Lileigh/Active-CAD/300 - C Powertrain/350 - Intake/Renders/Intake_assembly_render1.PNG

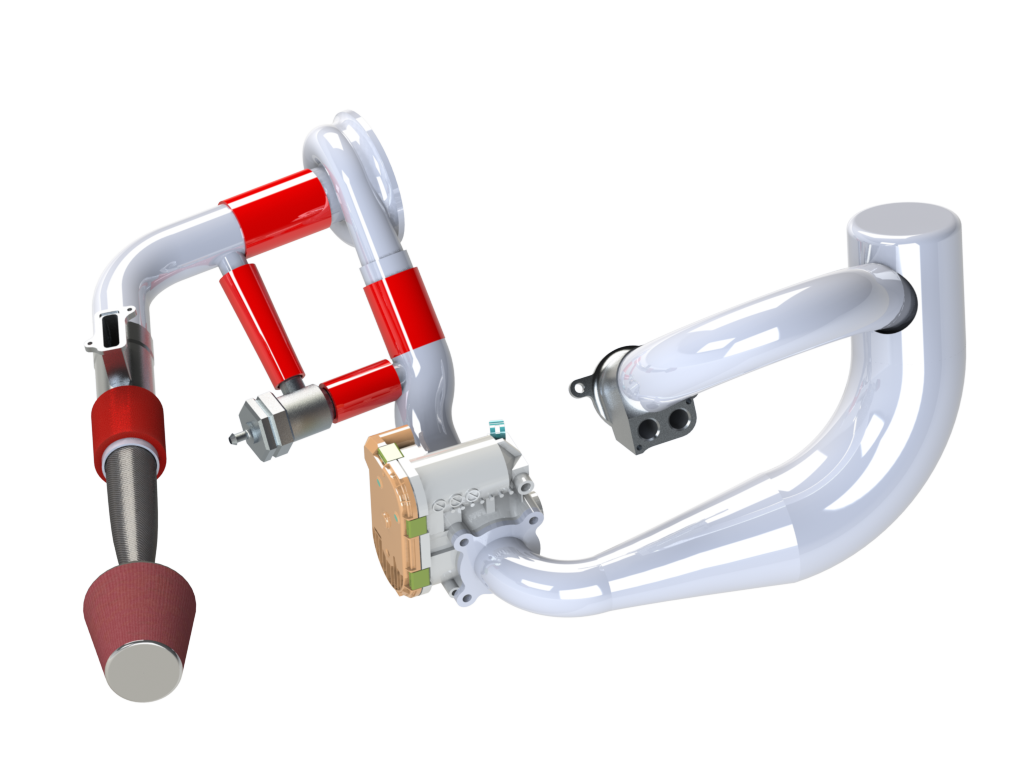
300 - C Powertrain/350 - Intake/Renders/Intake_assembly_render1.PNG
