Lileigh/Active-CAD/300 - C Powertrain/330 - Driveline/SPROCKET DESIGN.pptx

## SPROCKET DESIGN

BY GALEN RILEY

## GOALS

- Create a single piece sprocket
- Maintain critical dimensions so that sprocket fits with the current packaging
- Save weight via design optimization and use of 7075-T6 Aluminum

## GEOMETRY

- The formulas used to calculate the tooth geometry were taken from the American Chain Association Chains for Power Transmission and Material Handling handbook and should be compliant with industry standards…

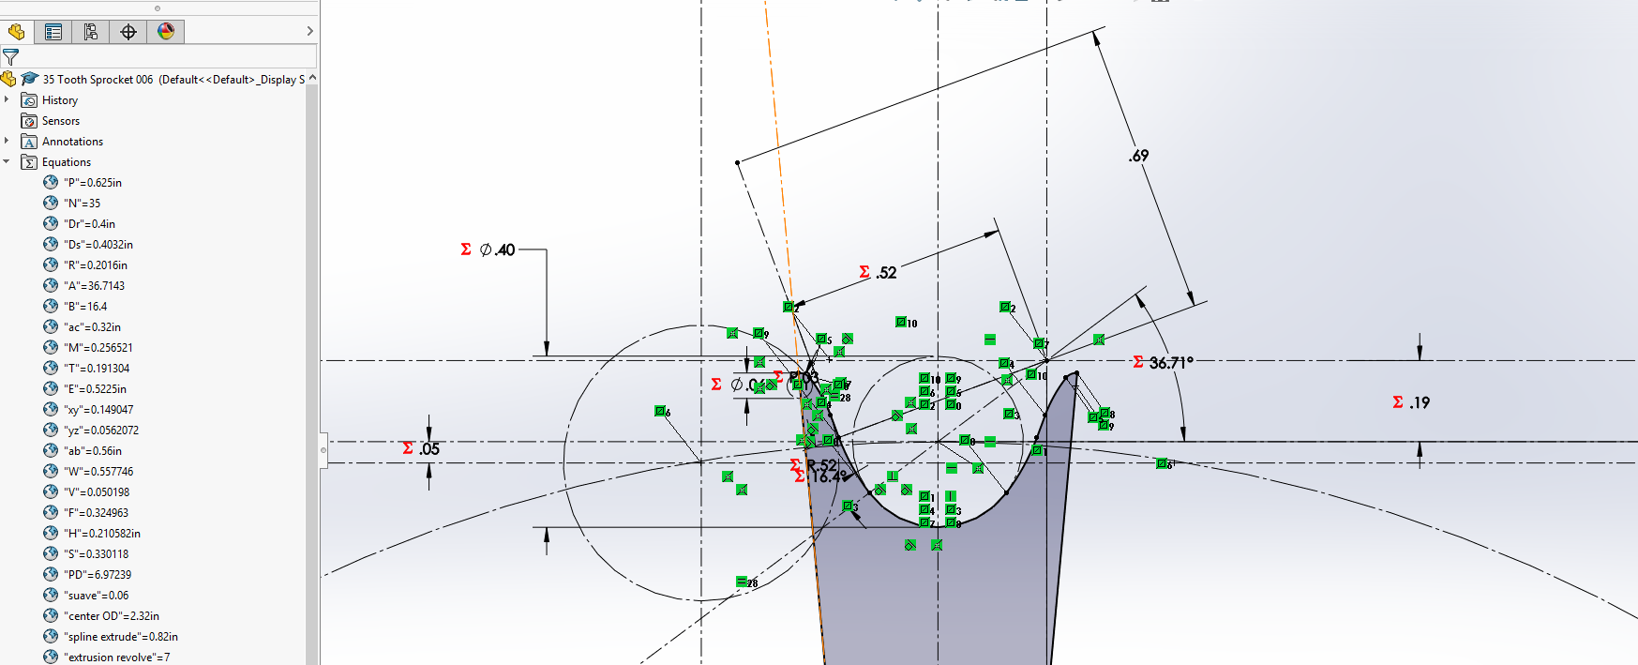
[picture p3: figure]

## SPROCKET LOAD CALCULATIONS

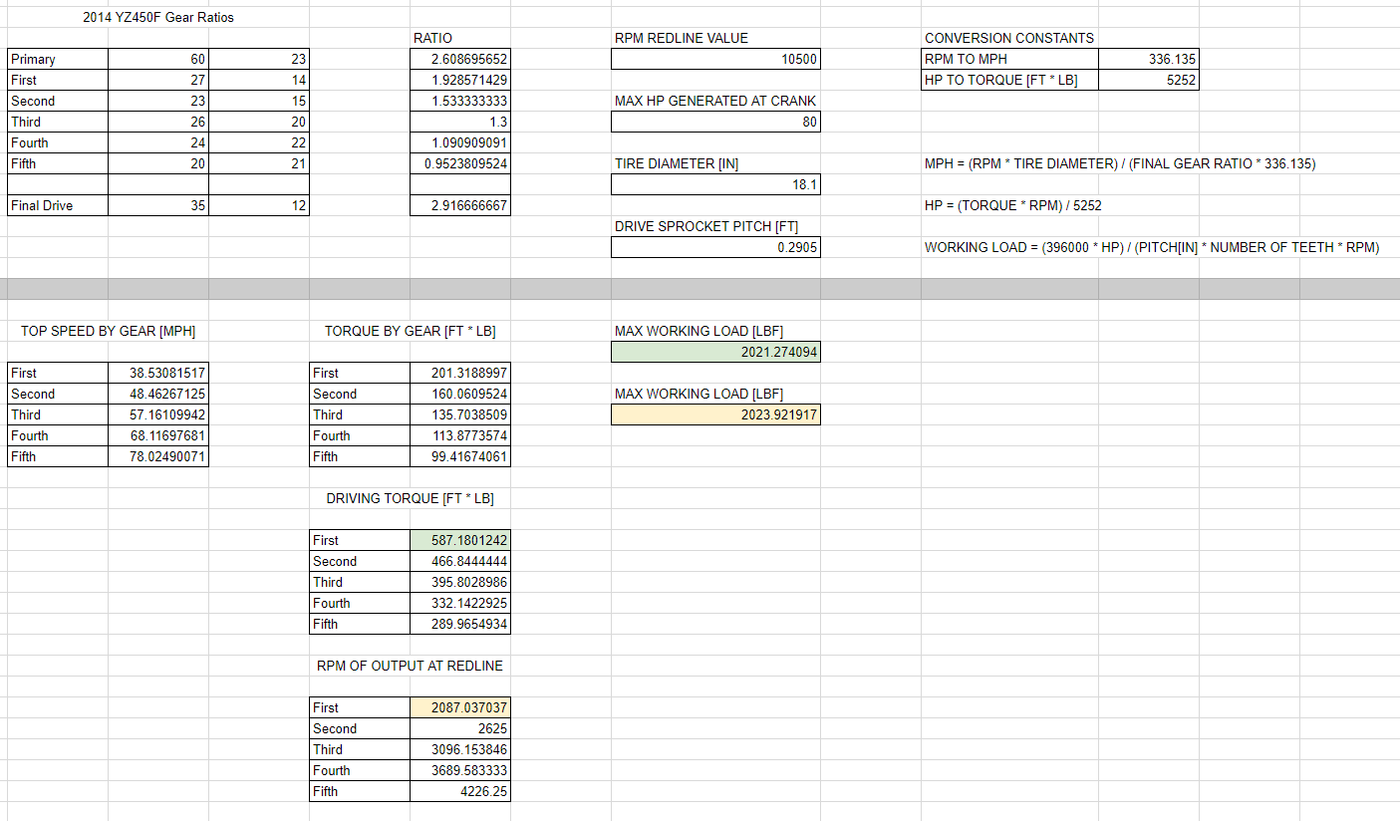
[picture p4: figure]

## LOAD DISTRIBUTION RESEARCH

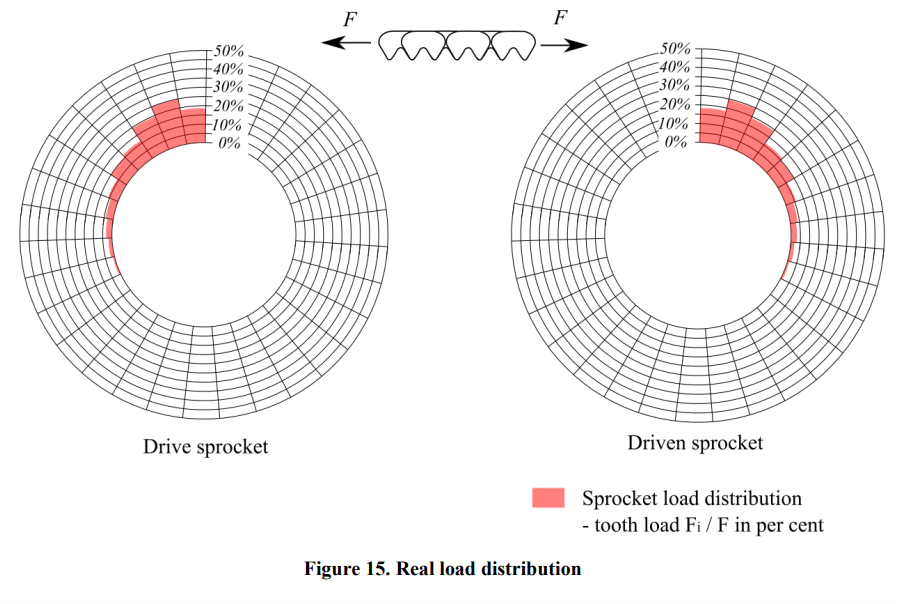
[picture p5: figure]

Research carried out by BorgWarner.

## FEA ANALYSIS IN SOLIDWORKS

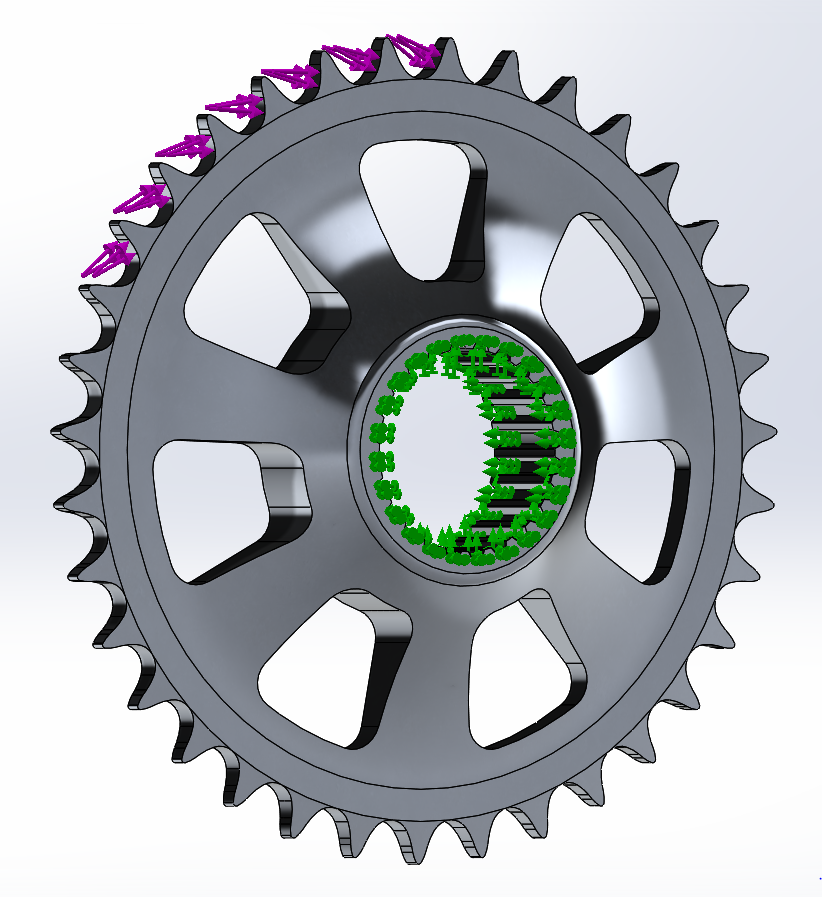
[picture p6: figure]
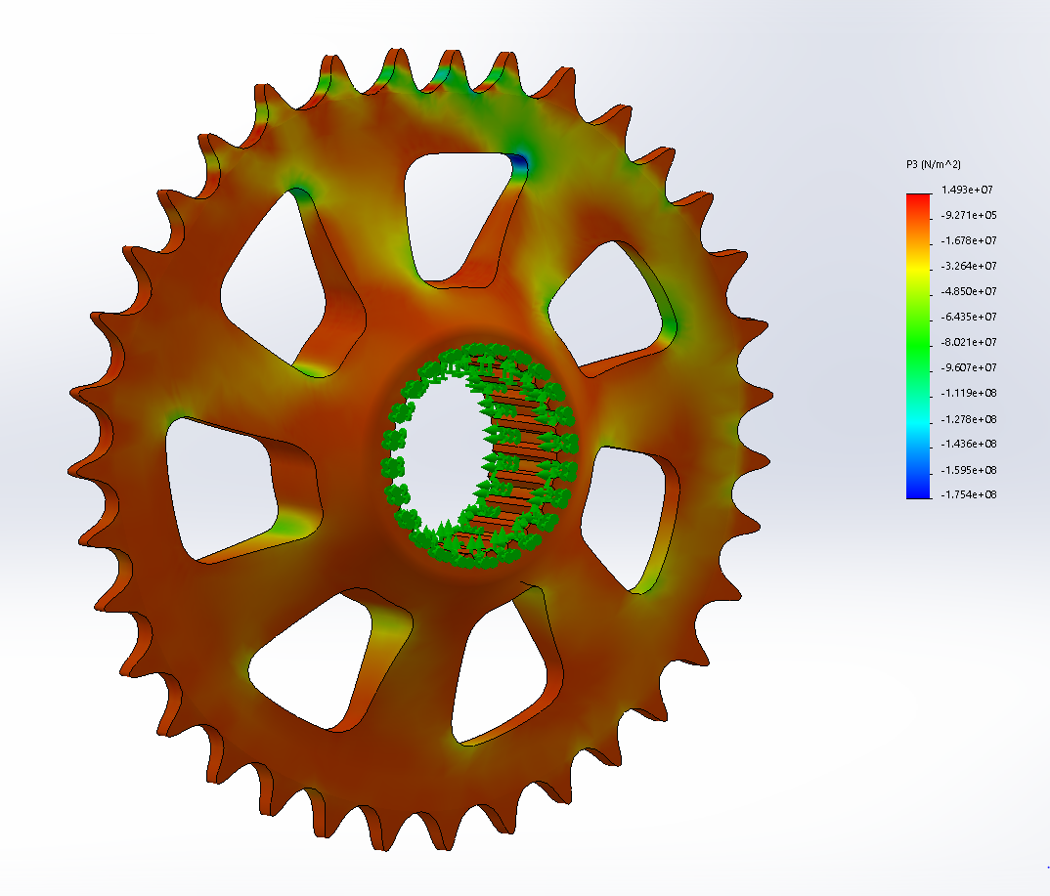
[picture p7: figure]

Force distribution applied
in accordance with
BorgWarner research
Maximum stress values
Observed in Third
Principal Direction
Overall FOS = 2.88

## SOLIDWORKS FATIGUE LIFE SIMULATION

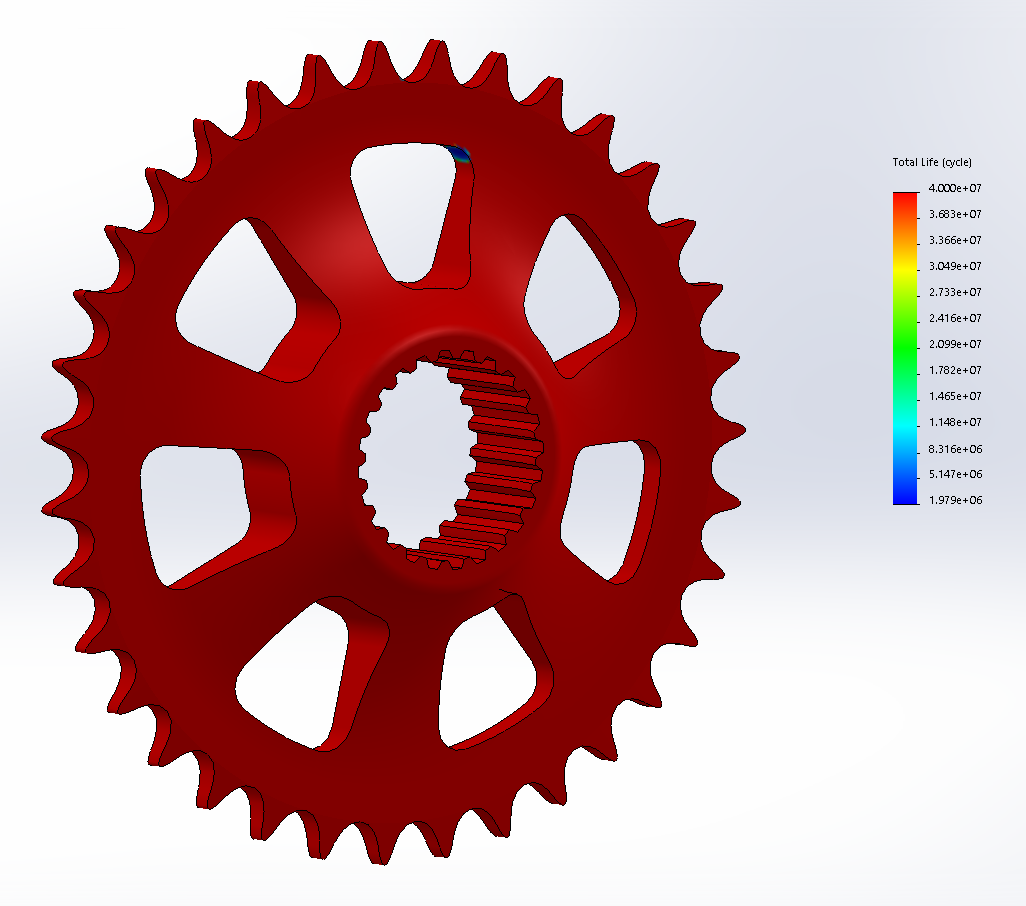
[picture p8: figure]

Revolutions per Endurance Event = 15,600

Solidworks estimated lifespan [cycles] = 1,979,000

Estimated lifespan of sprocket = 127 Endurance Events

Note: Loading events were zero based and scaled by
a factor of two for increased confidence in lifespan

## DYNAMIC LOADING SIMULATIONS

- Simulation of a clutch drop during an average accel. event

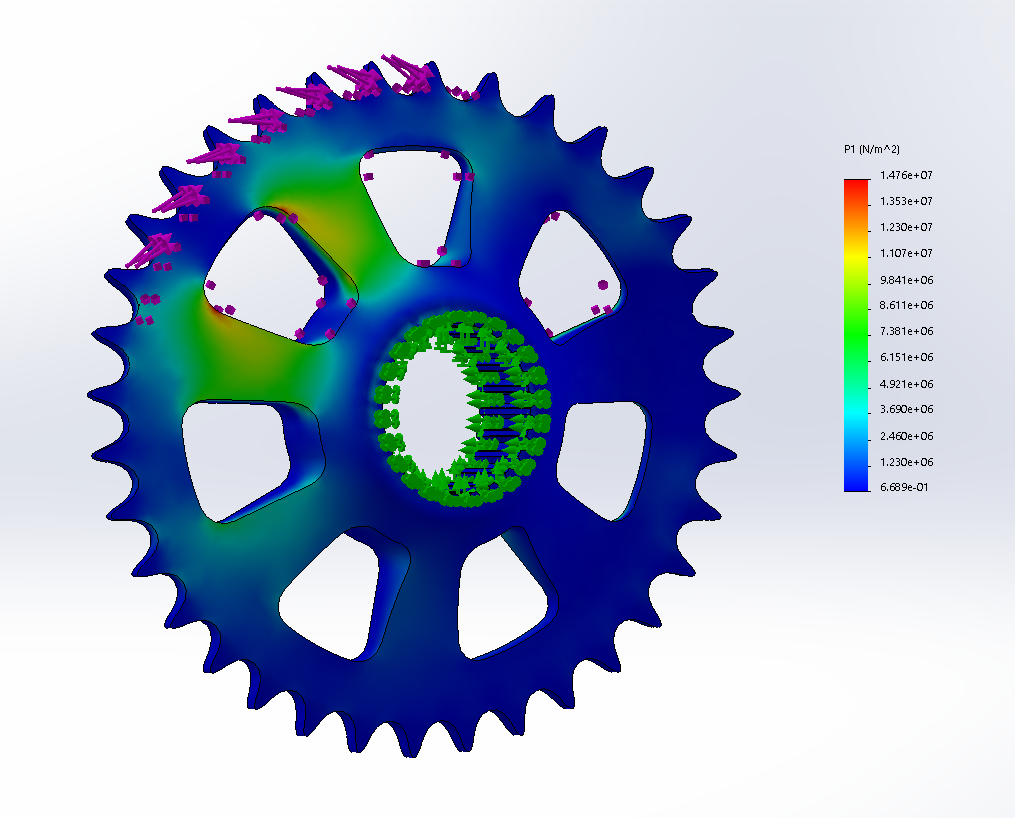
[picture p9: figure]

Maximum first principal stress observed during dynamic loading event

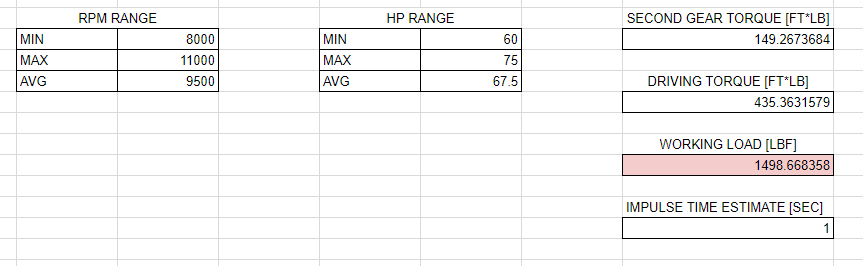
[picture p10: figure]
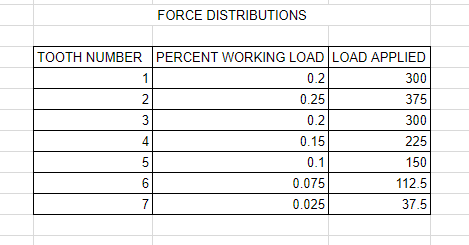
[picture p11: figure]

## LIMITATIONS OF SOLIDWORKS

- Unable to obtain full resolution of dynamic loading scenarios…
- Lacking computing power and disk space to enhance resolution of results

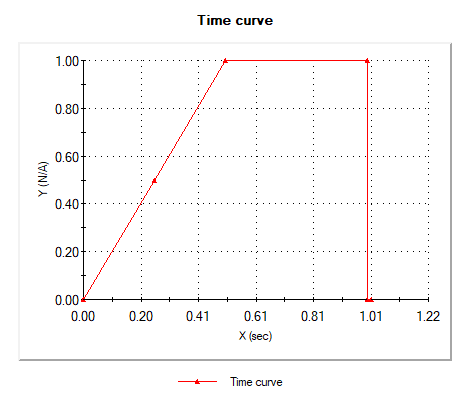
[picture p12: figure]
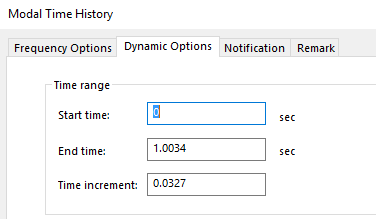
[picture p13: figure]

## CONCLUSION

- Created a single piece sprocket
- Sprocket will fit given packaging constraints
- Estimated sprocket weight = 1.05 lbs
- Two-piece sprocket weight (before hardware) = 1.99 lbs
- Lacking resolutiom in dynamic loading situations
