Lileigh/Active-CAD/300 - C Powertrain/330 - Driveline/SPROCKET FAB/Sprocket Stock.PNG

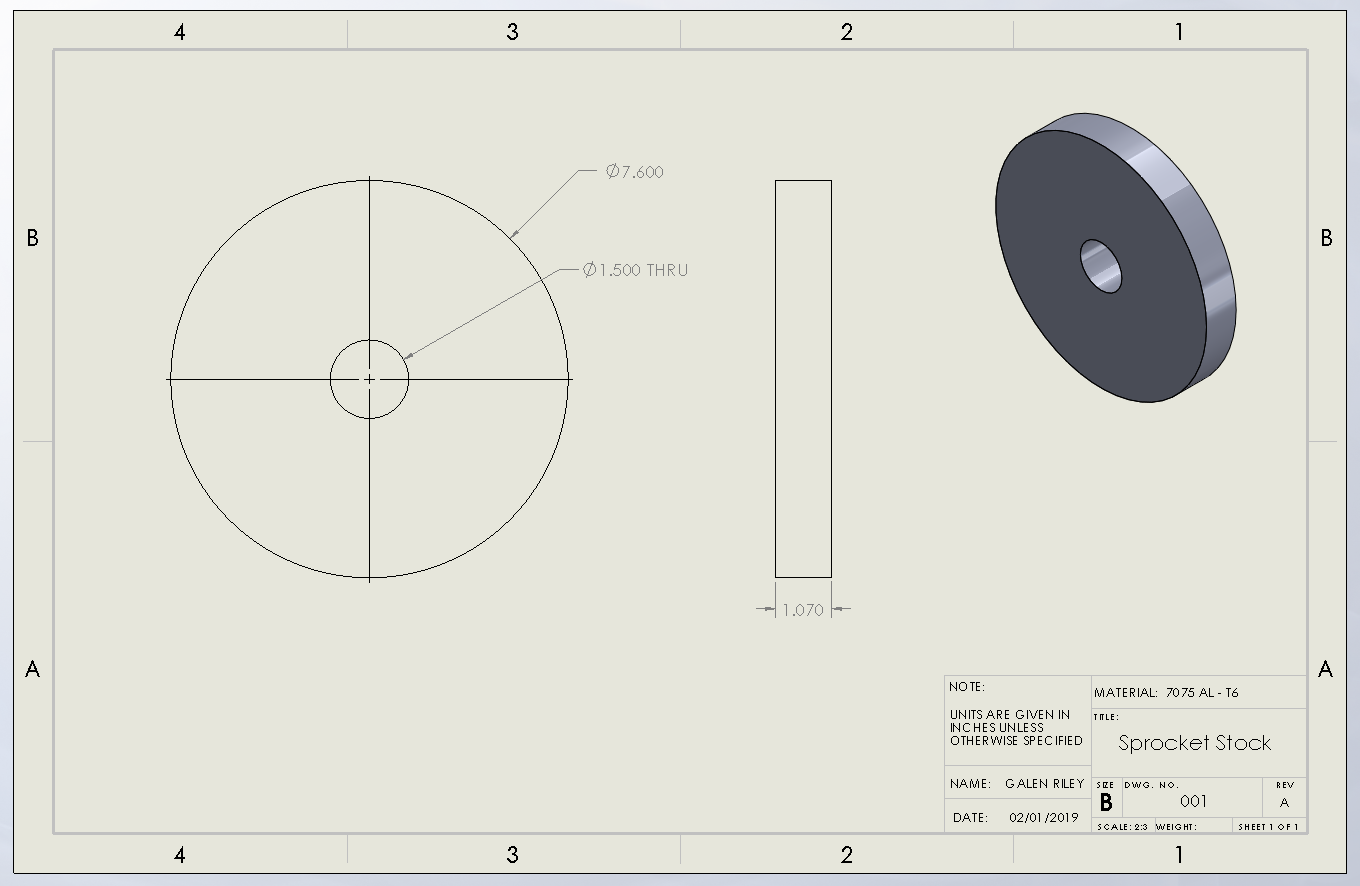
300 - C Powertrain/330 - Driveline/SPROCKET FAB/Sprocket Stock.PNG
