Lileigh/Active-CAD/200 - Chassis/Greenbay Anodizing Order.xlsx

 |  |  |  |  |  | Contact: | Josh Wendt | wendt@go.uwracing.com | (608) 520-7312
Part Number | Part Description | Quantity | Desired Color | Surface Area (in2) | Part Material
240-15-23-A | Wheelnut | 12 | Red |  | 7075 Alu
240-01-17-B | Camber Clevis | 14 | Red |  | 7075 Alu
211-19-23-A | Front Upper Inboard Clevis | 10 | Red |  | 7075 Alu
211-15-23B | Front Lower Inboard Clevis | 10 | Red |  | 7075 Alu
210-03-23B | Rear Inboard Clevis | 14 | Red |  | 7075 Alu
241-15-23-A | Front Toe Clevis | 3 | Red |  | 7075 Alu
242-15-23-A | Rear Toe Clevis | 3 | Red |  | 7075 Alu
 | Modified Rear Inboard | 4 | Red |  | 7075 Alu
 | Front Bellcrank | 8 | Red |  | 6061 Alu
 | Rear Bellcrank | 8 | Red |  | 6061 Alu
 | Front Bellcrank Mounts | 4 | Black |  | 6061 Alu
 | Bellcrank Spacer | 8 | Red |  | 6061 Alu
 | Front Damper Mount | 4 | Black |  | 6061 Alu
