Lileigh/Active-CAD/Manufacturing/Palmer Hamilton/Wisconsin Racing BOM.xlsx

Part Number | Part Name | QTY | Material | Thickness
250-01-11C | Brake Rotor | 5 | Dura-Bar G2 Cast Iron | 0.1 | (Stock provided by Wisconsin Racing as individual rounds)
281-09-22A | MHB Inboard Backing Plate | 2 | Mild steel | 0.1
282-05-22A | AI Backing Plate | 16 | Mild steel | 0.1
261-05-22B | Throttle mount APS | 1 | Mild steel | 0.1
261-07-22B | Throttle mount non-APS | 1 | Mild steel | 0.1
262-03-22A | Brake pedal mount L | 1 | Mild steel | 0.1
262-04-22A | Brake pedal mount R | 1 | Mild steel | 0.1
263-07-22A | Brake OT switch mount | 1 | Mild steel | 0.1
