Lileigh/Active-CAD/Manufacturing/JD Laser Order 222/WR Tube Request 2022.xlsx

Part Number | OD | Thickness | QTY | All 4130 Steel
211-01-22-A | 0.75 | 0.028 | 3
211-03-22-A | 0.75 | 0.028 | 3
211-05-22-A | 0.75 | 0.028 | 3
211-07-22-A | 0.75 | 0.028 | 3
212-01-22-A | 0.75 | 0.028 | 3
212-03-22-A | 0.75 | 0.028 | 3
212-05-22-A | 0.75 | 0.028 | 3
212-07-22-A | 0.75 | 0.028 | 3
223-01-22-A | 0.5625 | 0.035 | 10
223-03-22-A | 0.5625 | 0.035 | 6
223-05-22-A | 0.5625 | 0.035 | 4
223-07-22-A | 0.5625 | 0.035 | 4
280-011-22-A | 1.0000 | 0.095 | 3
280-013-22-A | 1.0000 | 0.065 | 3
280-014-22-A | 1.0000 | 0.065 | 3
280-015-22-A | 1.0000 | 0.065 | 6
BAJA-035 | 1.00 | 0.035 | 1 | 8-foot length of uncut tube if available
BAJA-049 | 1.00 | 0.049 | 1 | 8-foot length of uncut tube if available
