Lileigh/Active-CAD/Manufacturing/Ru-Mar/Request 1/Ru-Mar Wisconsin Racing BOM.xlsx

Part Number | Name | Type | QTY | Material
272-13-22A | Lower Mount Connection | Bent | 1 | 5052 0.125"
272-13-22A | Lower Mount Fork | Flat | 1
381-01-22A | Shift Mount | Bent | 1
381-03-22A | Shift Mount Front Tab | Bent | 2
381-05-22A | Shift Mount Rear Tab | Bent | 2
382-01-22A | Cyl Mount Tab R | Bent | 1
382-02-22A | Cyl Mount Tab L | Bent | 1
Bellcrank Assembly |  | Flat | 1 | 7075 0.625"
Bellcrank & Pedal Rail Assembly |  | Flat | 1
