Lileigh/Active-CAD/200 - Chassis/Drawings/Wisconsin Racing Machining List - Aztalan.xlsx

 |  |  |  |  |  | Contact: | Josh Gottlieb | gottlieb@go.uwracing.com | (414) 807-5917
 |  |  |  |  |  |  | Sam Roslansky | roslansky@go.uwracing.com | (952) 666-9463
 |  |  |  |  |  |  | Joshua Wendt | wendt@go.uwracing.com | (608) 520-7312
Part Number | Part Description | Material | Quantity | Priority | Part Drawing
240-01-17B | Camber Clevis | 7075 Aluminum | 14 | Low
221-01-23A | Front Damper Mount | 7075 Aluminum | 5 | High
390-02-23A | Oil Pan Adaptor | 6061 Aluminum | 2 | High
390-01-23A | Dry Sump Oil Pan | 6061 Aluminum | 2 | High
211-25-23A | Front Lower Inboard Clevis (AN5) | 7075 Aluminum | 5 | High
211-19-23A | Front Upper Inboard Clevis | 7075 Aluminum | 9 | High
