Lileigh/Active-CAD/200 - Chassis/210 - Control Arms/Control Arm Naming Guide.xlsx

Sheet: Parts
21X | -NN | Description | YY | R | 220-21X-XX | QTY | Status
210 - Files that carry over front and rear
 | 01 | Inboard Spherical Plate for PWB-4TG | 17 | B | 210-01B | 16 | Carry Over
 | 03 | Inboard Clevis | 22 | A | 214-01 |  | Done
 | 05 | Inboard Clevis Shim | 22 | A | 214-02 |  | Done | 0.3125 x 4 | 0.125 x 20 | 0.063 x 8 | 0.032 x 8
 | 07 | Inboard Clevis Inner Backing Plate | 22 | A | 280-?? |  | Needs Design
211 - Files specific to front control arms
 | 01 | F Upper Fore Tube | 22 | A | 211-06 | 3 | Done
 | 03 | F Upper Aft Tube | 22 | A | 211-07 | 3 | Done
 | 05 | F Lower Fore Tube | 22 | A | 211-08 | 3 | Done
 | 07 | F Lower Aft Tube | 22 | A | 211-09 | 3 | Done
 | 09 | F Upper OB Spherical Plate for HAB-4TG | 22 | B | 211-02 | 3 | Done | 444 (Tens) Fore, 5 (Tens) Aft |  |  |  | 271 (Tens) Fore, -130 (Comp) Aft | Attach Fore Tube First
 | 11 | F Lower OB Spherical Plate for HAB-4TG | 22 | A | 211-04 | 3 | Done | 1018 (Tens) Aft, -880 (Comp) Fore |  |  |  | 730 (Tens) Aft, -1099 (Comp) Fore | Attach Fore Tube First
 | 13 | F Pushrod Tab | 22 | A | 211-01 | 6 | Done
 | 15 | F Lower Inboard Clevis | 22 | A | 213-07 |  | Needs Design Refresh & FEA Run
 | 17 | F Lower Aft Inboard Clevis Spacer | 22 | A | New Part |  | Needs Design
 | 19 | F Lower Aft Inboard Clevis Backing | 22 | A |  |  | Needs Design
212 - Files specific to rear control arms
 | 01 | R Upper Fore Tube | 22 | A | 212-07 | 3 | Done
 | 03 | R Upper Aft Tube | 22 | A | 212-08 | 3 | Done
 | 05 | R Lower Fore Tube | 22 | A | 212-09 | 3 | Done
 | 07 | R Lower Aft Tube | 22 | A | 212-10 | 3 | Done
 | 09 | R Upper Outboard Spherical Plate | 22 | A | 212-02B | 3 | Done | 626 (Tens) Aft, -495 (Comp) Fore |  |  |  | 524 (Tens) Aft, -569 (Comp) Fore
 | 11 | R Lower Outboard Spherical Plate | 22 | A | 212-04B | 3 | Done | 1388 (Tens) Fore, -936 (Comp) Aft |  |  |  | 1212 (Tens) Fore, -1099 (Comp) Aft
 | 13 | R Pushrod Tab | 22 | A | 212-01 | 6 | Done
 | 15 | R Inner Tierod Mount | 17 | B | 212-06B | 3 | Carry Over

Sheet: Lug Calc Screenshots
210 - Files that carry over front and rear
 | 01 | Inboard Spherical Plate for PWB-4TG
 | 03 | Inboard Clevis
 | 05 | Inboard Clevis Shim
 | 07 | Inboard Clevis Inner Backing Plate
211 - Files specific to front control arms
 | 01 | F Upper Fore Tube
 | 03 | F Upper Aft Tube
 | 05 | F Lower Fore Tube
 | 07 | F Lower Aft Tube
 | 09 | F Upper OB Spherical Plate for HAB-4TG
 | 11 | F Lower OB Spherical Plate for HAB-4TG
 | 13 | F Lower OB Reinforcing Plate
 | 15 | F Pushrod Tab
 | 17 | F Lower Inboard Clevis
 | 19 | F Lower Aft Inboard Clevis Spacer
 | 21 | F Lower Aft Inboard Clevis Backing
212 - Files specific to rear control arms
 | 01 | R Upper Fore Tube
 | 03 | R Upper Aft Tube
 | 05 | R Lower Fore Tube
 | 07 | R Lower Aft Tube
 | 09 | R Upper Outboard Spherical Plate
 | 11 | R Lower Outboard Spherical Plate
 | 13 | R Pushrod Tab
 | 15 | R Inner Tierod Mount
