Lileigh/Active-CAD/Manufacturing/Ru-Mar/Request 2/Wisconsin Racing Revised Ru-Mar Request.xlsx

Part Number | Name | Type | QTY | Material | Thickness
272-13-22A | Lower Mount Connection | Bent | 1 | 5052 | 0.125
272-15-22A | Lower Mount Fork | Flat | 1
381-01-22A | Shift Mount | Bent | 1
381-03-22A | Shift Mount Front Tab | Bent | 2
381-05-22A | Shift Mount Rear Tab | Bent | 2
382-01-22A | Cyl Mount Tab R | Bent | 1
382-02-22A | Cyl Mount Tab L | Bent | 1
210-05-22B | Suspension Shim 0.25 deg | Flat | 8 | 6061 | 0.032
240-03-17B | Camber Shim 0.25 deg | Flat | 6
211-17-22A | Lower Suspension Spacer | Flat | 6
210-05-22B | Suspension Shim 0.5 deg | Flat | 8 | 6061 | 0.063
240-03-17B | Camber Shim 0.5 deg | Flat | 14
250-05-11B | Brake Float Tab | Flat | 30
283-210-03 | Suspension Backing | Flat | 14 | 6061 | 0.08
283-211-15 | Lower F. Susp Backing | Flat | 2
283-273-23 | Lower Steer Backing | Flat | 2
283-272-07 | Upper Steer Backing | Flat | 3
283-221-01 | F Bellcrank Backing | Flat | 5
283-222-01 | R Fore Bellcrank Backing | Flat | 2
283-222-03 | R Aft Bellcrank Backing | Flat | 2
283-335-06 | Diff R Backing | Flat | 1
283-335-05 | Diff L Single Backing | Flat | 3
283-310-15 | Lower Engine Backing | Flat | 2
283-310-03 | Upper Engine R Backing | Flat | 1
283-263-03 | Pedal Brake Side Backing | Flat | 1
283-263-05 | Pedal Single Backing | Flat | 4
210-05-22B | Suspension Shim 1 deg | Flat | 20 | 6061 | 0.125
240-03-17B | Camber Shim 1 deg | Flat | 14
211-17-22A | Lower Suspension Spacer | Flat | 6
240-03-17B | Camber Shim 2 deg | Flat | 6 | 6061 | 0.25
230-13-22-A | Antiroll Mid Plate | Flat | 6
210-05-22B | Suspension Spacer | Flat | 4 | 6061 | 0.3125
