Lileigh/Active-CAD/(list of files, cad)

Other CAD files:
000 - Full Vehicle/1000 - Full Vehicle/1000-5000-23 - Ccar 223.SLDASM
000 - Full Vehicle/1000 - Full Vehicle/1002 - Livery Misc/1000-8000-23 - Assembly for Livery 3-view.SLDASM
000 - Full Vehicle/Three View Drawing/3VD FCA.SLDASM
100 - Aero & Ergo/0 223 Aero Dev Folder/1100 - Aero & Composites/1100-5000-23C - Aero & Composites Assembly CCar.SLDASM
100 - Aero & Ergo/0 223 Aero Dev Folder/1100 - Aero & Composites/1103 - Undertray/1103 - 5000 - 23 - Undertray.SLDASM
100 - Aero & Ergo/0 223 Aero Dev Folder/1100 - Aero & Composites/1104 - Sidepods/1104 - 5000 - 23 - Sidepods.SLDASM
200 - Chassis/200-000-23A.SLDASM
200 - Chassis/2023 Jigs/Front LCA Jig.SLDASM
200 - Chassis/210 - Control Arms/210-00-23-A.SLDASM
200 - Chassis/220 - Actuation/Kaz Ohlins Mk2 Damper/Kaz Ohlins Mk2 Damper Body_Adjustable.SLDASM
200 - Chassis/230 - Antiroll/230-00-22-A.SLDASM
200 - Chassis/230 - Antiroll/Kaz Ohlins Mk2 Damper/Kaz Ohlins Mk2 Damper Body_Adjustable.SLDASM
200 - Chassis/240 - Corners/Ccar/241 - Front Corners/Front/Front Hub Assembly.SLDASM
200 - Chassis/240 - Corners/Ccar/242 - Rear Corners/242-00-23A.SLDASM
200 - Chassis/240 - Corners/Ccar/242 - Rear Corners/Rear/Rear Hub Assembly.SLDASM
200 - Chassis/240 - Corners/Ccar/Cost Report Drawings/Front Upright Assembly.SLDASM
200 - Chassis/240 - Corners/Ecar/240-00-23-Ecar.SLDASM
200 - Chassis/240 - Corners/Ecar/Front Corner/241-00-23-Ecar.SLDASM
200 - Chassis/240 - Corners/Ecar/Rear Corner/242-00-23-Ecar.SLDASM
200 - Chassis/260 - Pedals/260-00-22A.SLDASM
200 - Chassis/270 - Steering/223 Steering/270-00-23-A.SLDASM
200 - Chassis/270 - Steering/223 Steering/273 - Lower Steering/273-00-23A.SLDASM
200 - Chassis/270 - Steering/270-00-22-A.SLDASM
200 - Chassis/270 - Steering/271-New-Steering Wheel/223 SteeringWheel/Electrical Parts/PARTT2M/SOLIDWORKS/T2M_108_01_L_D_RA_WT.sldasm
200 - Chassis/270 - Steering/273 - Lower Steering/273-00-22A.SLDASM
200 - Chassis/280 - Structures/280-00-22-A.SLDASM
200 - Chassis/290 - Data AQ/291 - Tire Temp/291 - Front Left.SLDASM
200 - Chassis/Control Arm/Rear Upper A-Arm.SLDASM
300 - C Powertrain/0 223 Powertrain Dev Folder/1300 - 23 - Powertrain.SLDASM
300 - C Powertrain/301-00-22 B.SLDASM
300 - C Powertrain/330 - Driveline/330-00-23B (Skeleton Assembly).SLDASM
300 - C Powertrain/330 - Driveline/337-Clutch Handle/218-337-00b.SLDASM
300 - C Powertrain/340 - Turbo/340-00-20A.SLDASM
300 - C Powertrain/350 - Intake/351-PreTurbo/Preturbo assembly.SLDASM
300 - C Powertrain/350 - Intake/Misc and Manufacturing/218-352-01 Jig ass.SLDASM
300 - C Powertrain/350 - Intake/Renders/Intake_assembly_render.SLDASM
300 - C Powertrain/360 - Exhaust/360-00-22-A.SLDASM
300 - C Powertrain/360 - Exhaust/362 - Muffler/362-00-20-A.SLDASM
300 - C Powertrain/370 - Cooling/370-00-20A.SLDASM
300 - C Powertrain/370 - Cooling/371 - Radiator/371-00-22A.SLDASM
300 - C Powertrain/370 - Cooling/372 - Hot Bottle/372-00-20A Hot Bottle.SLDASM
300 - C Powertrain/370 - Cooling/373 - Lines/373-00-20A Cooling Lines.SLDASM
300 - C Powertrain/370 - Cooling/376 - Fan/376-00-22A.SLDASM
300 - C Powertrain/380 - Shifting/380-00-22-B.SLDASM
300 - C Powertrain/380 - Shifting/381 - Shift Shaft/381-00-22-B.SLDASM
300 - C Powertrain/380 - Shifting/382 - Cylinder/382-00-22-B.SLDASM
300 - C Powertrain/380 - Shifting/382 - Cylinder/Parker 0.75 x 1/Grainger-49J635.SLDASM
300 - C Powertrain/C Powertrain Dev/1300 - C Powertrain/1300-5000-23 - Powertrain Assembly.SLDASM
400 - E Drivetrain/430 - Cooling/223e-431-000 Cold Plate Connection Assy.SLDASM
400 - E Drivetrain/430 - Cooling/Cold Plate/223e-342-000.SLDASM
400 - E Drivetrain/440 - Dyne/Coupling Assembly/CouplingAssembly.SLDASM
400 - E Drivetrain/450 - Penthouse/Bus Bar Manufacturing/DXFS/0.125 inch Bus Bar Layout.SLDASM
700 - C Electronics/1700 - C Electronics Dev/1703-5000-23 - Accelerometer Assembly.SLDASM
900 - Jigs, Fixtures, Shop Items/Jigs/217-221 cCar Rear Frame/Plates/Engine Case Plates.SLDASM
900 - Jigs, Fixtures, Shop Items/Jigs/219-221 Main Roll Hoop/219-289-00-01.SLDASM
900 - Jigs, Fixtures, Shop Items/Jigs/222 Rotary Bell Crank/Rotary Assemblies/L Fore Rotary Bellcrank.SLDASM
900 - Jigs, Fixtures, Shop Items/Test Fixtures/Anti-Sub Test Fixture/Test Fixture Assembly.SLDASM
Cost Report/Cost-FR-Assem.SLDASM
Manufacturing/Makerspace Waterjetting/5052 0.036 Fueling Parts/Fueling Parts 0.036 5052.SLDASM
Manufacturing/Makerspace Waterjetting/5052 0.063/5052 0.063 Batch 1.SLDASM
Manufacturing/Makerspace Waterjetting/5052 0.1/5052 0.1 Full Batch.SLDASM
Manufacturing/Makerspace Waterjetting/7075 0.5 Rear Bellcrank Mount Spacers/Rear Bellcrank Mount Spacer - 7075 0.5.SLDASM
Manufacturing/Makerspace Waterjetting/7075 0.625/Bellcrank Waterjet Assembly Block B.SLDASM
Manufacturing/Makerspace Waterjetting/Mild 0.1/Mild 0.1 Run 2.SLDASM
Manufacturing/QC Batch 1 222/4130 0.25.SLDASM
Manufacturing/Ru-Mar/Request 1/5052 0.125.SLDASM
Manufacturing/Ru-Mar/Request 1/Parts to Compress/Bellcrank Assembly Single Part.SLDPRT
Manufacturing/Teamlab Waterjetting/222/7075 0.625/Pedal Rail and Bellcrank WJ Assy Redone.SLDASM
Manufacturing/Teamlab Waterjetting/223/Spherical B2.SLDASM
000 - Full Vehicle/1000 - Full Vehicle/1002 - Livery Misc/1001-8001-Chassis scrap assembly for simple 3-view.SLDASM
100 - Aero & Ergo/0 223 Aero Dev Folder/1100 - Aero & Composites/1101 - Front Wing/1101-5007-23 - Goosneck Assembly (right).SLDASM
100 - Aero & Ergo/0 223 Aero Dev Folder/1100 - Aero & Composites/1102 - Nosecone & Aeroshield/1102 - 5000 - 23 - Nosecone & Aeroshield.SLDASM
100 - Aero & Ergo/0 223 Aero Dev Folder/1100 - Aero & Composites/1106 - Headrest Cowling/1106 - 5000 - 23 - Headrest Cowling.SLDASM
100 - Aero & Ergo/0 223 Aero Dev Folder/1100 - Aero & Composites/1107 - Rear Wing/1107 - 5000 - 23 - Rear Wing.SLDASM
200 - Chassis/1200 - Chassis Dev/1220-5000-23 - Actuation Assembly.SLDASM
200 - Chassis/2023 Jigs/Rear UCA Jig.SLDASM
200 - Chassis/220 - Actuation/223 - Adjustment Rods/Pushrods/Front Pushrod.SLDASM
200 - Chassis/230 - Antiroll/Kaz Ohlins Mk2 Damper/Kaz Ohlins Mk2 Damper.SLDASM
200 - Chassis/240 - Corners/Ccar/241 - Front Corners/241-00-23-A.SLDASM
200 - Chassis/240 - Corners/Ccar/Cost Report Drawings/Rear Upright Assembly.SLDASM
200 - Chassis/250 - Brakes/251-00-17B.SLDASM
200 - Chassis/260 - Pedals/261 - Throttle/261-00-22A.SLDASM
200 - Chassis/260 - Pedals/263 - Pedal Rails/263-00-22-A.SLDASM
200 - Chassis/270 - Steering/271 - Steering Wheel/147 - Steering Wheel/220-147-01.SLDASM
200 - Chassis/270 - Steering/271-New-Steering Wheel/223 SteeringWheel/Electrical Parts/PARTserver/PARTserver/SOLIDWORKS/LS2_115_01_F_D.sldasm
200 - Chassis/280 - Structures/282 - Front Structures/282-00-22-A.SLDASM
200 - Chassis/280 - Structures/284 - Aeroshield Mounts/aeroshield assembly.SLDASM
200 - Chassis/Dev Assembly/Dev Assembly.SLDASM
300 - C Powertrain/300-000-22A.SLDASM
300 - C Powertrain/320 - Fueling/321-Tank/321-00-23A.SLDASM
300 - C Powertrain/320 - Fueling/323-Filter/323-00-23-A.SLDASM
300 - C Powertrain/320 - Fueling/Misc and Machining/Oring groove and jig ass.SLDASM
300 - C Powertrain/330 - Driveline/330-00-22A.sldasm
300 - C Powertrain/330 - Driveline/333-CV Joints/D4672-TA.SLDASM
300 - C Powertrain/330 - Driveline/334-Stub Shafts and Half Shafts/219/LHS HALFSHAFT ASSY.SLDASM
300 - C Powertrain/330 - Driveline/335-Mounting/4EXP075/4exp075.SLDASM
300 - C Powertrain/340 - Turbo/340-01-20A Dyno.SLDASM
300 - C Powertrain/350 - Intake/350-00-20A.SLDASM
300 - C Powertrain/350 - Intake/352-PostTurbo/352-00-20A Post Throttle Intake.sldasm
300 - C Powertrain/350 - Intake/358-Air Filter/Rain Shroud/3D Print/Filter_Shroud_print.SLDASM
300 - C Powertrain/370 - Cooling/371 - Radiator/Modine Radiator.SLDASM
300 - C Powertrain/390 - Oiling/391-00-18A Oil Temp_Pressure Block.SLDASM
400 - E Drivetrain/430 - Cooling/Cold Plate/Standoff Hole Mounting Location Assy.SLDASM
400 - E Drivetrain/450 - Penthouse/Bus Bar Manufacturing/DXFS/0.05 inch Upper DC Bus Bar Layout.SLDASM
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
