Lileigh/Active-CAD/300 - C Powertrain/330 - Driveline/SPROCKET FAB/SPROCKET FABRICATION.docx

WISCONSIN RACING FORMULA SAE – SPROCKET FABRICATION PROCESS

UNIVERSITY OF WISCONSIN – MADISON, SPRING 2019

GALEN RILEY

JANUARY 23RD, 2019

1. START WITH STOCK MATERIAL – 8’’ DIA X 3.0’’ ROUND STOCK (7075 – T6 ALUMINUM).
2. SQUARE STOCK USING A LATHE AND TURN DOWN TO 7.6’’ DIAMETER.

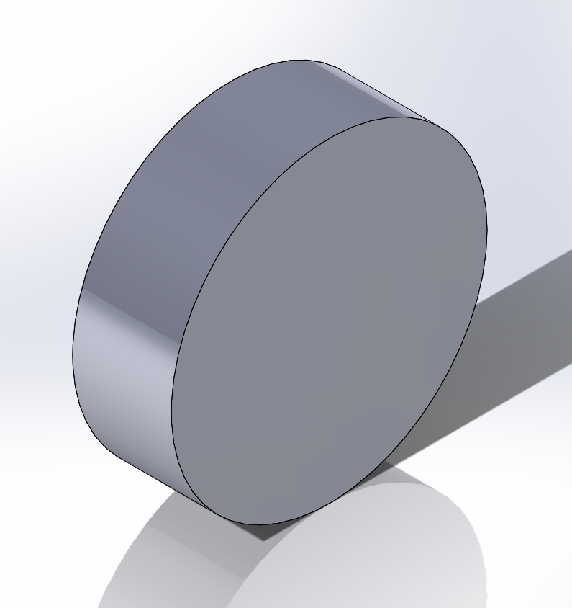
[picture p17: figure]

3. PROCEED TO BORE A HOLE WITH A 1.5’’ DIAMETER.

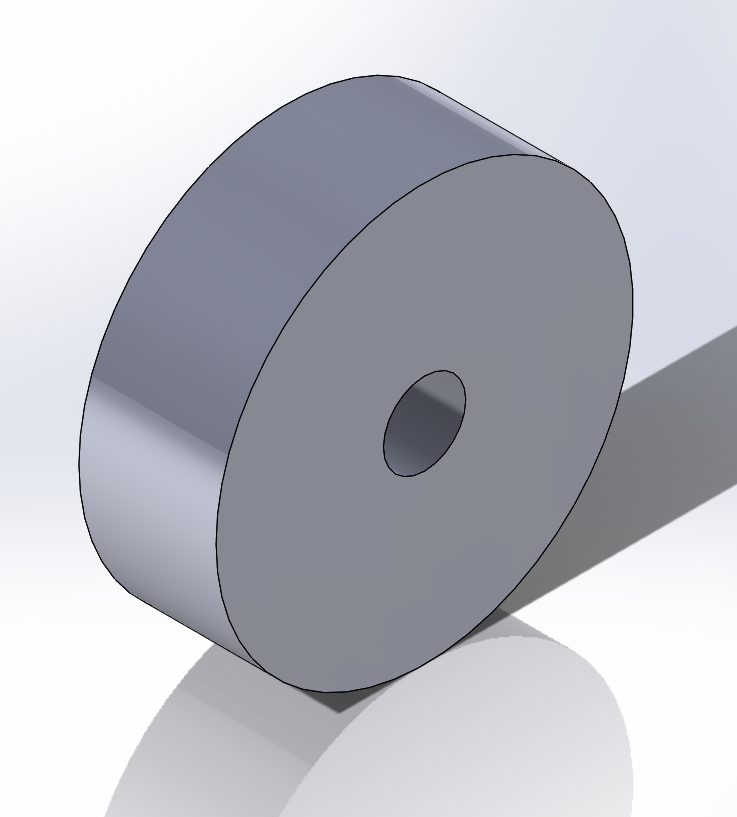
[picture p18: figure]

4. USING THE “T-REX” BAND SAW IN THE STUDENT SHOP, PART THE STOCK EXACTLY IN HALF. YOU SHOULD NOW HAVE TWO PIECE OF STOCK WITH A THICKNESS OF ROUGHLY 1.50’’
5. RETURN TO THE LATHE AND CUT EACH OF THE TWO PIECES DOWN TO THEIR FINAL THICKNESS OF 1.07’’ ENSURING THAT BOTH FACES ON EACH PIECE OF STOCK IS SQUARE.

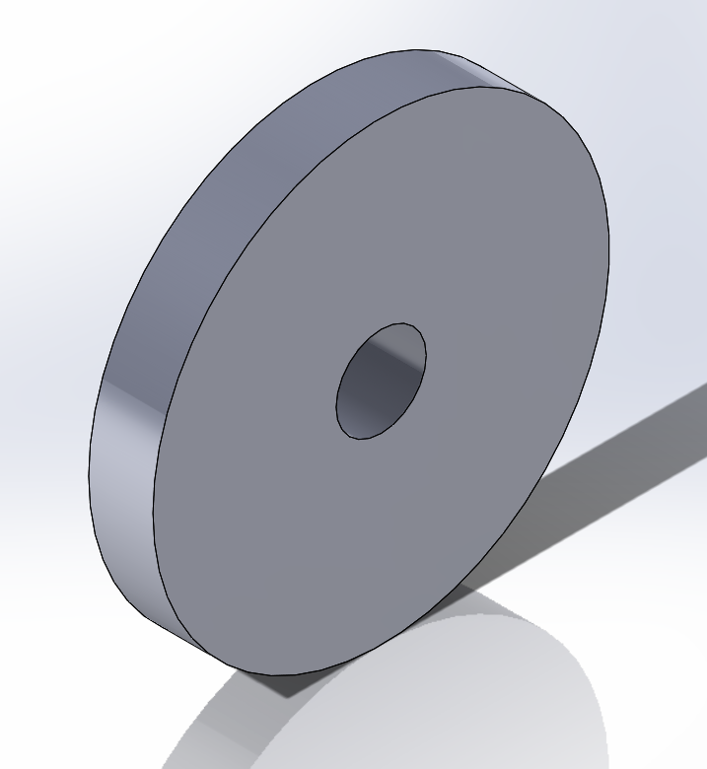
[picture p19: figure]

6. USING THE HAAS (OR A CNC LATHE), CAREFULLY FIXTURE THE PART UTILIZING THE BORED OUT FEATURE AND CUT THE SPROCKET PROFILE GEOMETRY INTO THE STOCK. (SANDING MAY BE REQUIRED).

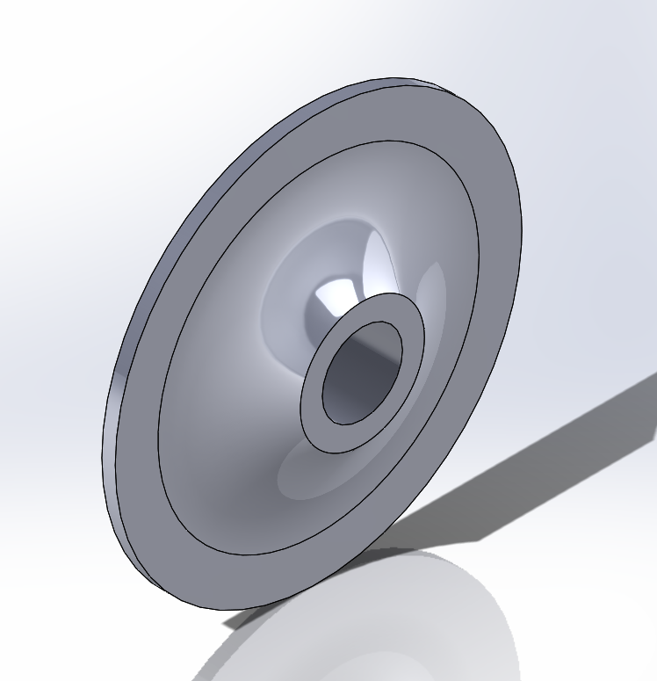
[picture p20: figure]

7. USING THE HAAS (OR A CNC LATHE), USE SIMILAR FIXTURING TECHNIQUES FROM STEP 6 TO CUT THE SPROCKET TOOTH TAPER INTO BOTH SIDES OF THE STOCK. (SANDING MAY BE REQUIRED).

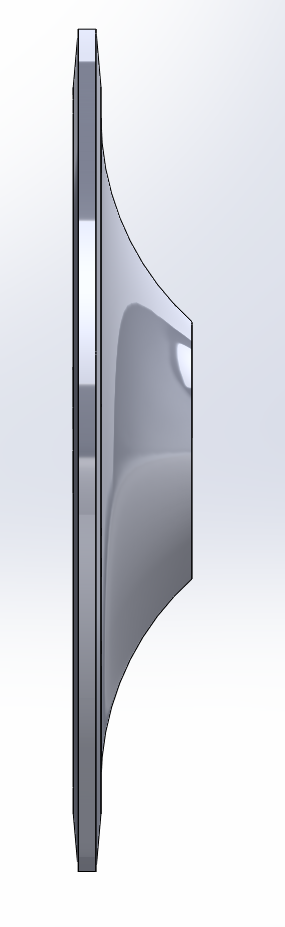
[picture p21: figure]
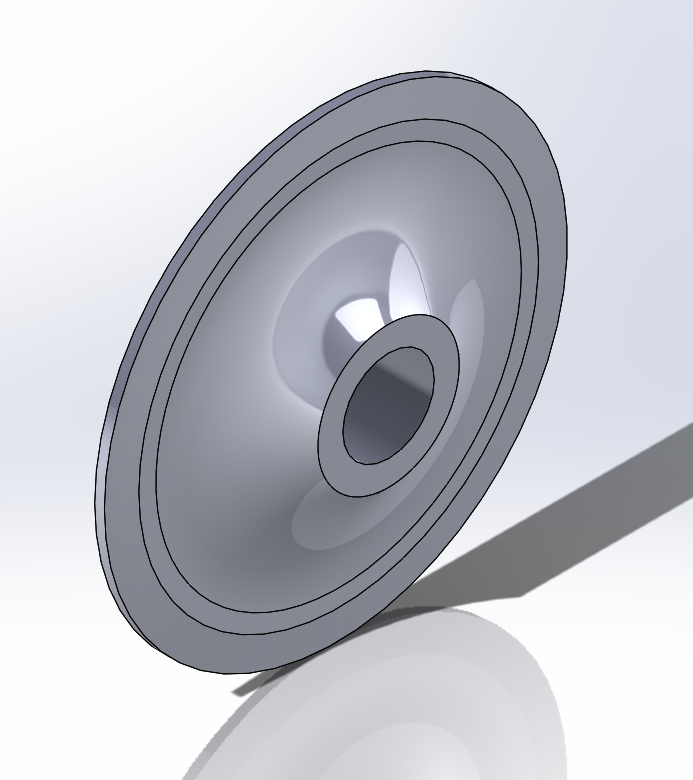
[picture p22: figure]

8. SEND STOCK TO WEASLER TO HAVE THEM WIRE EDM THE DIFFERENTIAL SPLINE GEOMETRY AND THE SPROCKET TOOTH GEOMETRY.
9. USING THE HAAS, CUT THE SPOKE GEOMETRY INTO THE SPROCKET.

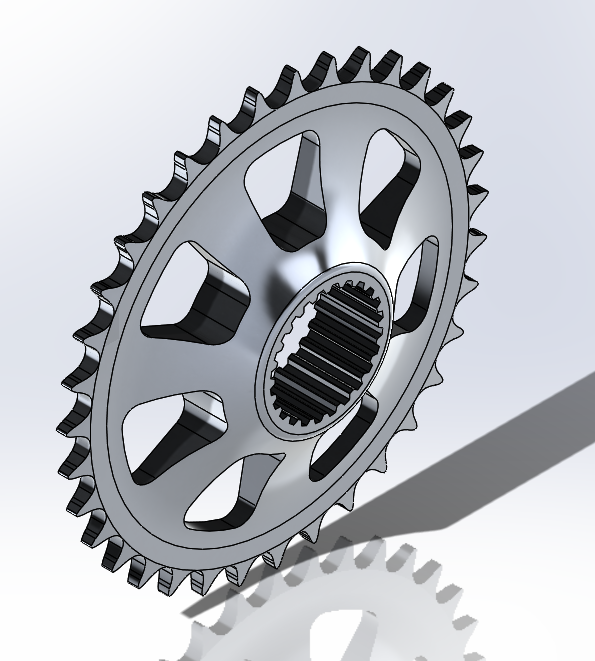
[picture p23: figure]

NOTE: CONSIDER REVERSING STEP 8 AND STEP 9 BASED OFF OF HOW EASY IT IS TO FIXTURE THE PART.
