Lileigh/Active-CAD/300 - C Powertrain/350 - Intake/Renders/Intake_assembly_render.JPG

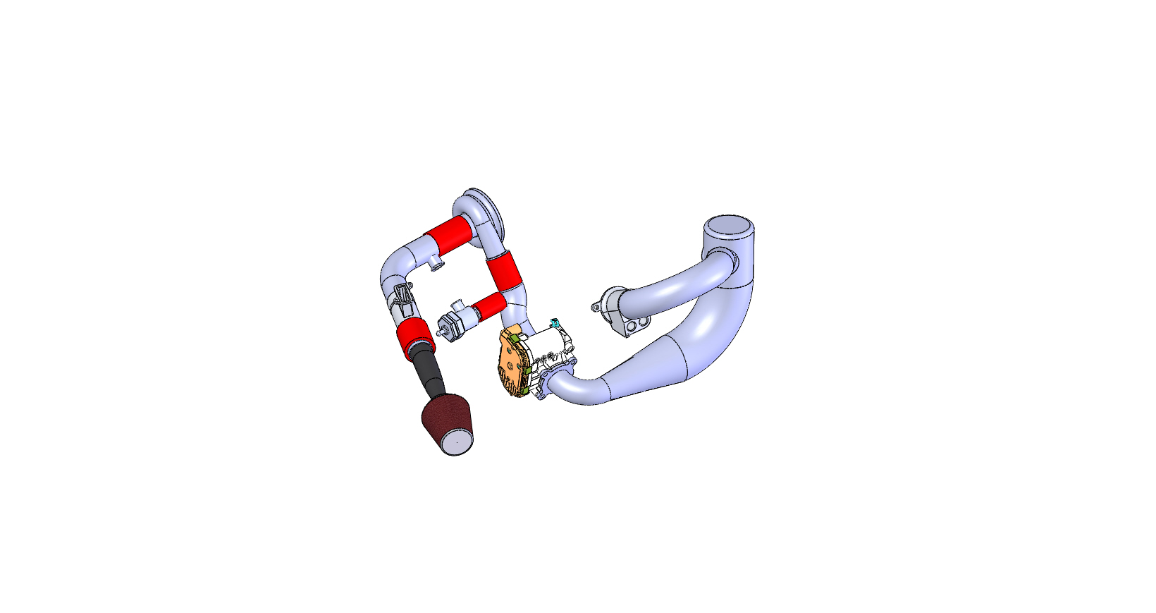
300 - C Powertrain/350 - Intake/Renders/Intake_assembly_render.JPG
