Lileigh/Active-CAD/900 - Jigs, Fixtures, Shop Items/Test Fixtures/Ride Steer Test Fixture/FIX-201-01-22-A rev02.PDF

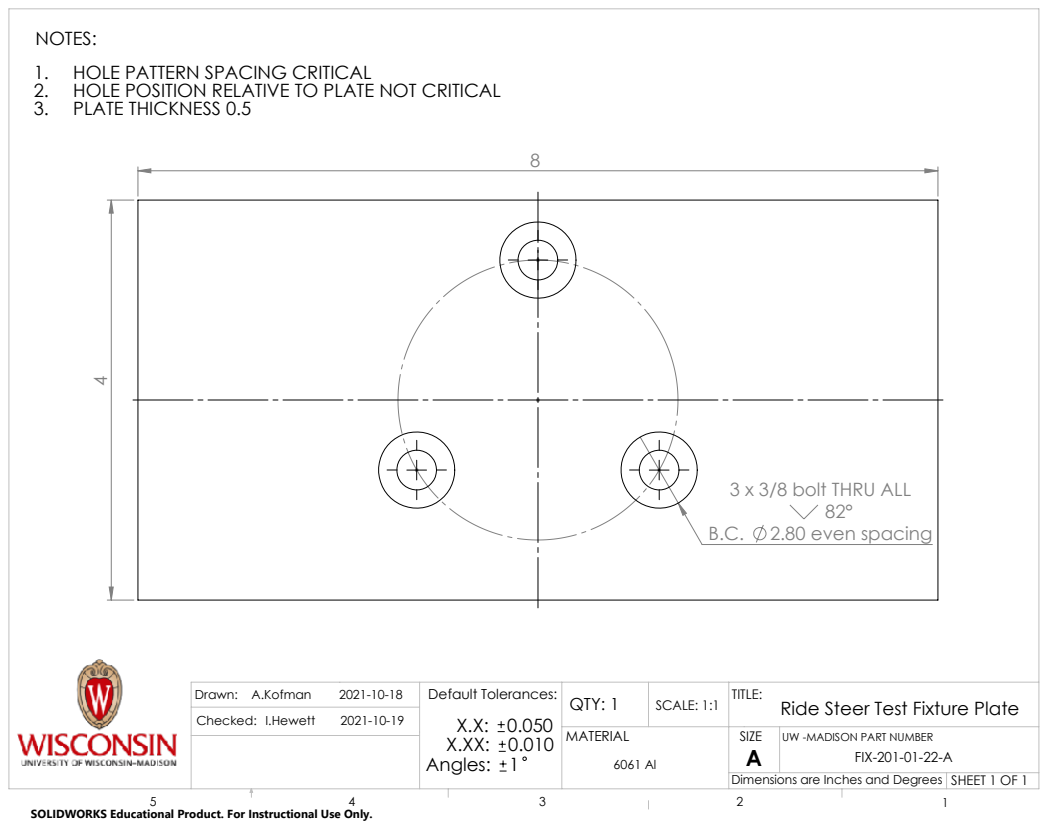
[picture p32: page 1]
SHEET 1 OF 1; SCALE: 1:1; FIX-201-01-22-A 6061 Al; QTY: 1 A.Kofman; Default Tolerances:; Checked: I.Hewett

NOTES:
1. HOLE PATTERN SPACING CRITICAL
2. HOLE POSITION RELATIVE TO PLATE NOT CRITICAL
3. PLATE THICKNESS 0.5

3 x 3/8 bolt THRU ALL
B.C. 2.80 even spacing

TITLE:
Ride Steer Test Fixture Plate
SIZE
UW -MADISON PART NUMBER
Dimensions are Inches and Degrees

SOLIDWORKS Educational Product. For Instructional Use Only.
