Lileigh/Active-CAD/900 - Jigs, Fixtures, Shop Items/Test Fixtures/Ride Steer Test Fixture/FIX-201-01-22-A.pdf

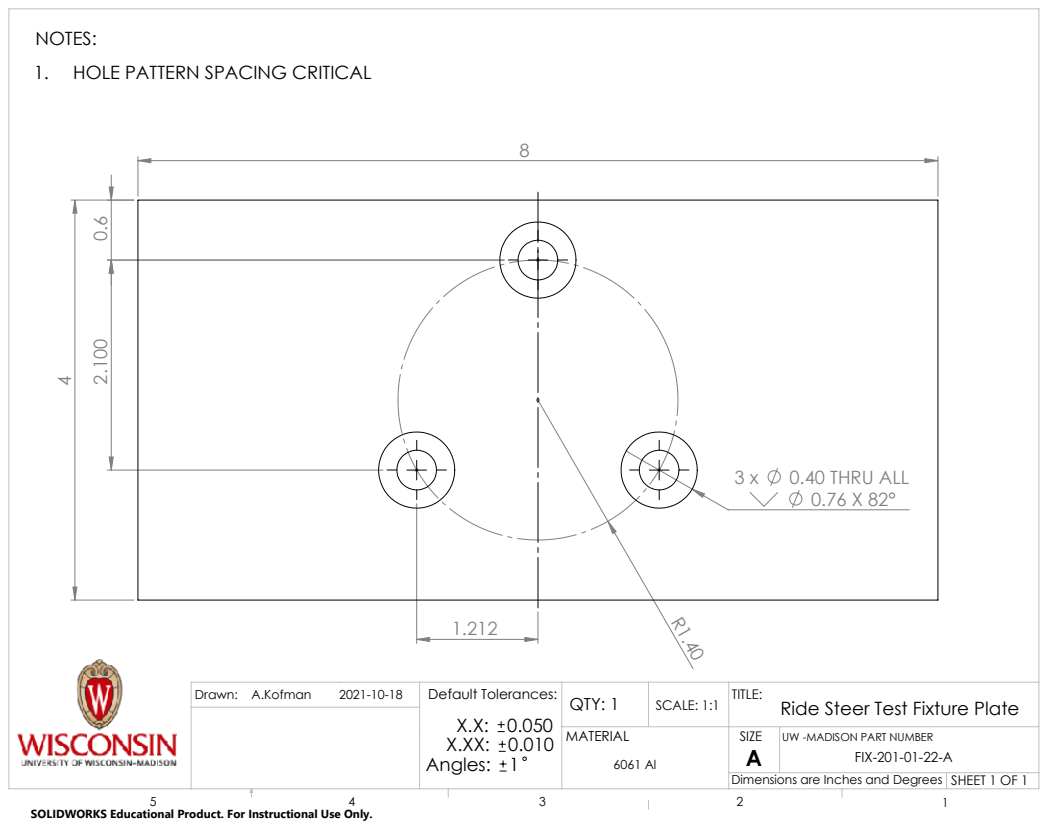
[picture p33: page 1]
0.40 THRU ALL; SHEET 1 OF 1; SCALE: 1:1; FIX-201-01-22-A 6061 Al; QTY: 1 A.Kofman; Default Tolerances:

NOTES:
1. HOLE PATTERN SPACING CRITICAL

TITLE:
Ride Steer Test Fixture Plate
SIZE
UW -MADISON PART NUMBER
Dimensions are Inches and Degrees

SOLIDWORKS Educational Product. For Instructional Use Only.
