Lileigh/Active-CAD/Cost Report/Cost-FR-Assem.pdf

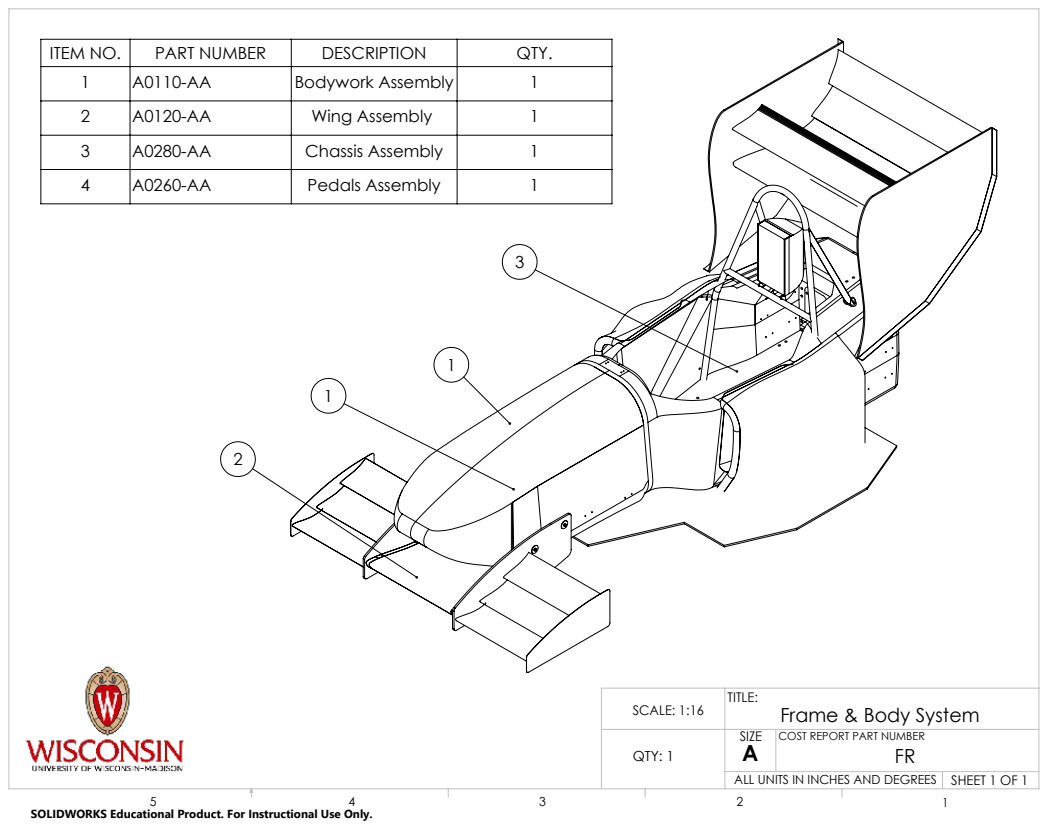
[picture p34: page 1]
SHEET 1 OF 1; SCALE: 1:16; QTY: 1

ITEM NO. | PART NUMBER | DESCRIPTION | QTY.
1 | A0110-AA | Bodywork Assembly | 1
2 | A0120-AA | Wing Assembly | 1
3 | A0280-AA | Chassis Assembly | 1
4 | A0260-AA | Pedals Assembly | 1

TITLE:
Frame & Body System
SIZE
COST REPORT PART NUMBER

ALL UNITS IN INCHES AND DEGREES

SOLIDWORKS Educational Product. For Instructional Use Only.
