Lileigh/Active-CAD/200 - Chassis/Drawings/217-246-01 Tierod Tube Insert.pdf

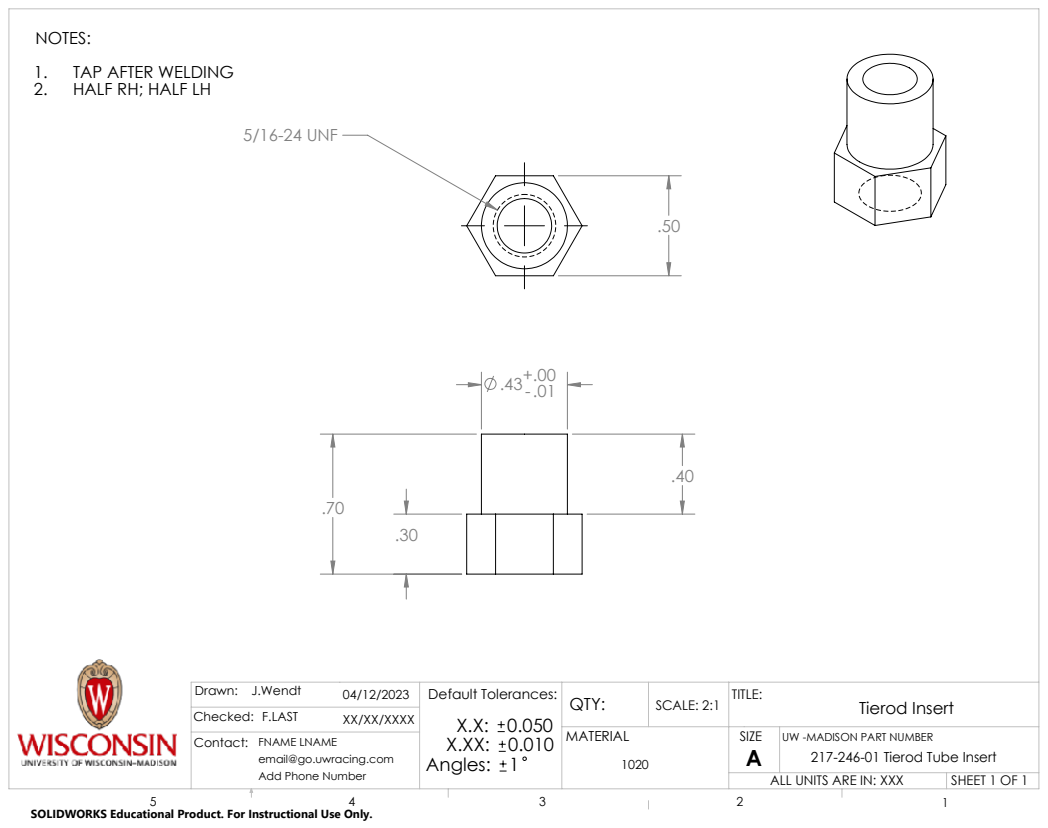
[picture p35: page 1]
5/16-24 UNF; SHEET 1 OF 1; SCALE: 2:1; Tierod Insert; Checked: F.LAST; XX/XX/XXXX; 04/12/2023 Default Tolerances:; Angles:; 1 email@go.uwracing.com

NOTES:
1. TAP AFTER WELDING
2. HALF RH; HALF LH

Drawn:
Contact: FNAME LNAME

TITLE:
ALL UNITS ARE IN: XXX

SIZE
UW -MADISON PART NUMBER
217-246-01 Tierod Tube Insert

Add Phone Number

SOLIDWORKS Educational Product. For Instructional Use Only.
