Lileigh/Active-CAD/200 - Chassis/Drawings/217-246-06 Front Tierod Adjustment Bolt.pdf

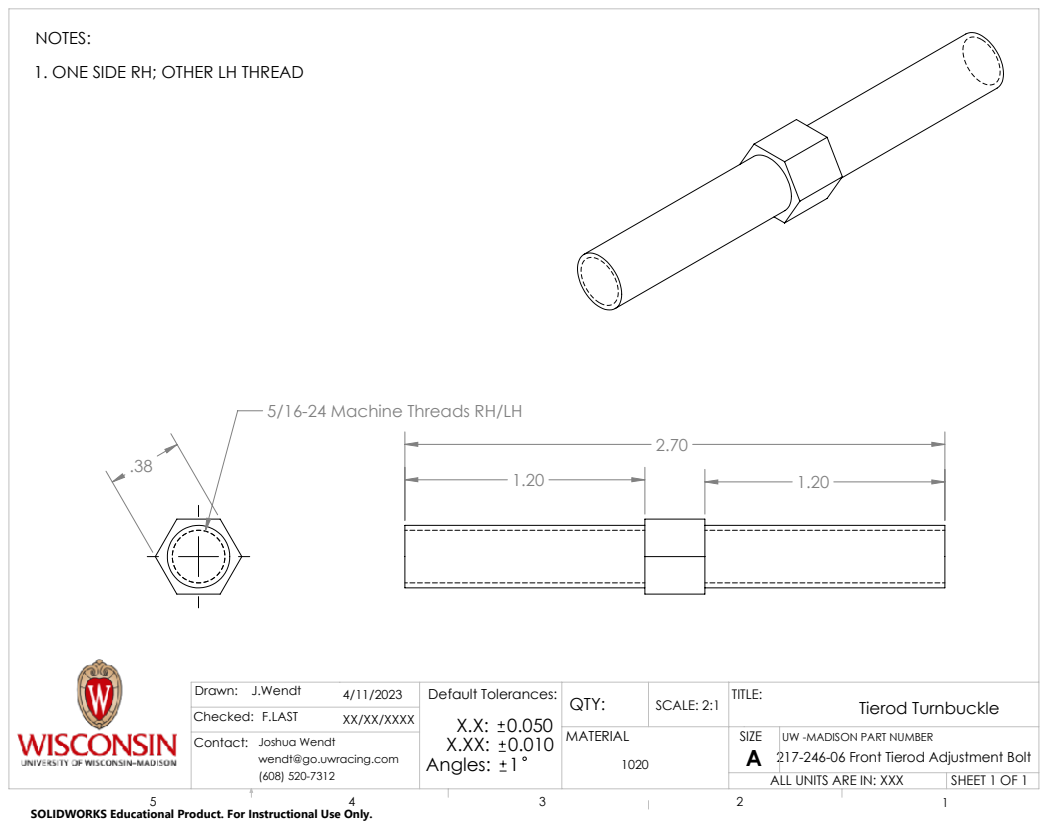
[picture p36: page 1]
SHEET 1 OF 1; SCALE: 2:1; Tierod Turnbuckle; Checked: F.LAST; XX/XX/XXXX; Default Tolerances:; Angles:; 1 wendt@go.uwracing.com

NOTES:
1. ONE SIDE RH; OTHER LH THREAD

5/16-24 Machine Threads RH/LH

Drawn:
Contact: Joshua Wendt

TITLE:
217-246-06 Front Tierod Adjustment Bolt
ALL UNITS ARE IN: XXX

SIZE
UW -MADISON PART NUMBER

SOLIDWORKS Educational Product. For Instructional Use Only.
