Lileigh/Active-CAD/200 - Chassis/Drawings/217-250-08 Tube Insert.pdf

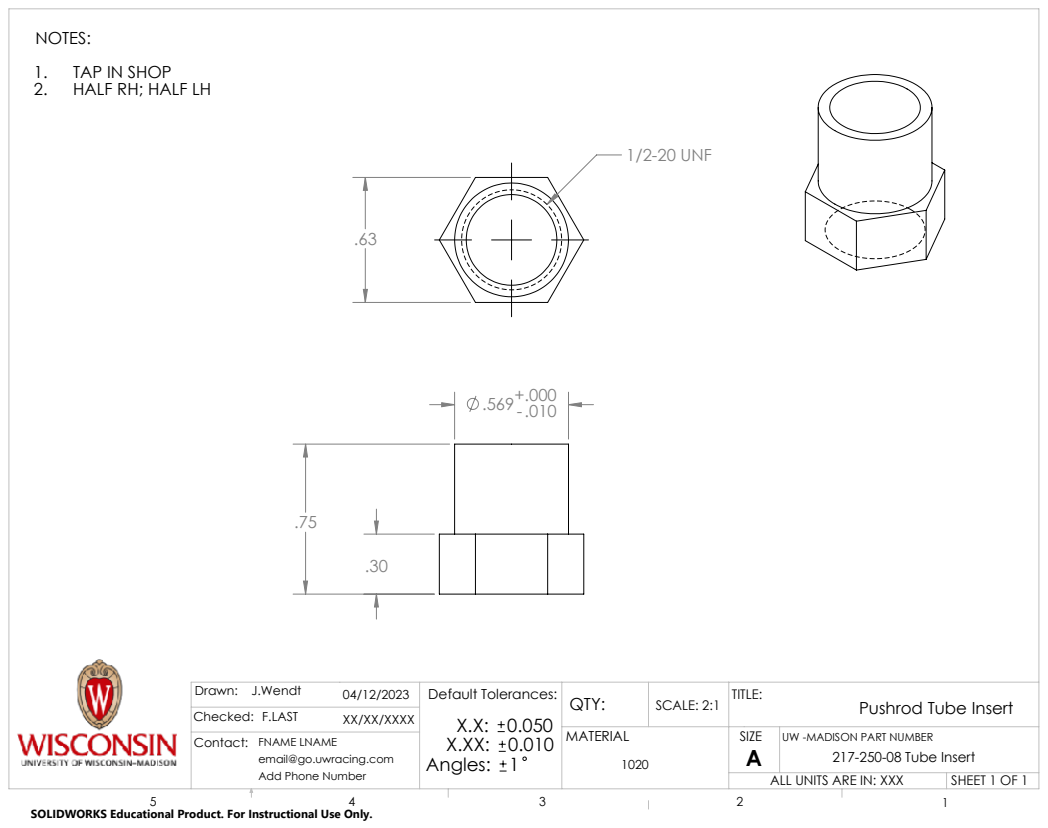
[picture p37: page 1]
1/2-20 UNF; SHEET 1 OF 1; SCALE: 2:1; Checked: F.LAST; XX/XX/XXXX; 04/12/2023 Default Tolerances:; Angles:; 1 email@go.uwracing.com

NOTES:
1. TAP IN SHOP
2. HALF RH; HALF LH

Drawn:
Contact: FNAME LNAME

TITLE:
ALL UNITS ARE IN: XXX

Pushrod Tube Insert

SIZE
UW -MADISON PART NUMBER
217-250-08 Tube Insert

Add Phone Number

SOLIDWORKS Educational Product. For Instructional Use Only.
