Lileigh/Active-CAD/200 - Chassis/Drawings/217-250-10 Adjustment Bolt.pdf

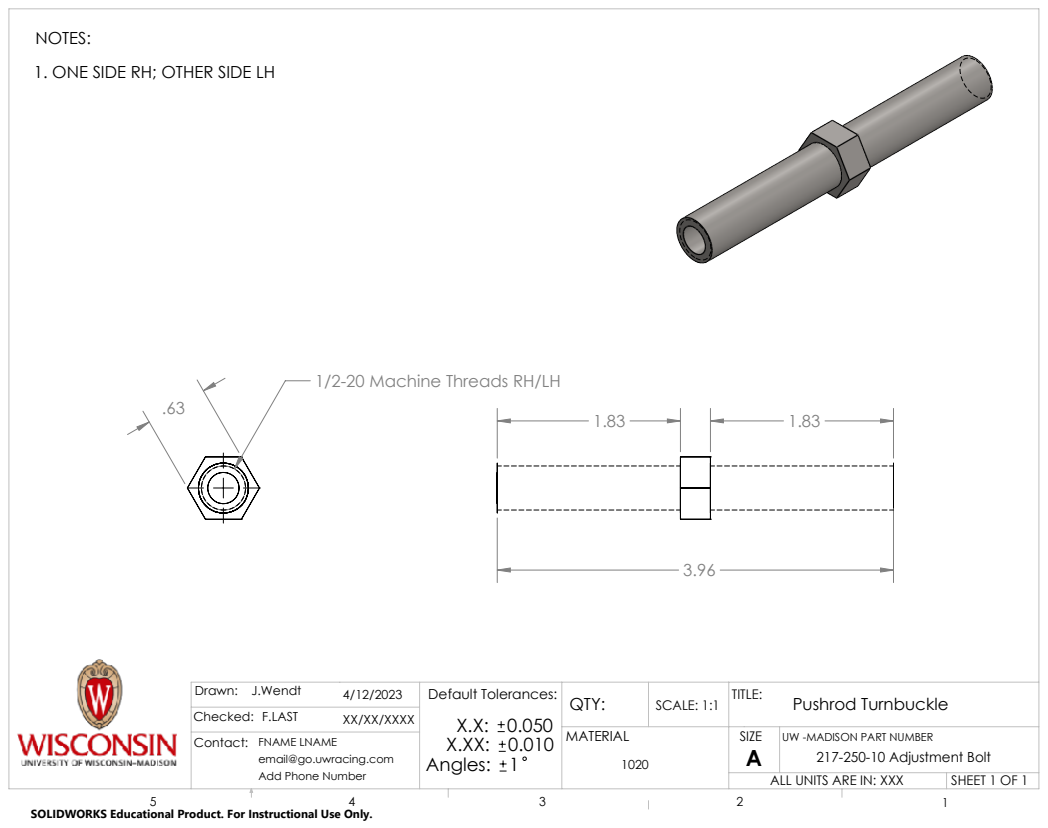
[picture p38: page 1]
SHEET 1 OF 1; SCALE: 1:1; Checked: F.LAST; XX/XX/XXXX; Default Tolerances:; Angles:; 1 email@go.uwracing.com

NOTES:
1. ONE SIDE RH; OTHER SIDE LH

1/2-20 Machine Threads RH/LH

Drawn:
Contact: FNAME LNAME

TITLE:
Pushrod Turnbuckle
ALL UNITS ARE IN: XXX

SIZE
UW -MADISON PART NUMBER
217-250-10 Adjustment Bolt

Add Phone Number

SOLIDWORKS Educational Product. For Instructional Use Only.
