Lileigh/Active-CAD/200 - Chassis/Drawings/Pushrod Slot.pdf

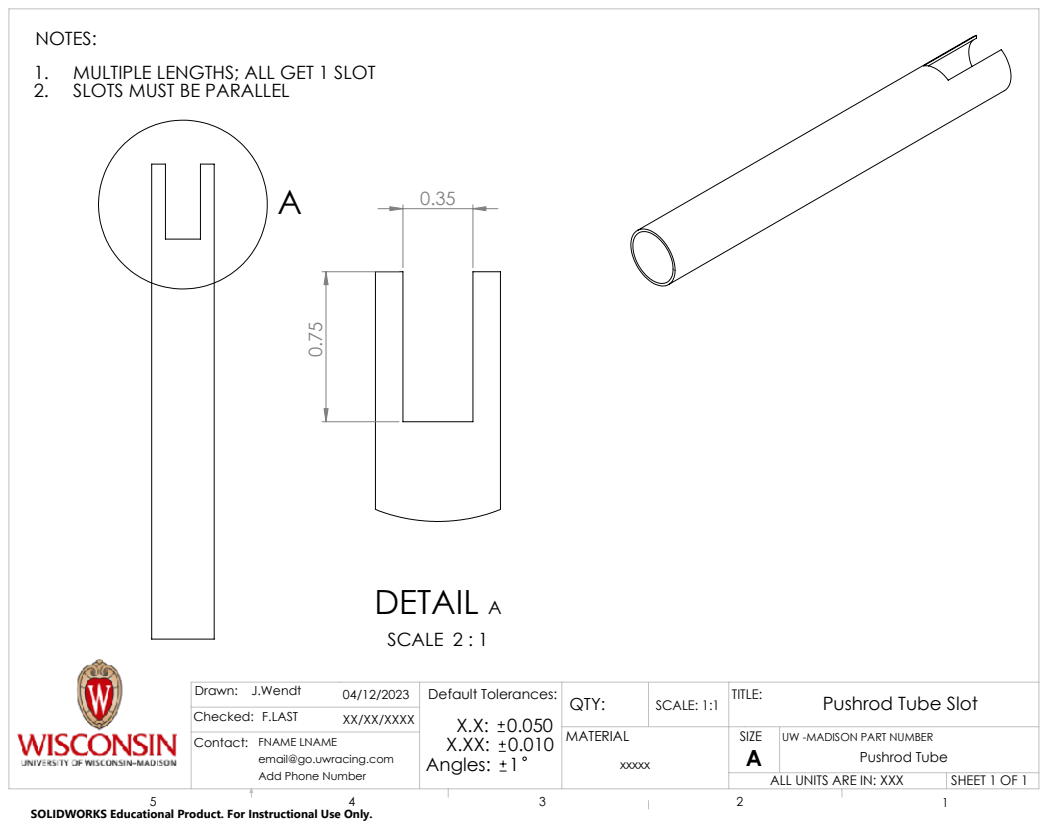
[picture p39: page 1]
DETAIL A; SCALE 2 : 1; SHEET 1 OF 1; SCALE: 1:1; Pushrod Tube; Checked: F.LAST; XX/XX/XXXX; 04/12/2023 Default Tolerances:; Angles:; 1 email@go.uwracing.com

NOTES:
1. MULTIPLE LENGTHS; ALL GET 1 SLOT
2. SLOTS MUST BE PARALLEL

Drawn:
Contact: FNAME LNAME

TITLE:
ALL UNITS ARE IN: XXX

Pushrod Tube Slot

SIZE
UW -MADISON PART NUMBER

Add Phone Number

SOLIDWORKS Educational Product. For Instructional Use Only.
