Lileigh/Active-CAD/200 - Chassis/Drawings/Spacer.pdf

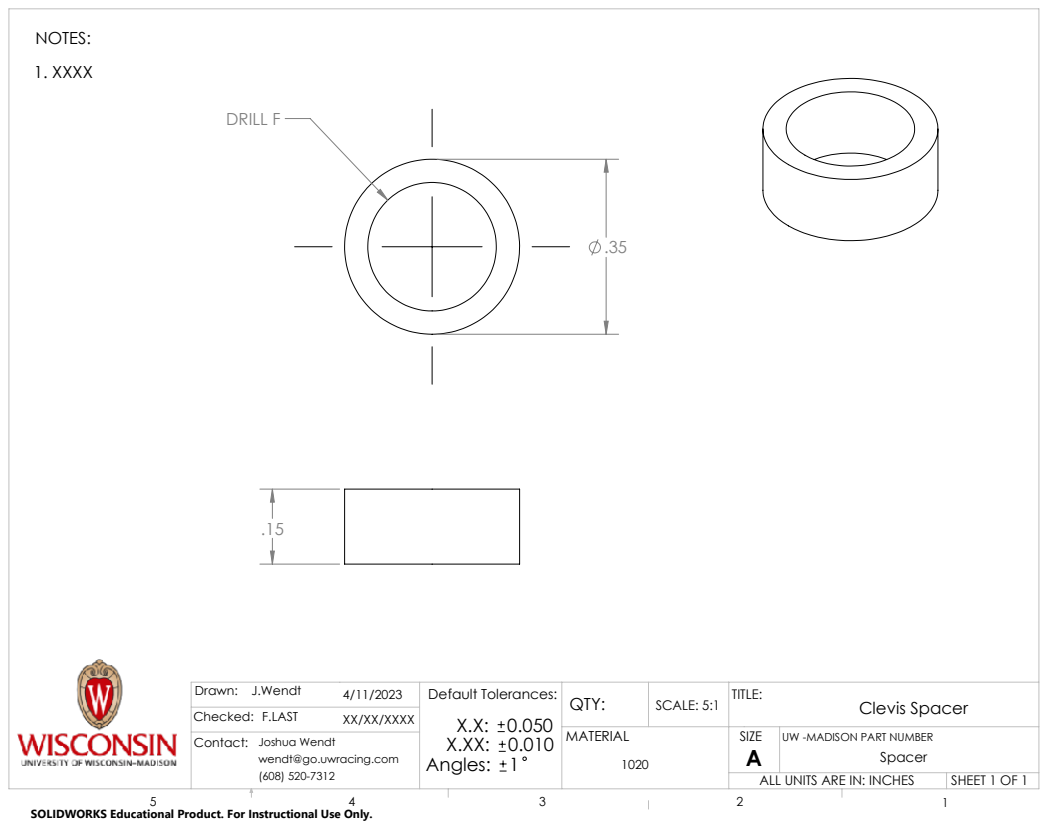
[picture p40: page 1]
DRILL F; SHEET 1 OF 1; SCALE: 5:1; Clevis Spacer; Checked: F.LAST; XX/XX/XXXX; 1. XXXX; Default Tolerances:; Angles:; 1 wendt@go.uwracing.com

Drawn:
Contact: Joshua Wendt

TITLE:
ALL UNITS ARE IN: INCHES

SIZE
UW -MADISON PART NUMBER

SOLIDWORKS Educational Product. For Instructional Use Only.
