Lileigh/Active-CAD/200 - Chassis/Drawings/Tierod Slot.pdf

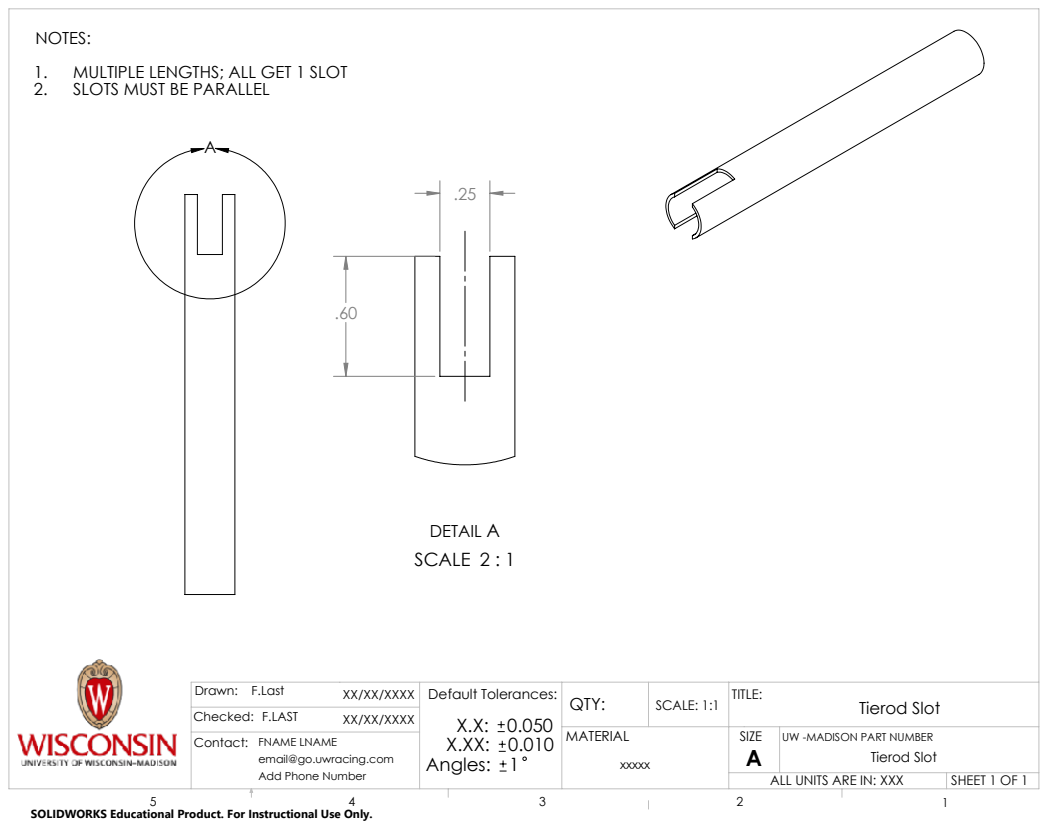
[picture p41: page 1]
DETAIL A SCALE 2 : 1; SHEET 1 OF 1; SCALE: 1:1; Tierod Slot; Checked: F.LAST; XX/XX/XXXX; Angles:; 1 email@go.uwracing.com

NOTES:
1. MULTIPLE LENGTHS; ALL GET 1 SLOT
2. SLOTS MUST BE PARALLEL

Drawn:
Contact: FNAME LNAME

XX/XX/XXXX Default Tolerances:

TITLE:
ALL UNITS ARE IN: XXX

SIZE
UW -MADISON PART NUMBER

Add Phone Number

SOLIDWORKS Educational Product. For Instructional Use Only.
