Lileigh/Active-CAD/200 - Chassis/Drawings/212-23-23A AN4 Inboard.pdf

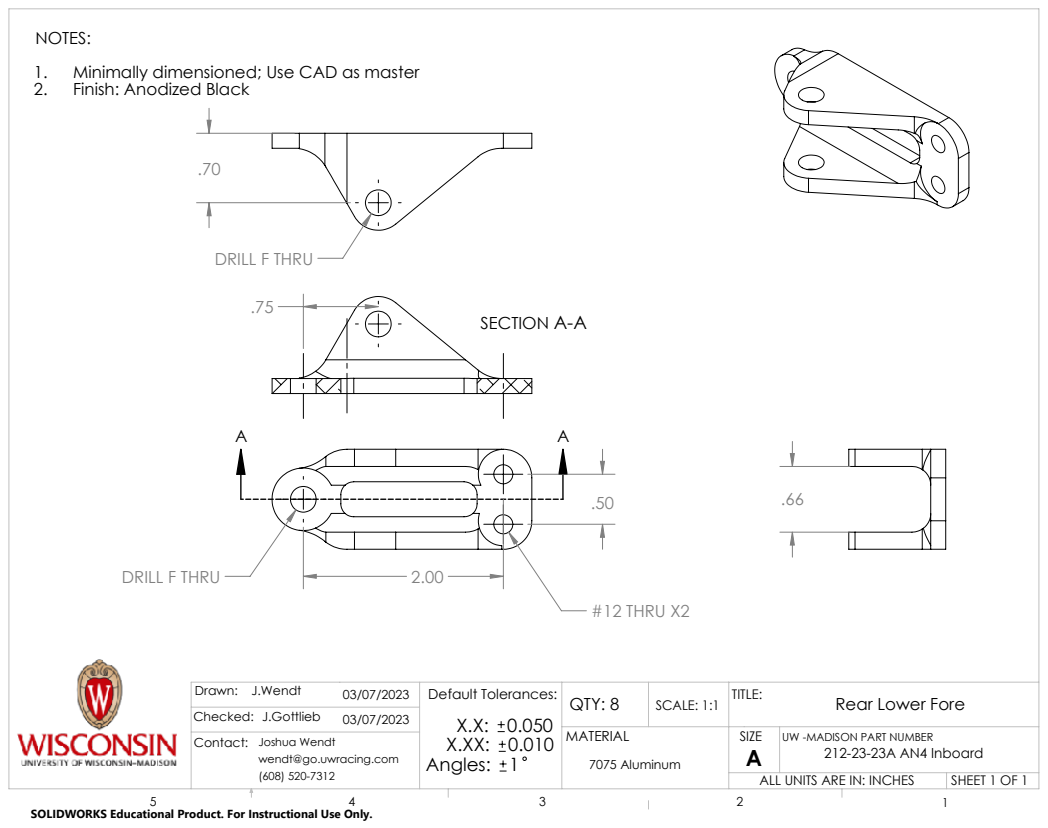
[picture p42: page 1]
DRILL F THRU; #12 THRU X2; SECTION A-A; SHEET 1 OF 1; SCALE: 1:1; 7075 Aluminum; QTY: 8; Checked: J.Gottlieb; 03/07/2023 Default Tolerances:; Angles:; 1 wendt@go.uwracing.com

NOTES:
1. Minimally dimensioned; Use CAD as master
2. Finish: Anodized Black

Drawn:
Contact: Joshua Wendt

TITLE:
ALL UNITS ARE IN: INCHES

Rear Lower Fore

SIZE
UW -MADISON PART NUMBER
212-23-23A AN4 Inboard

SOLIDWORKS Educational Product. For Instructional Use Only.
