Lileigh/Active-CAD/200 - Chassis/Drawings/220-01-23 Bearing Insert.pdf

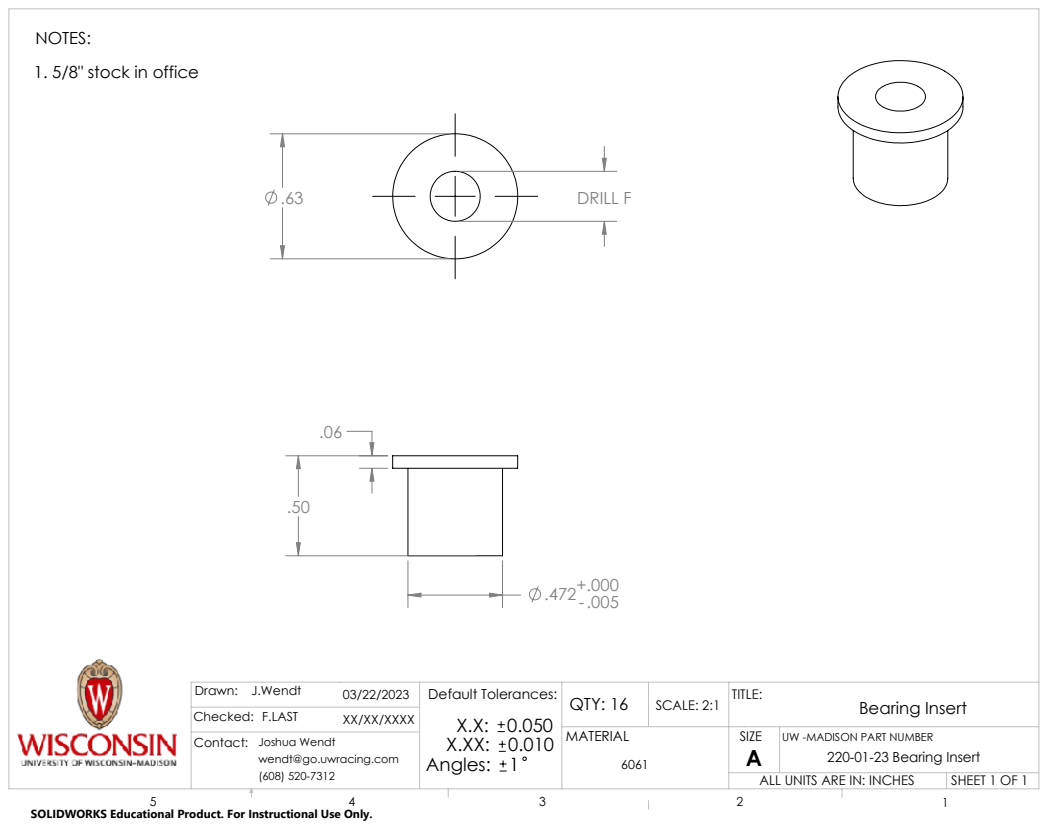
[picture p43: page 1]
DRILL F; SHEET 1 OF 1; SCALE: 2:1; QTY: 16; Bearing Insert; Checked: F.LAST; XX/XX/XXXX; 03/22/2023 Default Tolerances:; Angles:; 1 wendt@go.uwracing.com

NOTES:
1. 5/8" stock in office

Drawn:
Contact: Joshua Wendt

TITLE:
ALL UNITS ARE IN: INCHES

SIZE
UW -MADISON PART NUMBER
220-01-23 Bearing Insert

SOLIDWORKS Educational Product. For Instructional Use Only.
