Lileigh/Active-CAD/200 - Chassis/Drawings/221-01-23 Damper Mount.pdf

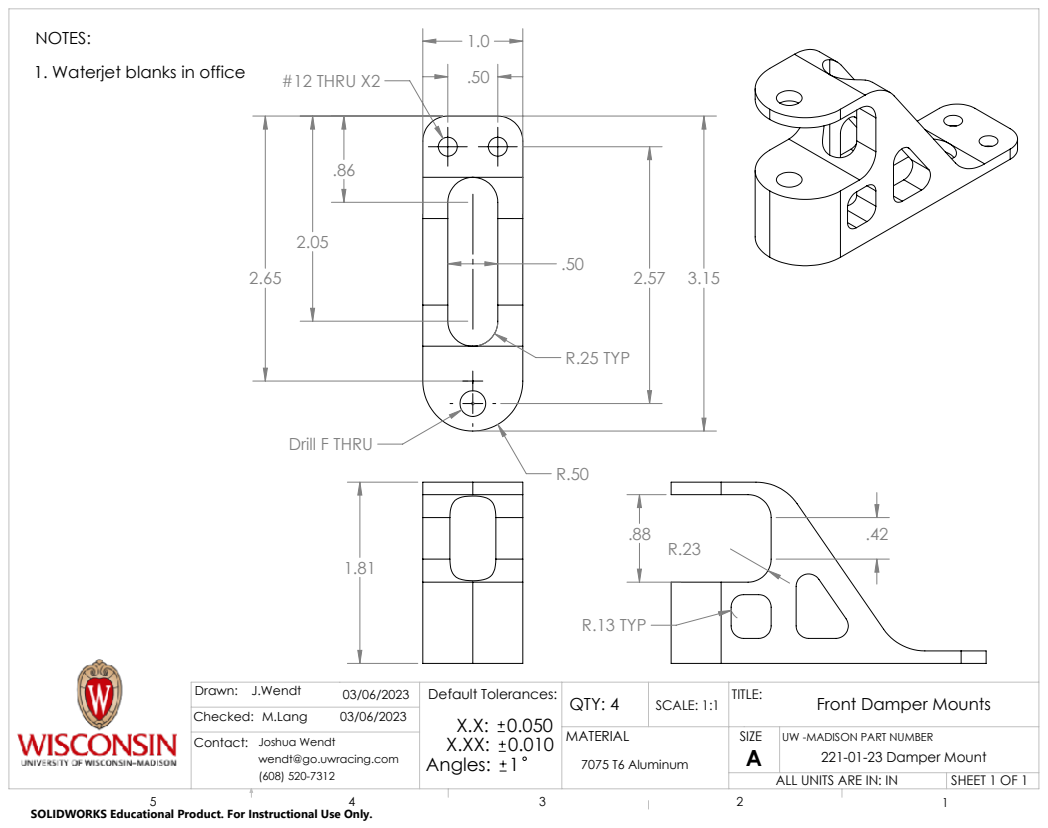
[picture p44: page 1]
Drill F THRU; #12 THRU X2; R.25 TYP; R.13 TYP; SHEET 1 OF 1; SCALE: 1:1; 7075 T6 Aluminum; QTY: 4; Checked: M.Lang; 03/06/2023 Default Tolerances:; Angles:; 1 wendt@go.uwracing.com

NOTES:
1. Waterjet blanks in office

Drawn:
Contact: Joshua Wendt

TITLE:
ALL UNITS ARE IN: IN

Front Damper Mounts

SIZE
UW -MADISON PART NUMBER
221-01-23 Damper Mount

SOLIDWORKS Educational Product. For Instructional Use Only.
