Lileigh/Active-CAD/200 - Chassis/Drawings/221-03-23 Bearing Spacer.pdf

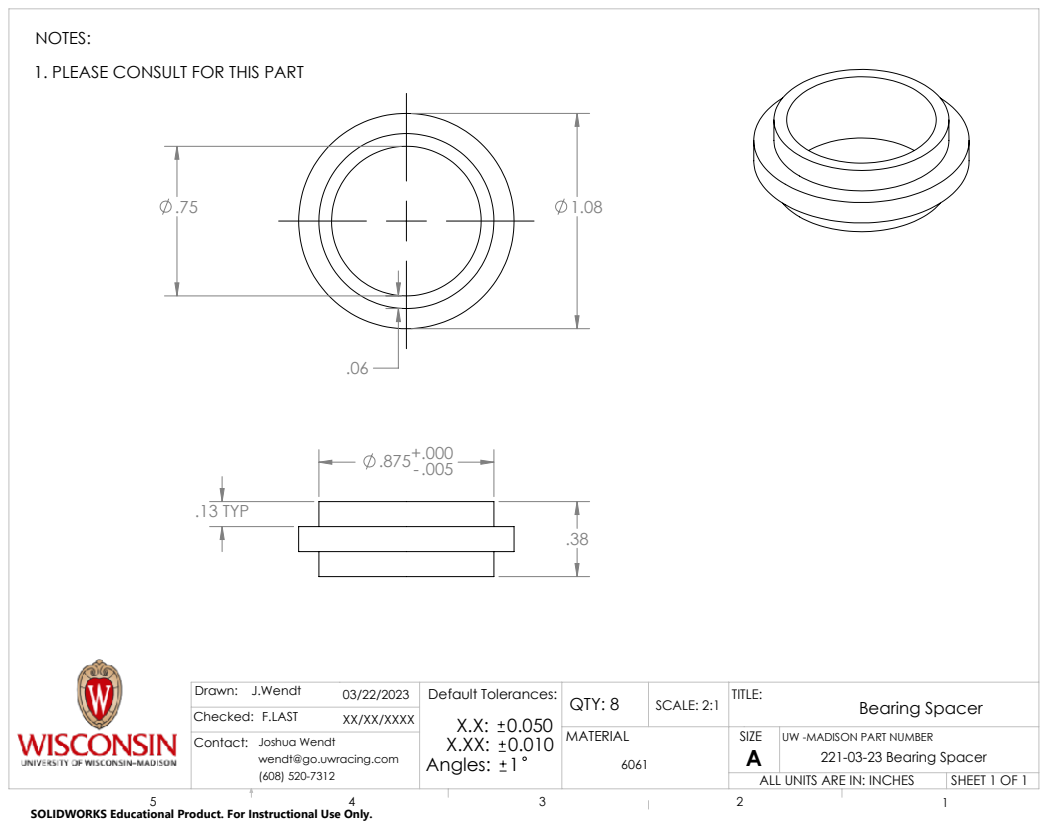
[picture p45: page 1]
.13 TYP; SHEET 1 OF 1; SCALE: 2:1; QTY: 8; Bearing Spacer; Checked: F.LAST; XX/XX/XXXX; 03/22/2023 Default Tolerances:; Angles:; 1 wendt@go.uwracing.com

NOTES:
1. PLEASE CONSULT FOR THIS PART

Drawn:
Contact: Joshua Wendt

TITLE:
ALL UNITS ARE IN: INCHES

SIZE
UW -MADISON PART NUMBER
221-03-23 Bearing Spacer

SOLIDWORKS Educational Product. For Instructional Use Only.
