Lileigh/Active-CAD/200 - Chassis/Drawings/221-03-23 LH Bellcrank Mount.pdf

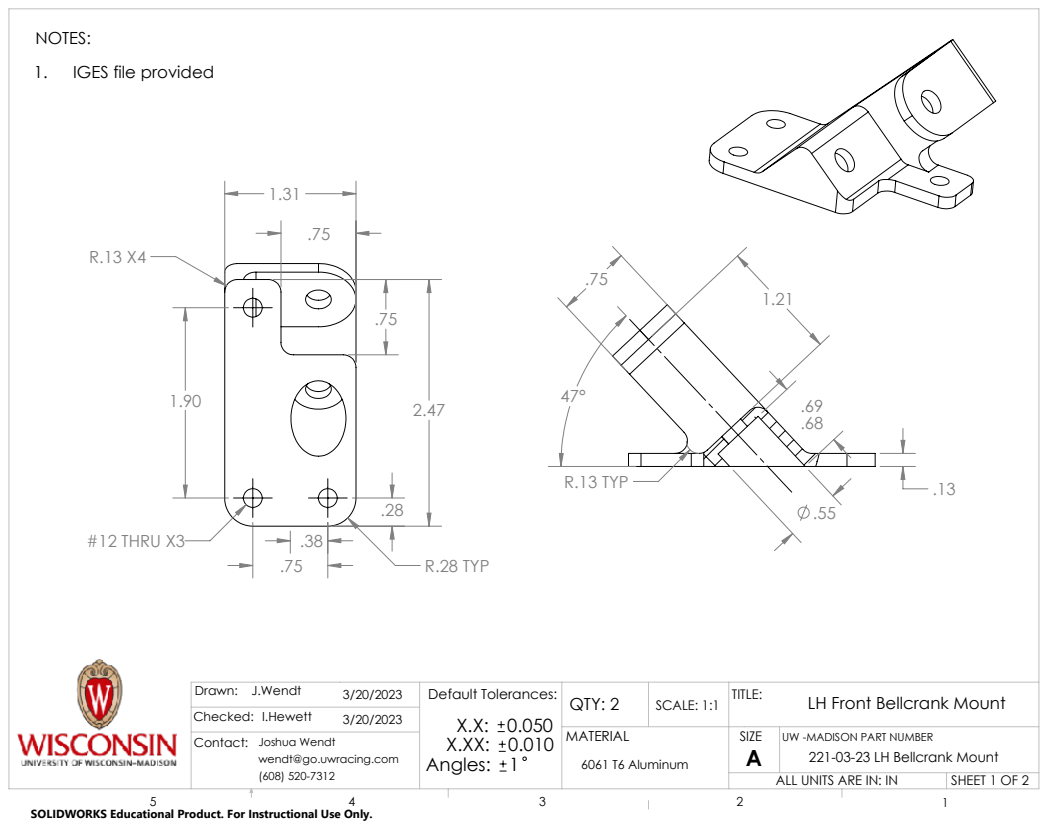
[picture p46: page 1]
#12 THRU X3; R.28 TYP; R.13 TYP; SHEET 1 OF 2; SCALE: 1:1; 6061 T6 Aluminum; QTY: 2; Checked: I.Hewett; Default Tolerances:; Angles:; 1 wendt@go.uwracing.com

NOTES:
1. IGES file provided

Drawn:
Contact: Joshua Wendt

TITLE:
ALL UNITS ARE IN: IN

LH Front Bellcrank Mount

SIZE
UW -MADISON PART NUMBER
221-03-23 LH Bellcrank Mount

SOLIDWORKS Educational Product. For Instructional Use Only.

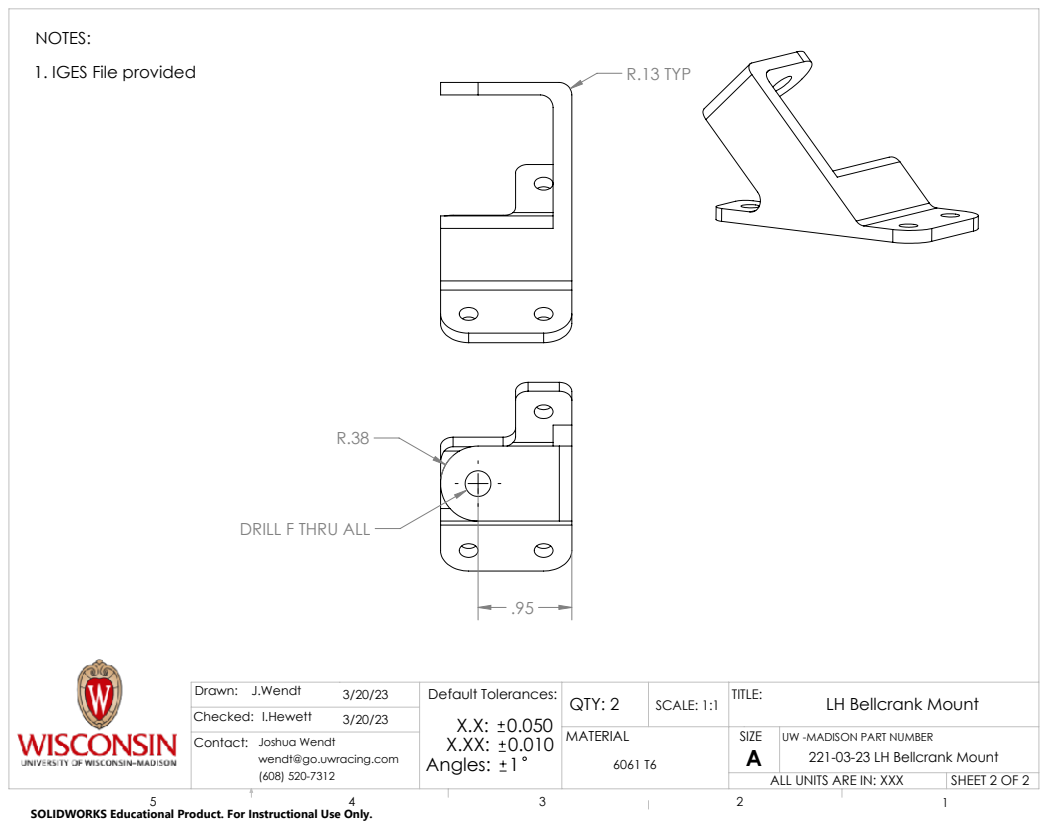
[picture p47: page 2]
R.13 TYP; SHEET 2 OF 2; SCALE: 1:1; QTY: 2; Checked: I.Hewett; Default Tolerances:; Angles:; 1 wendt@go.uwracing.com

NOTES:
1. IGES File provided

DRILL F THRU ALL

Drawn:
Contact: Joshua Wendt

TITLE:
ALL UNITS ARE IN: XXX

LH Bellcrank Mount

SIZE
UW -MADISON PART NUMBER
221-03-23 LH Bellcrank Mount

SOLIDWORKS Educational Product. For Instructional Use Only.
