Lileigh/Active-CAD/200 - Chassis/Drawings/221-03-23 RH Bellcrank Mount.pdf

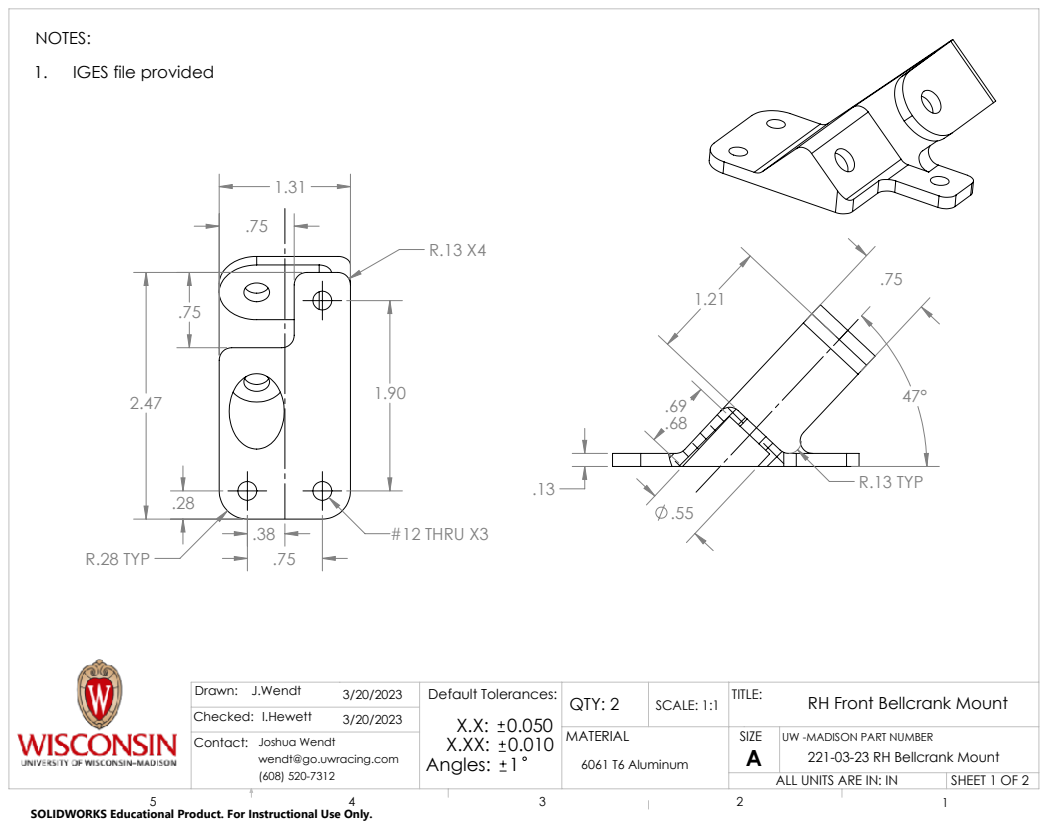
[picture p48: page 1]
#12 THRU X3; R.28 TYP; R.13 TYP; SHEET 1 OF 2; SCALE: 1:1; 6061 T6 Aluminum; QTY: 2; Checked: I.Hewett; Default Tolerances:; Angles:; 1 wendt@go.uwracing.com

NOTES:
1. IGES file provided

Drawn:
Contact: Joshua Wendt

TITLE:
ALL UNITS ARE IN: IN

RH Front Bellcrank Mount

SIZE
UW -MADISON PART NUMBER
221-03-23 RH Bellcrank Mount

SOLIDWORKS Educational Product. For Instructional Use Only.

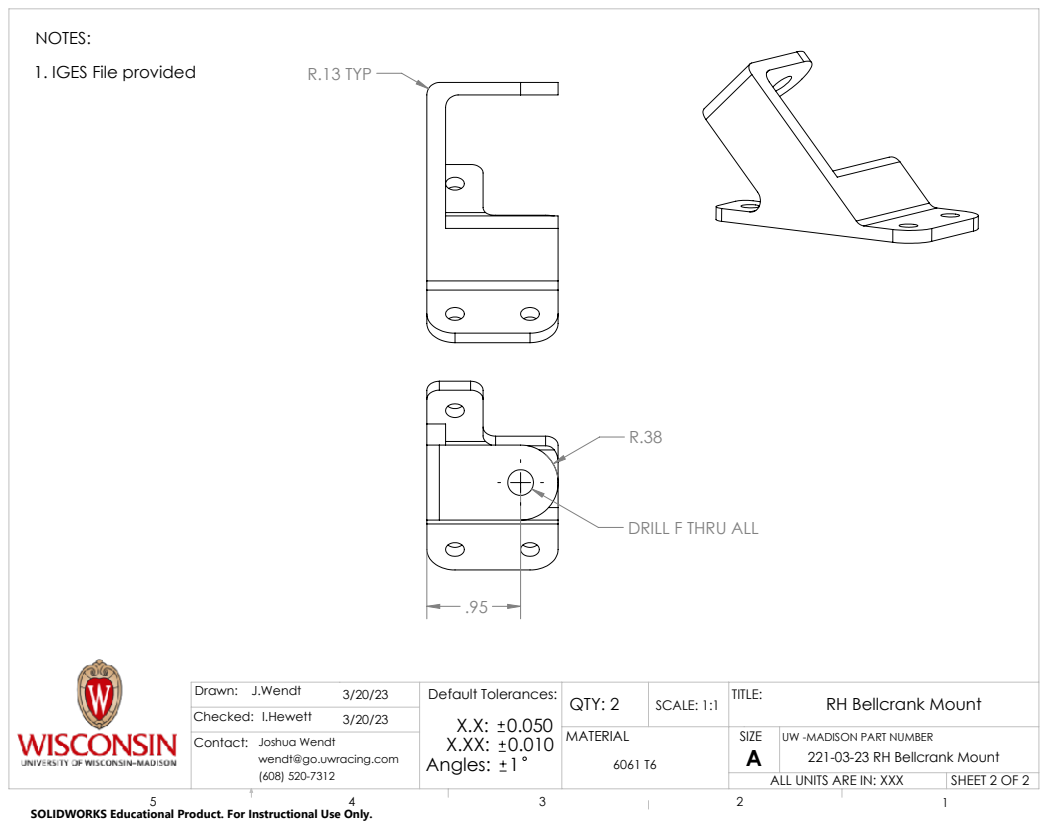
[picture p49: page 2]
R.13 TYP; SHEET 2 OF 2; SCALE: 1:1; QTY: 2; Checked: I.Hewett; Default Tolerances:; Angles:; 1 wendt@go.uwracing.com

NOTES:
1. IGES File provided

DRILL F THRU ALL

Drawn:
Contact: Joshua Wendt

TITLE:
ALL UNITS ARE IN: XXX

RH Bellcrank Mount

SIZE
UW -MADISON PART NUMBER
221-03-23 RH Bellcrank Mount

SOLIDWORKS Educational Product. For Instructional Use Only.
