Lileigh/Active-CAD/Manufacturing/United Tool/221-05-23 Bellcrank Half Mirror.pdf

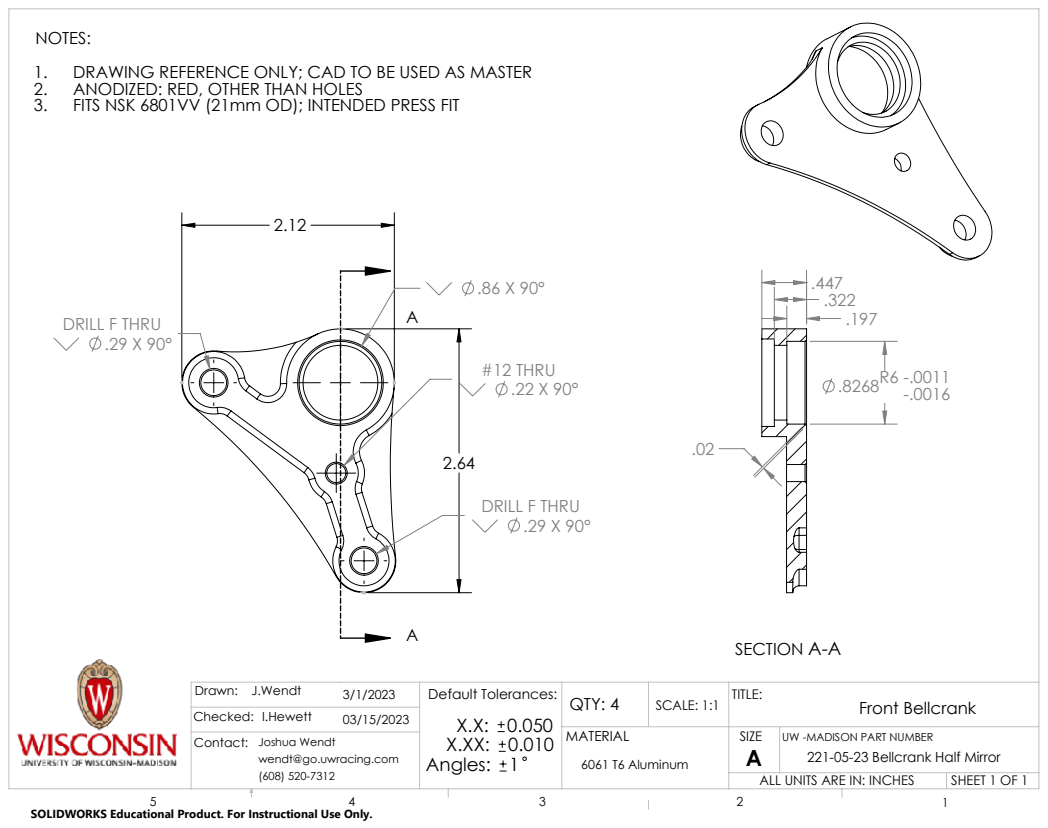
[picture p50: page 1]
DRILL F THRU .29 X 90°; #12 THRU .22 X 90°; SECTION A-A; SHEET 1 OF 1; SCALE: 1:1; 6061 T6 Aluminum; QTY: 4; Front Bellcrank; Checked: I.Hewett; Default Tolerances:; Angles:; 1 wendt@go.uwracing.com

NOTES:
1. DRAWING REFERENCE ONLY; CAD TO BE USED AS MASTER
2. ANODIZED: RED, OTHER THAN HOLES
3. FITS NSK 6801VV (21mm OD); INTENDED PRESS FIT

Drawn:
Contact: Joshua Wendt

TITLE:
ALL UNITS ARE IN: INCHES

SIZE
UW -MADISON PART NUMBER
221-05-23 Bellcrank Half Mirror

SOLIDWORKS Educational Product. For Instructional Use Only.
