Lileigh/Active-CAD/200 - Chassis/Drawings/211-25-23A AN5 Lower Inboard (Full Dim).pdf

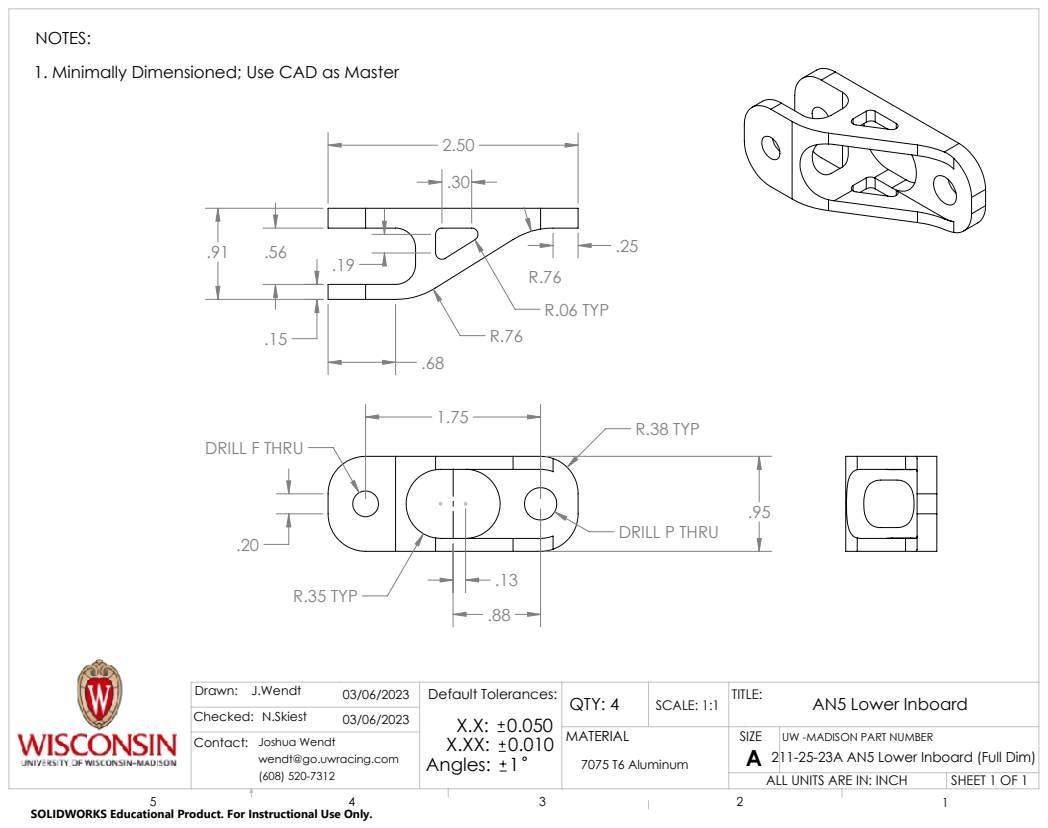
[picture p51: page 1]
DRILL P THRU; R.38 TYP; DRILL F THRU; R.35 TYP; R.06 TYP; SHEET 1 OF 1; SCALE: 1:1; 7075 T6 Aluminum; QTY: 4; AN5 Lower Inboard; Checked: N.Skiest; 03/06/2023 Default Tolerances:; Angles:; 1 wendt@go.uwracing.com

NOTES:
1. Minimally Dimensioned; Use CAD as Master

Drawn:
Contact: Joshua Wendt

TITLE:
211-25-23A AN5 Lower Inboard (Full Dim)
ALL UNITS ARE IN: INCH

SIZE
UW -MADISON PART NUMBER

SOLIDWORKS Educational Product. For Instructional Use Only.
