Lileigh/Active-CAD/200 - Chassis/Drawings/210-03-23B.pdf

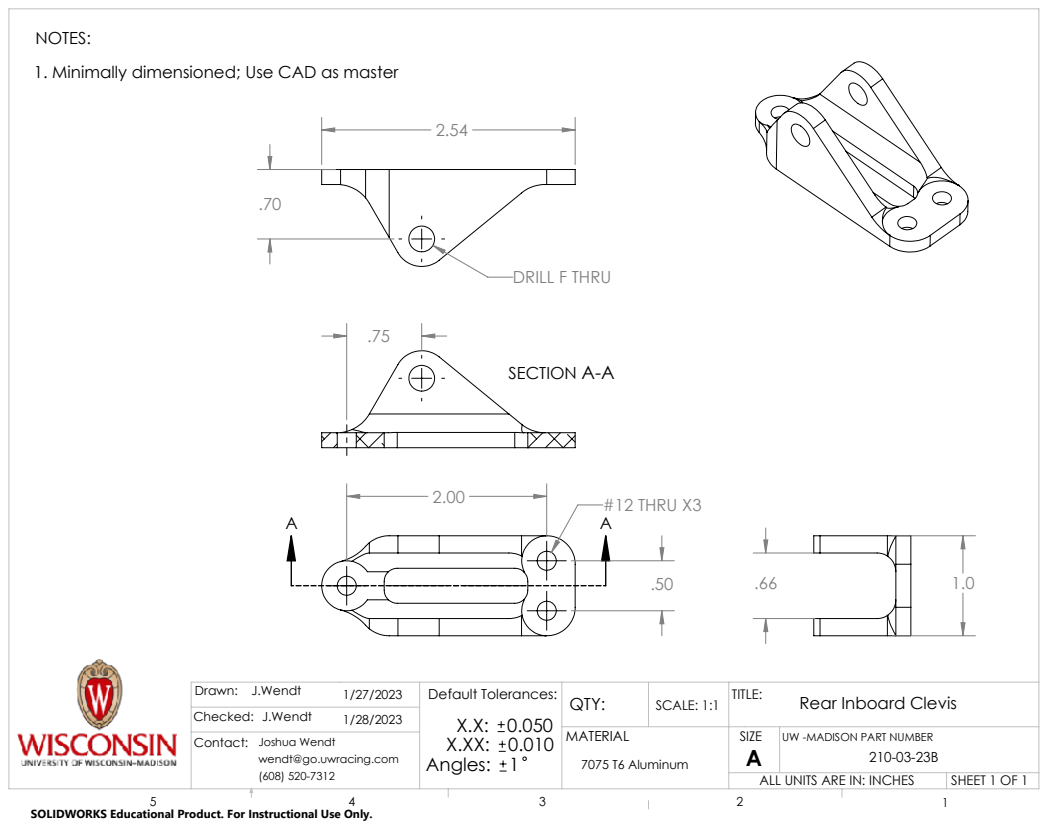
[picture p52: page 1]
#12 THRU X3; DRILL F THRU; SECTION A-A; SHEET 1 OF 1; SCALE: 1:1; 7075 T6 Aluminum; Checked: J.Wendt; Default Tolerances:; Angles:; 1 wendt@go.uwracing.com

NOTES:
1. Minimally dimensioned; Use CAD as master

Drawn:
Contact: Joshua Wendt

TITLE:
Rear Inboard Clevis
ALL UNITS ARE IN: INCHES

SIZE
UW -MADISON PART NUMBER

SOLIDWORKS Educational Product. For Instructional Use Only.
