Lileigh/Active-CAD/200 - Chassis/Drawings/211-19-23-A.pdf

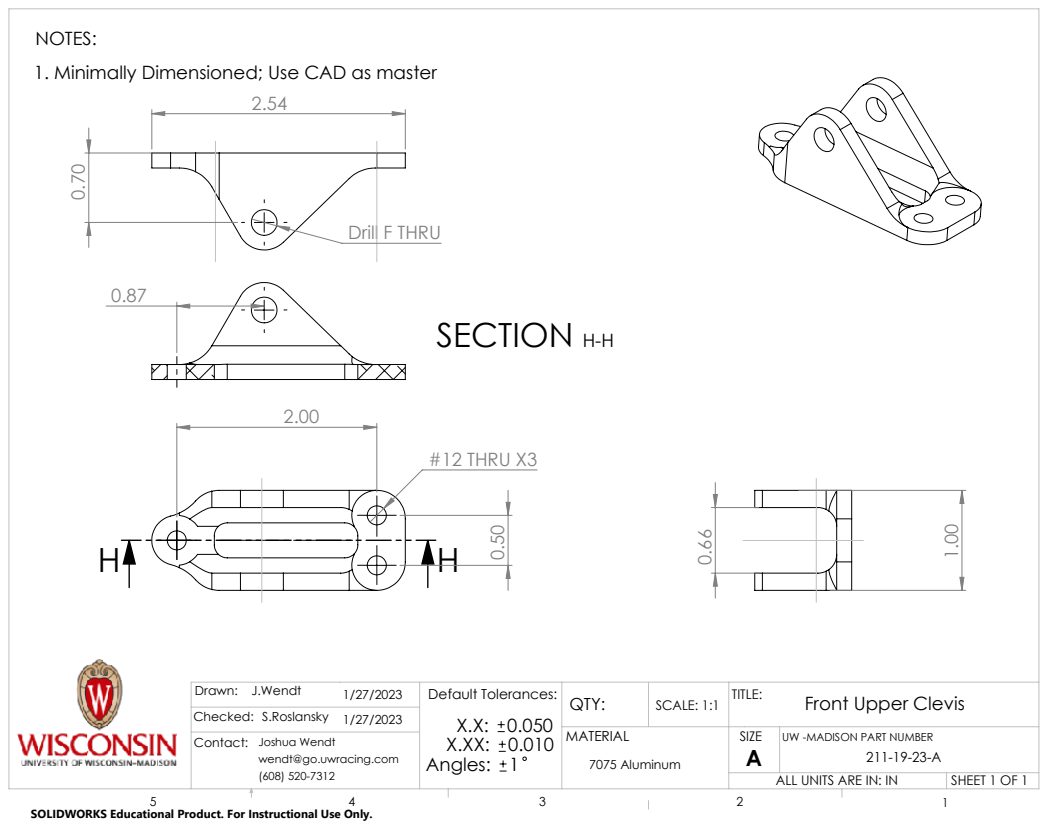
[picture p53: page 1]
#12 THRU X3; Drill F THRU; SECTION H-H; SHEET 1 OF 1; SCALE: 1:1; 7075 Aluminum; Default Tolerances:; Angles:; 1 wendt@go.uwracing.com

NOTES:
1. Minimally Dimensioned; Use CAD as master

Drawn:
Checked: S.Roslansky 1/27/2023
Contact: Joshua Wendt

TITLE:
Front Upper Clevis
ALL UNITS ARE IN: IN

SIZE
UW -MADISON PART NUMBER

SOLIDWORKS Educational Product. For Instructional Use Only.
