Lileigh/Active-CAD/200 - Chassis/Drawings/211-25-23A AN5 Lower Inboard.pdf

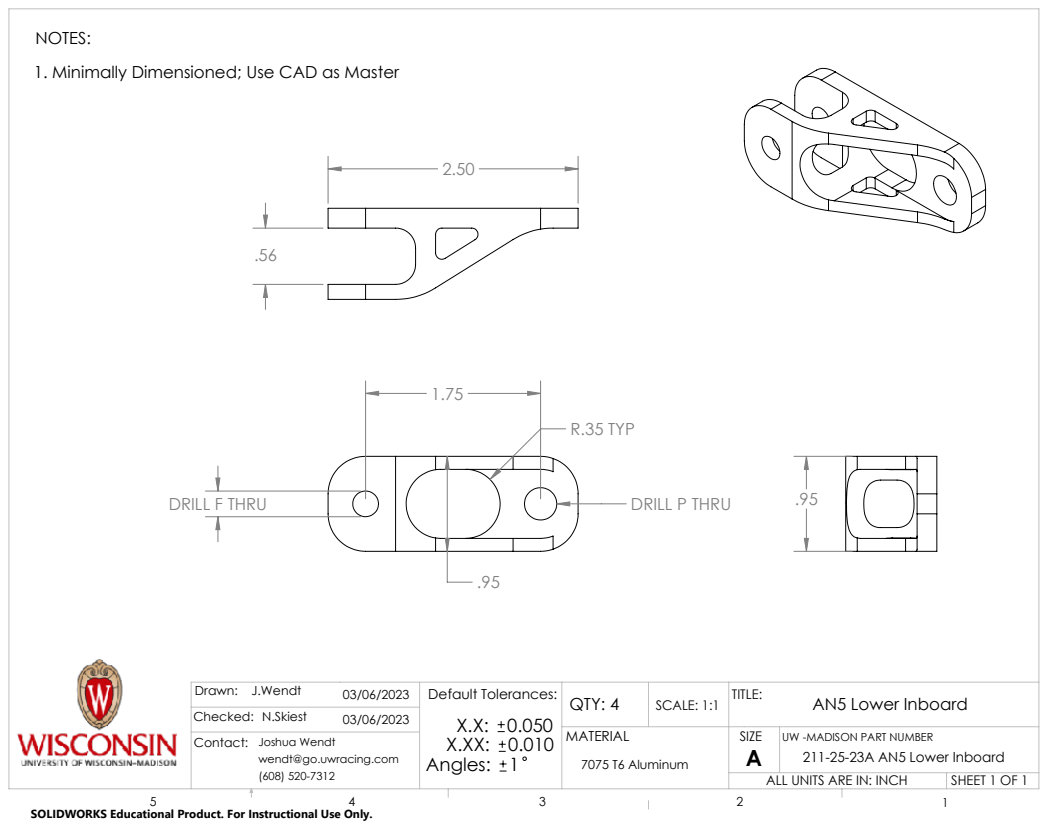
[picture p54: page 1]
DRILL F THRU; DRILL P THRU; R.35 TYP; SHEET 1 OF 1; SCALE: 1:1; 7075 T6 Aluminum; QTY: 4; AN5 Lower Inboard; Checked: N.Skiest; 03/06/2023 Default Tolerances:; Angles:; 1 wendt@go.uwracing.com

NOTES:
1. Minimally Dimensioned; Use CAD as Master

Drawn:
Contact: Joshua Wendt

TITLE:
ALL UNITS ARE IN: INCH

SIZE
UW -MADISON PART NUMBER
211-25-23A AN5 Lower Inboard

SOLIDWORKS Educational Product. For Instructional Use Only.
