Lileigh/Active-CAD/200 - Chassis/Drawings/240-01-17B.pdf

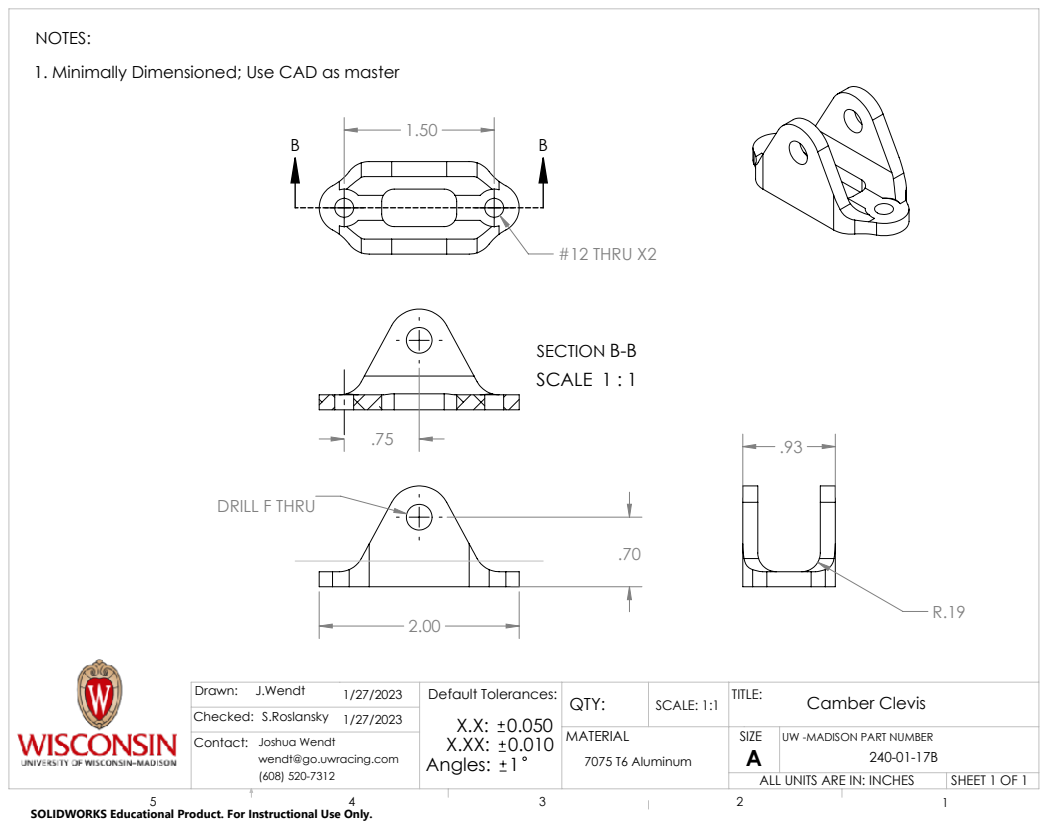
[picture p55: page 1]
DRILL F THRU; #12 THRU X2; SECTION B-B SCALE 1 : 1; SHEET 1 OF 1; SCALE: 1:1; 7075 T6 Aluminum; Camber Clevis; Default Tolerances:; Angles:; 1 wendt@go.uwracing.com

NOTES:
1. Minimally Dimensioned; Use CAD as master

Drawn:
Checked: S.Roslansky 1/27/2023
Contact: Joshua Wendt

TITLE:
ALL UNITS ARE IN: INCHES

SIZE
UW -MADISON PART NUMBER

SOLIDWORKS Educational Product. For Instructional Use Only.
