Lileigh/Active-CAD/400 - E Drivetrain/440 - Dyne/218e-241-08 Motor Adapter Plate.PDF

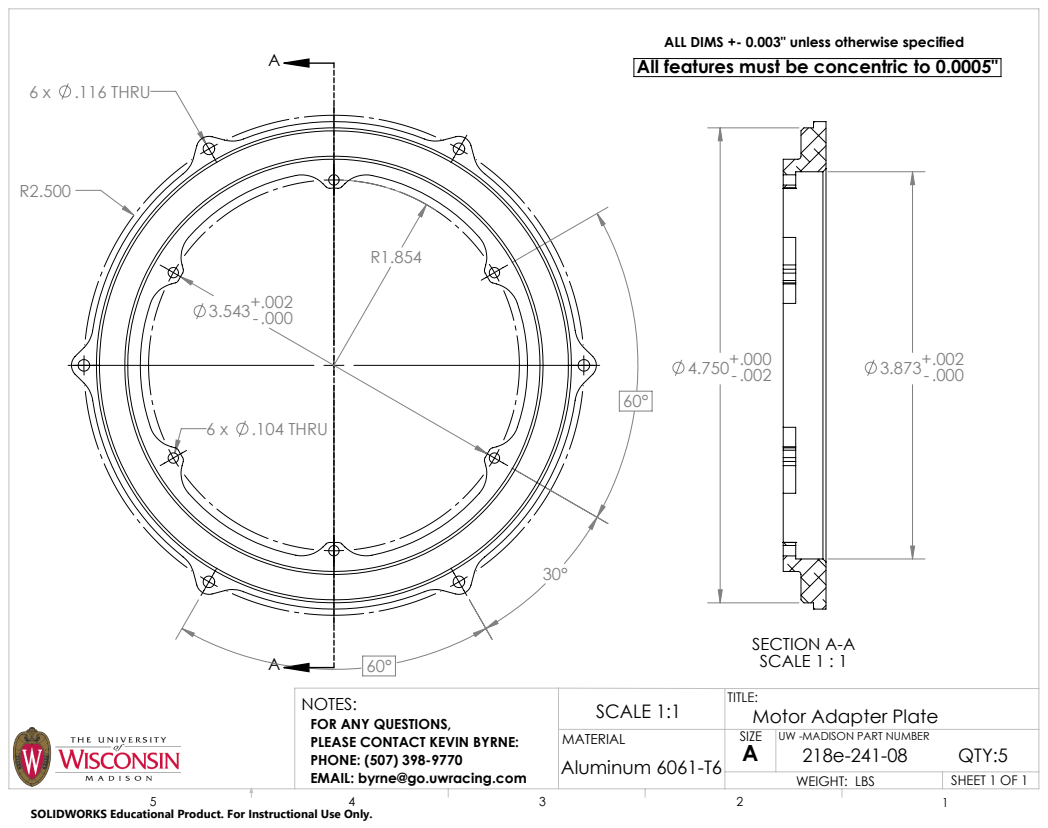
[picture p56: page 1]
6 x .116 THRU; 6 x .104 THRU; SECTION A-A SCALE 1 : 1; SHEET 1 OF 1; SCALE 1:1; WEIGHT: LBS; FOR ANY QUESTIONS,; Motor Adapter Plate; EMAIL: byrne@go.uwracing.com; Aluminum 6061-T6

ALL DIMS +- 0.003" unless otherwise specified
All features must be concentric to 0.0005"

NOTES:
PLEASE CONTACT KEVIN BYRNE:
PHONE: (507) 398-9770

SIZE
UW -MADISON PART NUMBER

SOLIDWORKS Educational Product. For Instructional Use Only.
