Lileigh/Active-CAD/400 - E Drivetrain/440 - Dyne/223e-440-001 Dyne Coupler Plate.pdf

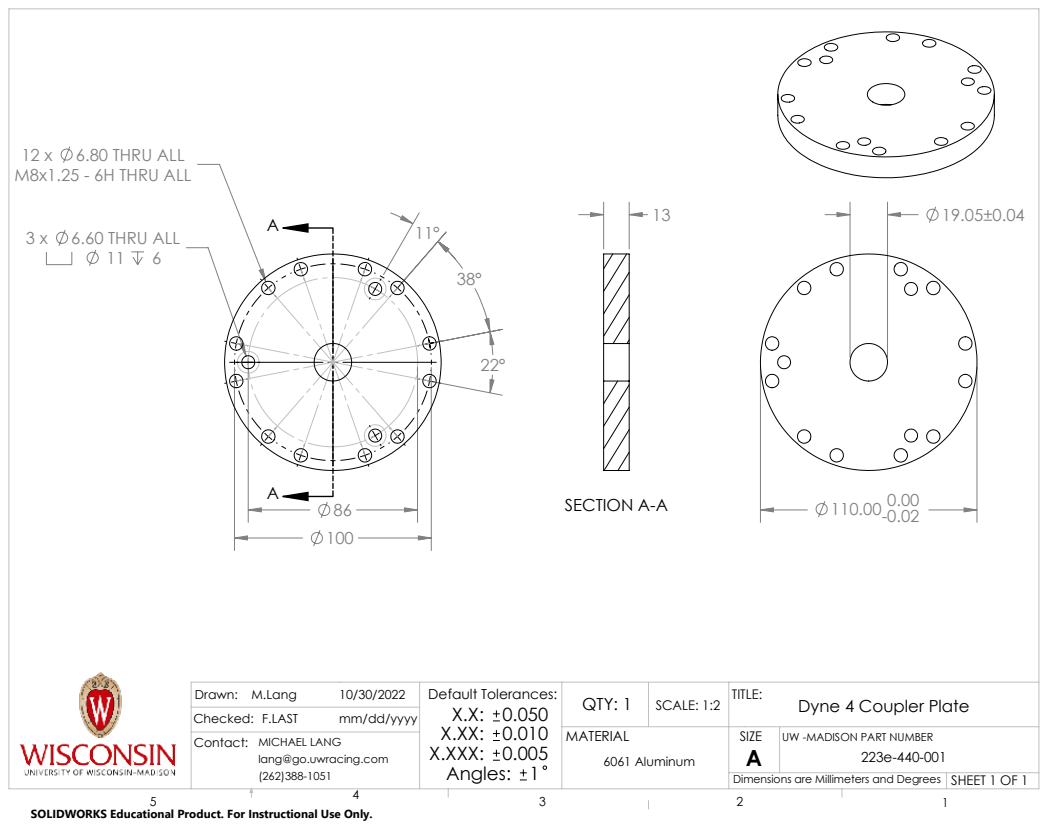
[picture p57: page 1]
3 x 6.60 THRU ALL 11 6; 12 x 6.80 THRU ALL M8x1.25 - 6H THRU ALL; SECTION A-A; SHEET 1 OF 1; SCALE: 1:2; 6061 Aluminum; QTY: 1 M.Lang; Dyne 4 Coupler Plate; Checked: F.LAST; mm/dd/yyyy; Default Tolerances:

Drawn:
Contact: MICHAEL LANG

SIZE
UW -MADISON PART NUMBER

lang@go.uwracing.com

Dimensions are Millimeters and Degrees

SOLIDWORKS Educational Product. For Instructional Use Only.
