Lileigh/Active-CAD/400 - E Drivetrain/440 - Dyne/223e-440-003 Motor Mounting Plate.pdf

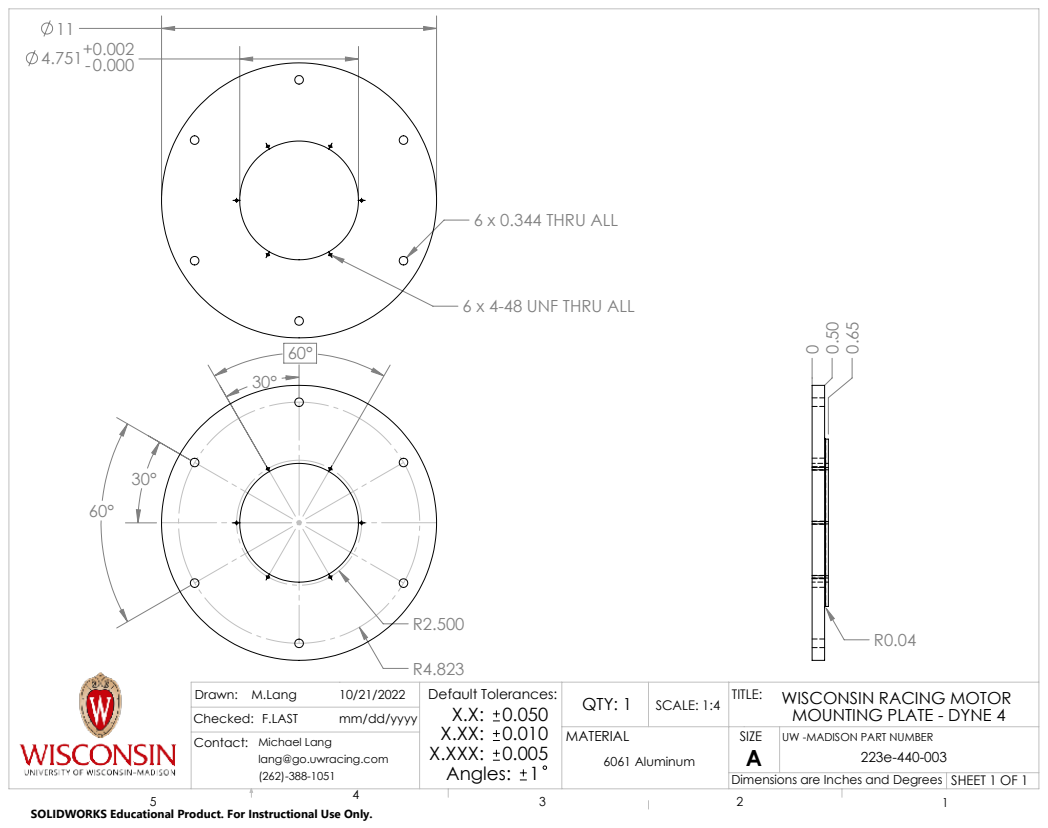
[picture p58: page 1]
6 x 0.344 THRU ALL; SHEET 1 OF 1; SCALE: 1:4; 6061 Aluminum; QTY: 1 M.Lang; WISCONSIN RACING MOTOR; Checked: F.LAST; mm/dd/yyyy; Default Tolerances:

6 x 4-48 UNF THRU ALL

Drawn:
Contact: Michael Lang

TITLE:
MOUNTING PLATE - DYNE 4
SIZE
UW -MADISON PART NUMBER
Dimensions are Inches and Degrees

lang@go.uwracing.com

SOLIDWORKS Educational Product. For Instructional Use Only.
