Lileigh/Active-CAD/000 - Full Vehicle/Three View Drawing/3vd quality test.PDF

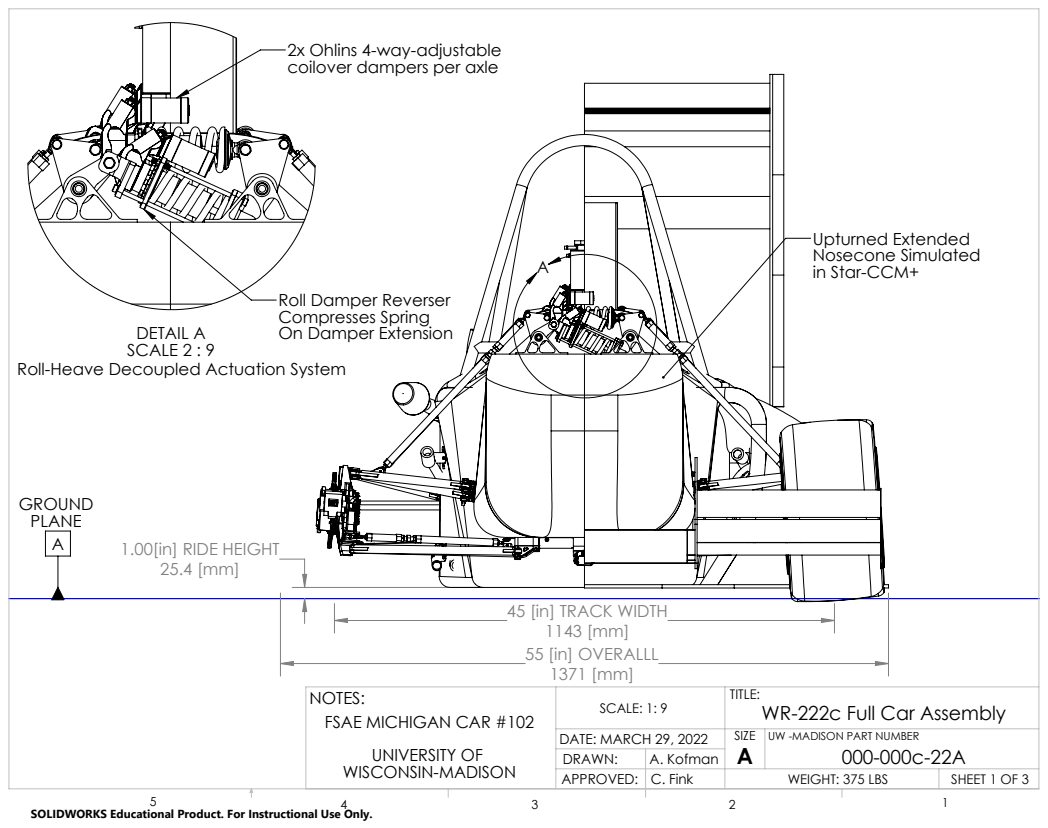
[picture p59: page 1]
1.00[in] RIDE HEIGHT 25.4 [mm]; DETAIL A SCALE 2 : 9; SHEET 1 OF 3; SCALE: 1: 9; DATE: MARCH 29, 2022 A. Kofman C. Fink

2x Ohlins 4-way-adjustable
coilover dampers per axle

Upturned Extended
Nosecone Simulated
in Star-CCM+

Roll Damper Reverser
Compresses Spring
On Damper Extension

Roll-Heave Decoupled Actuation System

45 [in] TRACK WIDTH
55 [in] OVERALLL

NOTES:
FSAE MICHIGAN CAR #102
UNIVERSITY OF
WISCONSIN-MADISON

TITLE:
WR-222c Full Car Assembly
SIZE
UW -MADISON PART NUMBER
WEIGHT: 375 LBS

SOLIDWORKS Educational Product. For Instructional Use Only.

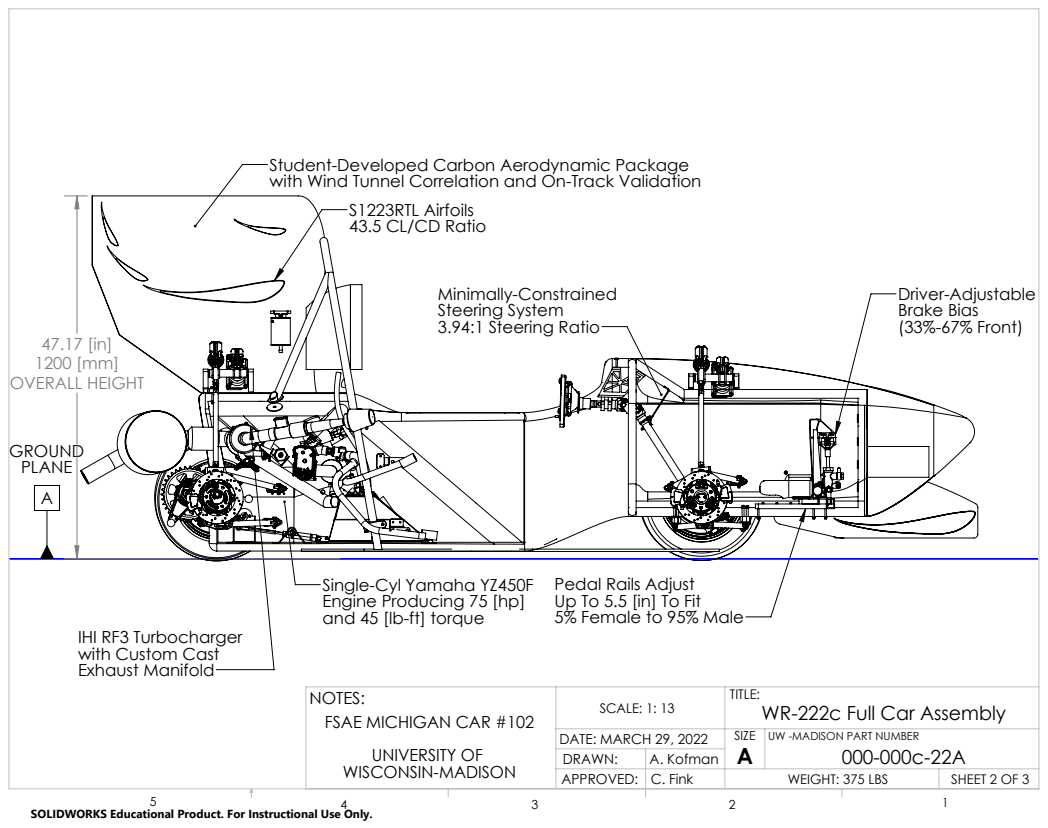
[picture p60: page 2]
47.17 [in] 1200 [mm] OVERALL HEIGHT; Steering System 3.94:1 Steering Ratio; Brake Bias (33%-67% Front); SCALE: 1: 13; DATE: MARCH 29, 2022 A. Kofman

Student-Developed Carbon Aerodynamic Package
with Wind Tunnel Correlation and On-Track Validation

S1223RTL Airfoils
43.5 CL/CD Ratio

Single-Cyl Yamaha YZ450F
Engine Producing 75 [hp]
and 45 [lb-ft] torque

Pedal Rails Adjust
Up To 5.5 [in] To Fit
5% Female to 95% Male

IHI RF3 Turbocharger
with Custom Cast
Exhaust Manifold

NOTES:
FSAE MICHIGAN CAR #102
UNIVERSITY OF

TITLE:
WR-222c Full Car Assembly
SIZE
UW -MADISON PART NUMBER

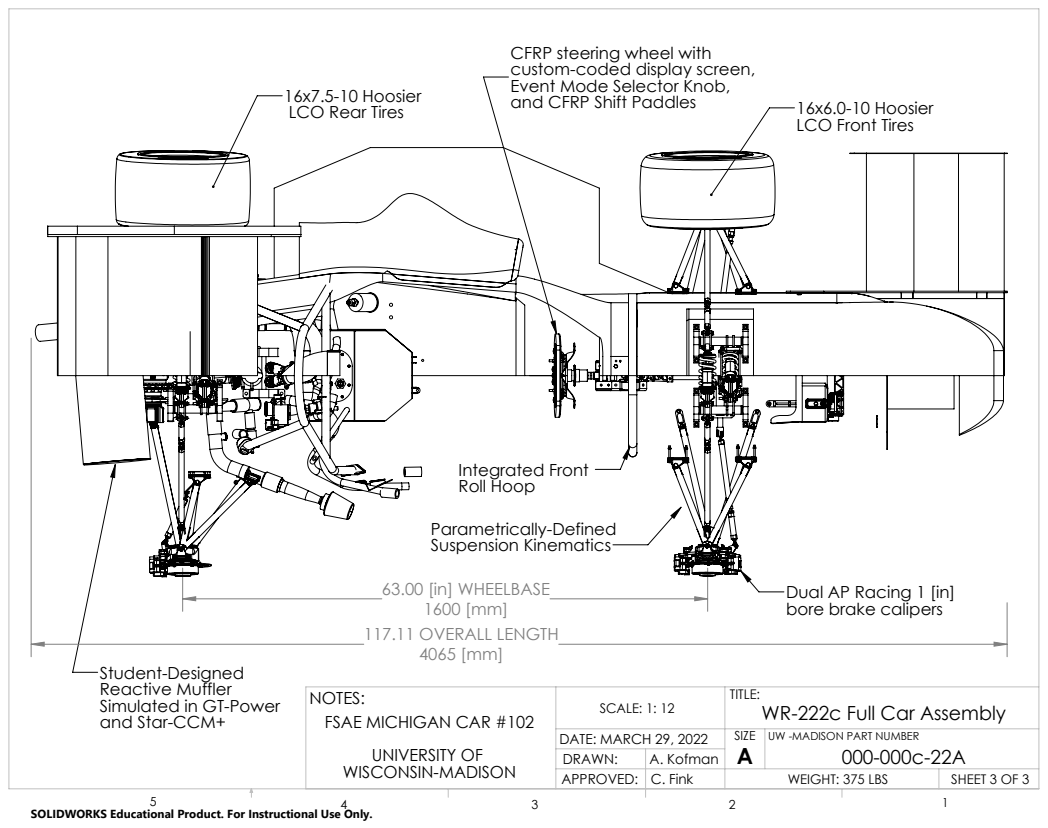
[picture p61: page 3]
63.00 [in] WHEELBASE 1600 [mm] 117.11 OVERALL LENGTH 4065 [mm]; 16x7.5-10 Hoosier; LCO Rear Tires; 16x6.0-10 Hoosier; Suspension Kinematics; Integrated Front Roll Hoop; and Star-CCM+; WR-222c Full Car Assembly; SCALE: 1: 12; DATE: MARCH 29, 2022 A. Kofman

CFRP steering wheel with
custom-coded display screen,
Event Mode Selector Knob,
and CFRP Shift Paddles

LCO Front Tires

Dual AP Racing 1 [in]
bore brake calipers

Student-Designed
Reactive Muffler
Simulated in GT-Power

NOTES:
FSAE MICHIGAN CAR #102
UNIVERSITY OF

SIZE
UW -MADISON PART NUMBER
