Lileigh/Active-CAD/Manufacturing/Ayers Tech/5052 0.063 Waterjet Assembly v2.PDF

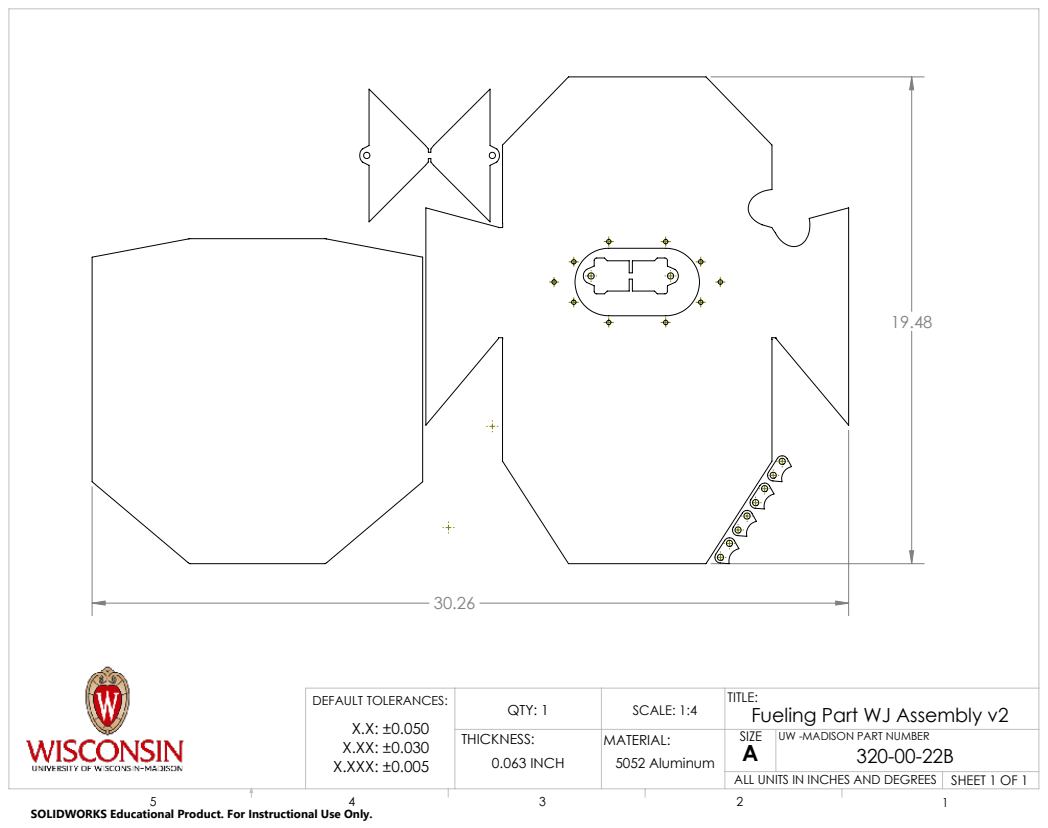
[picture p62: page 1]
SHEET 1 OF 1; SCALE: 1:4; 5052 Aluminum; QTY: 1; 0.063 INCH; DEFAULT TOLERANCES: X.X: ±0.050 X.XX: ±0.030 X.XXX: ±0.005

TITLE:
Fueling Part WJ Assembly v2
SIZE
UW -MADISON PART NUMBER

ALL UNITS IN INCHES AND DEGREES

SOLIDWORKS Educational Product. For Instructional Use Only.
