Lileigh/Active-CAD/Manufacturing/Sheet Metal Bending/220e-450-009 - busbar 1 V2 - Sh.pdf

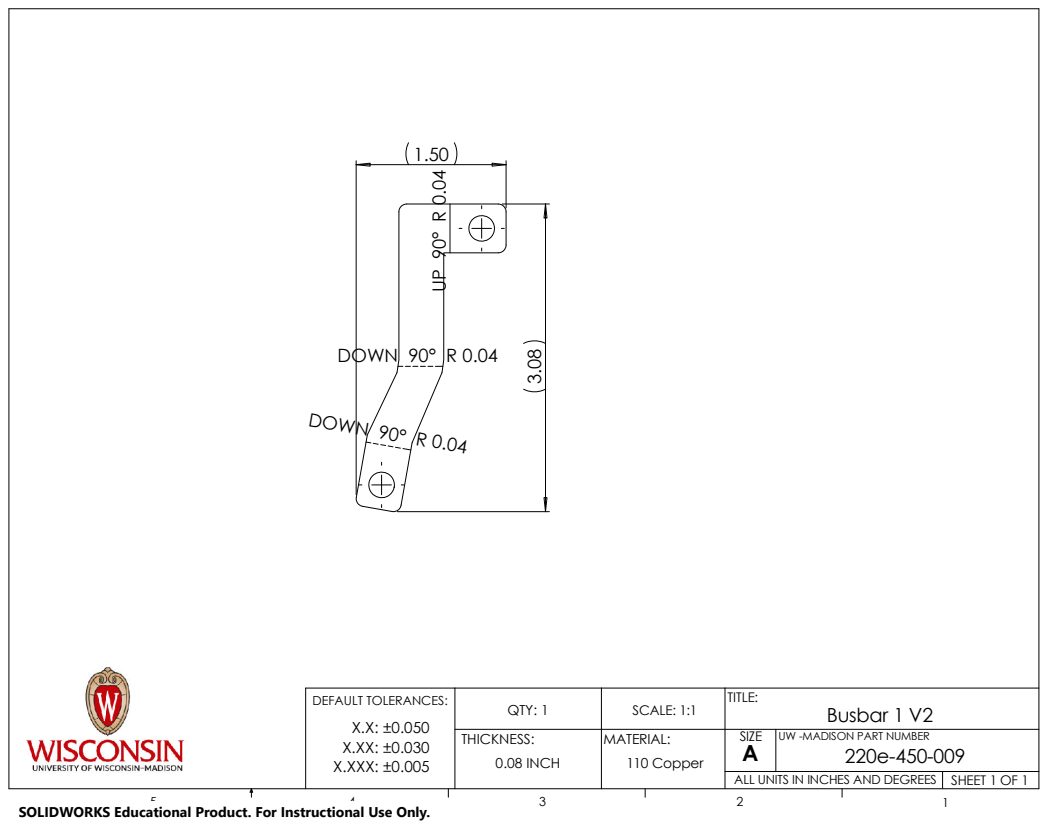
[picture p63: page 1]
DOWN 90° R 0.04

DEFAULT TOLERANCES: X.X: ±0.050 X.XX: ±0.030 X.XXX: ±0.005 | QTY: 1 | SCALE: 1:1 | TITLE: Busbar 1 V2

THICKNESS: 0.08 INCH | MATERIAL: 110 Copper | SIZE A | UW -MADISON PART NUMBER 220e-450-009

ALL UNITS IN INCHES AND DEGREES | SHEET 1 OF 1

SOLIDWORKS Educational Product. For Instructional Use Only.
