Lileigh/Active-CAD/Manufacturing/Sheet Metal Bending/220e-450-013 - busbar 3 V2 - Sh.pdf

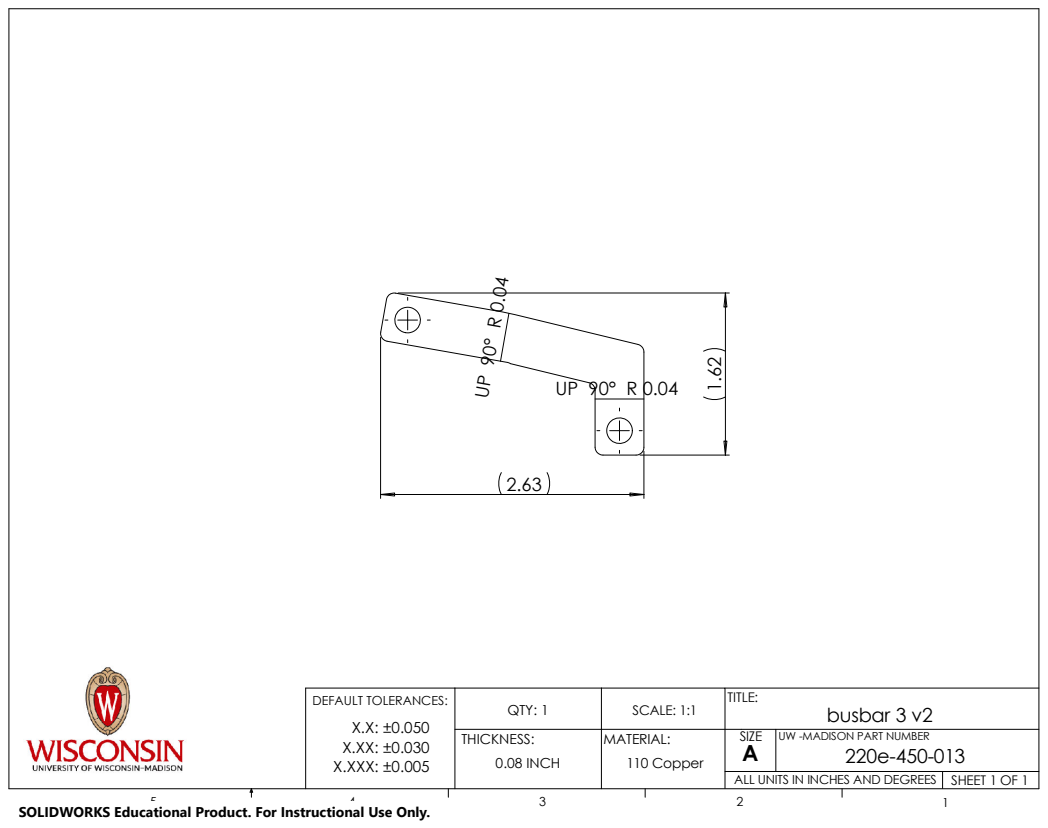
[picture p65: page 1]
SHEET 1 OF 1; DEFAULT TOLERANCES:; SCALE: 1:1; 110 Copper; MATERIAL:

X.X: ±0.050 X.XX: ±0.030 X.XXX: ±0.005 | QTY: 1 | TITLE: busbar 3 v2

THICKNESS: 0.08 INCH | SIZE A | UW -MADISON PART NUMBER 220e-450-013

ALL UNITS IN INCHES AND DEGREES

SOLIDWORKS Educational Product. For Instructional Use Only.
