Lileigh/Active-CAD/Manufacturing/Sheet Metal Bending/220e-450-015 - busbar 4 V2 .pdf

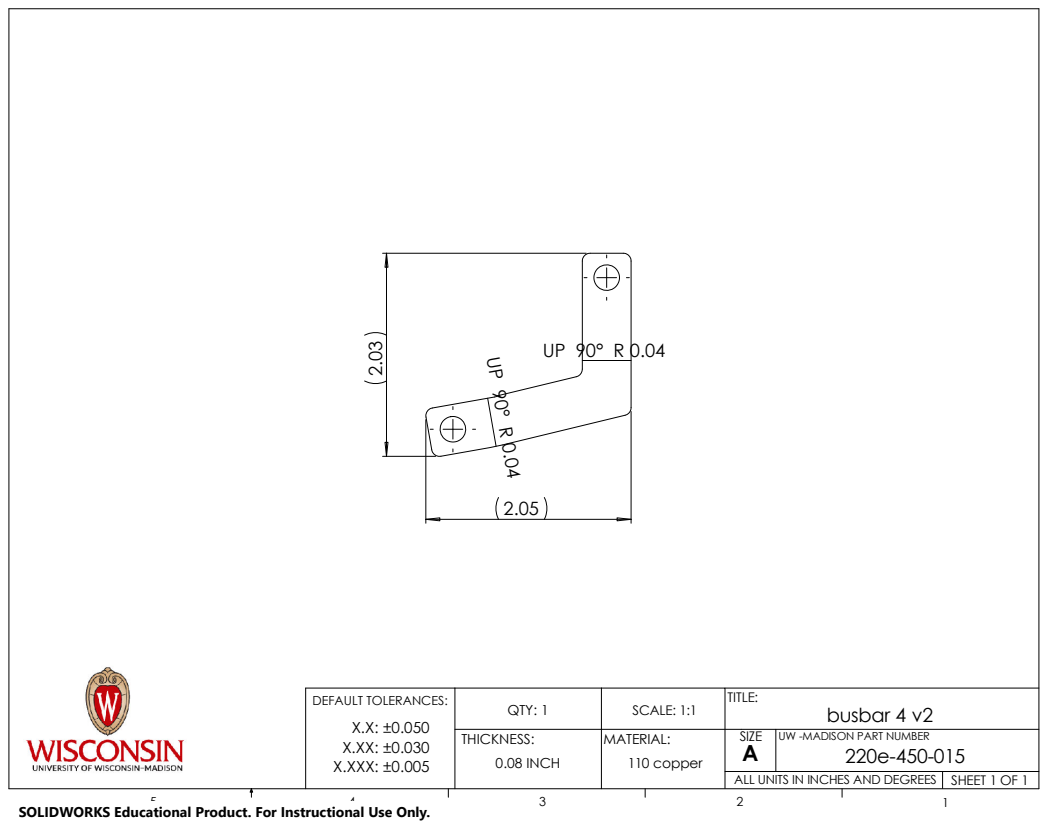
[picture p66: page 1]
SHEET 1 OF 1; busbar 4 v2 SCALE: 1:1 A; TITLE:; 110 copper; MATERIAL:

DEFAULT TOLERANCES: X.X: ±0.050 X.XX: ±0.030 X.XXX: ±0.005 | QTY: 1

SIZE
UW -MADISON PART NUMBER

THICKNESS: 0.08 INCH

ALL UNITS IN INCHES AND DEGREES

SOLIDWORKS Educational Product. For Instructional Use Only.
