Lileigh/Active-CAD/Manufacturing/Sheet Metal Bending/220e-450-017 - busbar 5.pdf

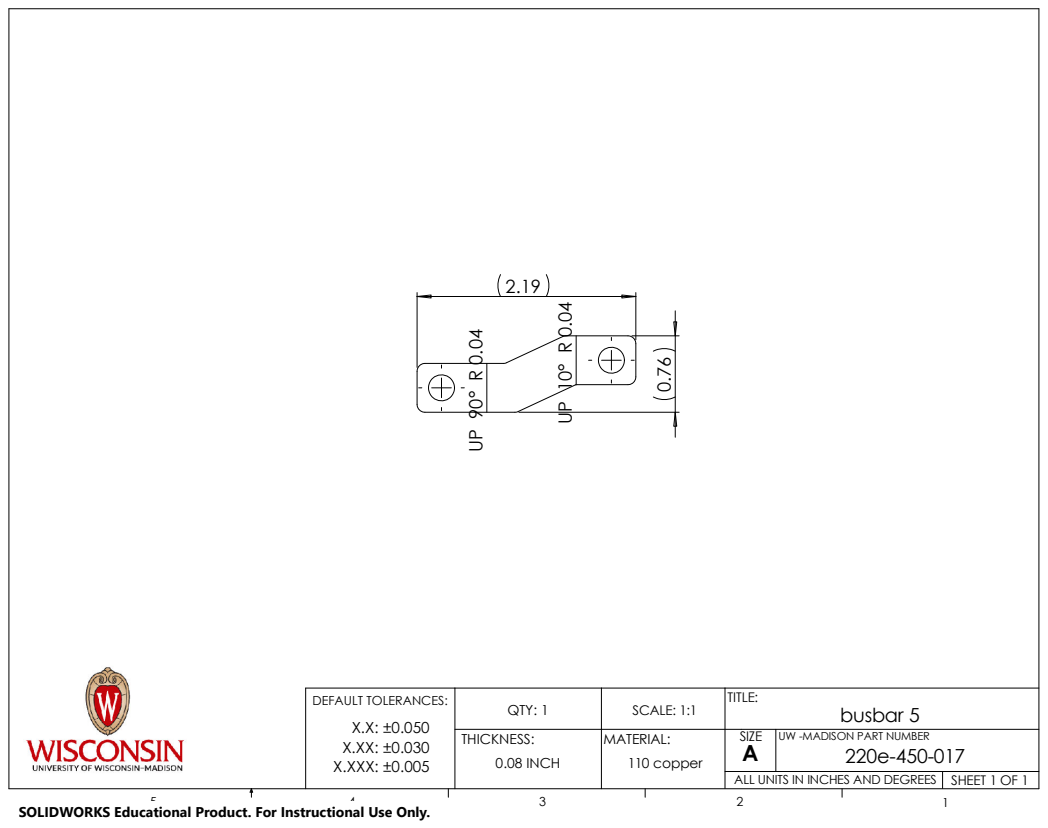
[picture p67: page 1]

DEFAULT TOLERANCES: X.X: ±0.050 X.XX: ±0.030 X.XXX: ±0.005 | QTY: 1 | | TITLE: busbar 5 SCALE: 1:1

THICKNESS: 0.08 INCH | MATERIAL: 110 copper | SIZE A | UW -MADISON PART NUMBER 220e-450-017

ALL UNITS IN INCHES AND DEGREES | SHEET 1 OF 1

SOLIDWORKS Educational Product. For Instructional Use Only.
