Lileigh/Active-CAD/Manufacturing/Sheet Metal Bending/220e-450-019 - busbar 6.pdf

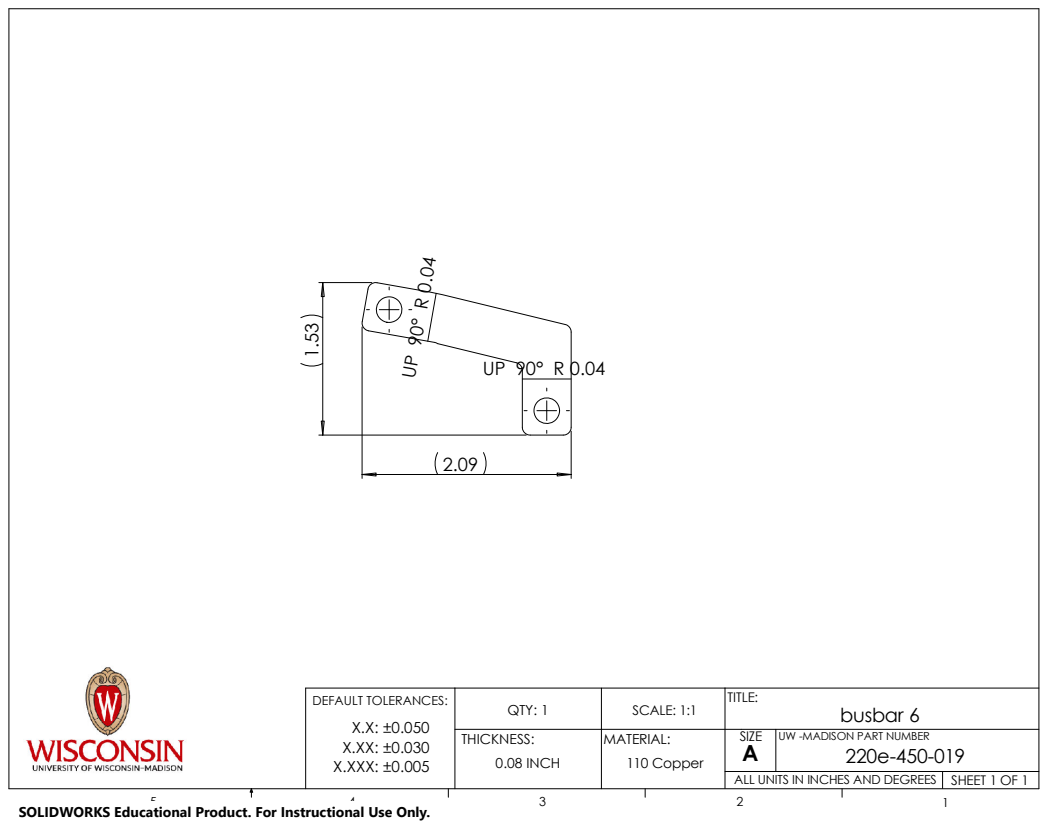
[picture p68: page 1]
DEFAULT TOLERANCES:; busbar 6 SCALE: 1:1; TITLE:; QTY: 1; X.X: ±0.050 X.XX: ±0.030 X.XXX: ±0.005

THICKNESS: MATERIAL: 0.08 INCH 110 Copper | SIZE A | UW -MADISON PART NUMBER 220e-450-019

ALL UNITS IN INCHES AND DEGREES | SHEET 1 OF 1

SOLIDWORKS Educational Product. For Instructional Use Only.
