Lileigh/Active-CAD/Manufacturing/Sheet Metal Bending/220e-450-021 - DC Link Positive.pdf

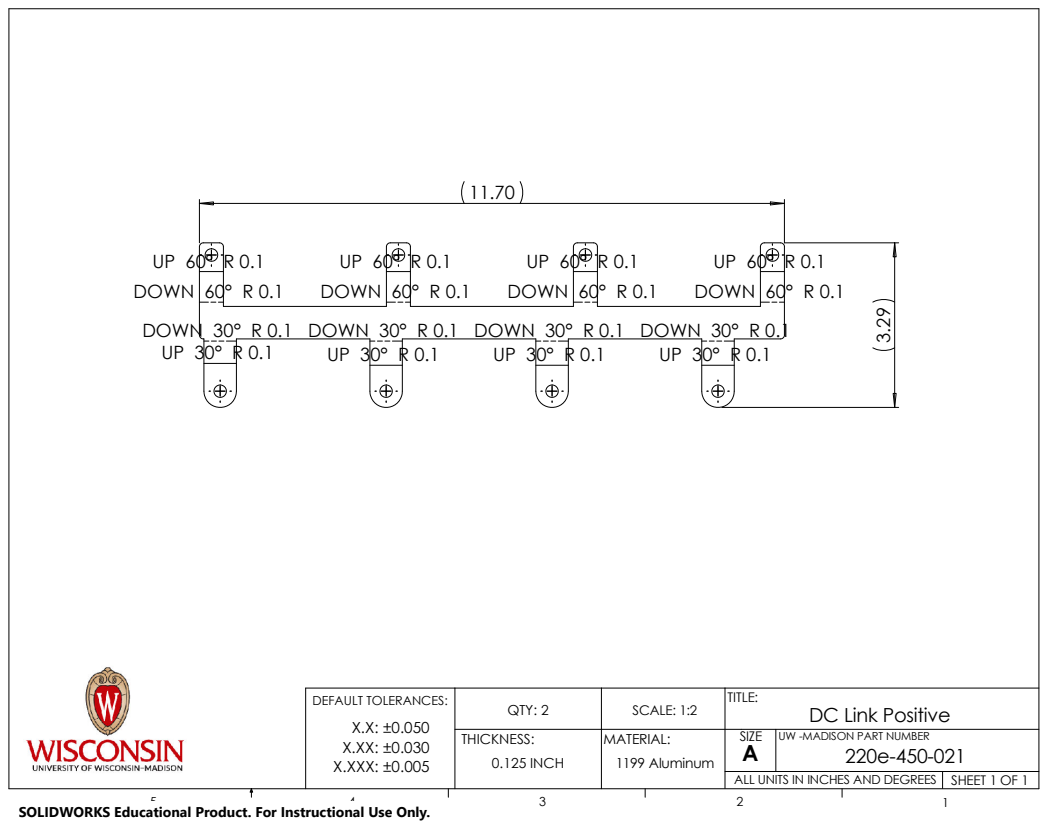
[picture p69: page 1]
DOWN; DOWN 30° R 0.1; DOWN 30° R 0.1 UP 30° R 0.1

DEFAULT TOLERANCES: X.X: ±0.050 X.XX: ±0.030 X.XXX: ±0.005 | QTY: 2 | | TITLE: DC Link Positive SCALE: 1:2

THICKNESS: 0.125 INCH | MATERIAL: 1199 Aluminum | SIZE A | UW -MADISON PART NUMBER 220e-450-021

ALL UNITS IN INCHES AND DEGREES | SHEET 1 OF 1

SOLIDWORKS Educational Product. For Instructional Use Only.
