Lileigh/Active-CAD/Manufacturing/Sheet Metal Bending/220e-450-023 - DC Link Negative.pdf

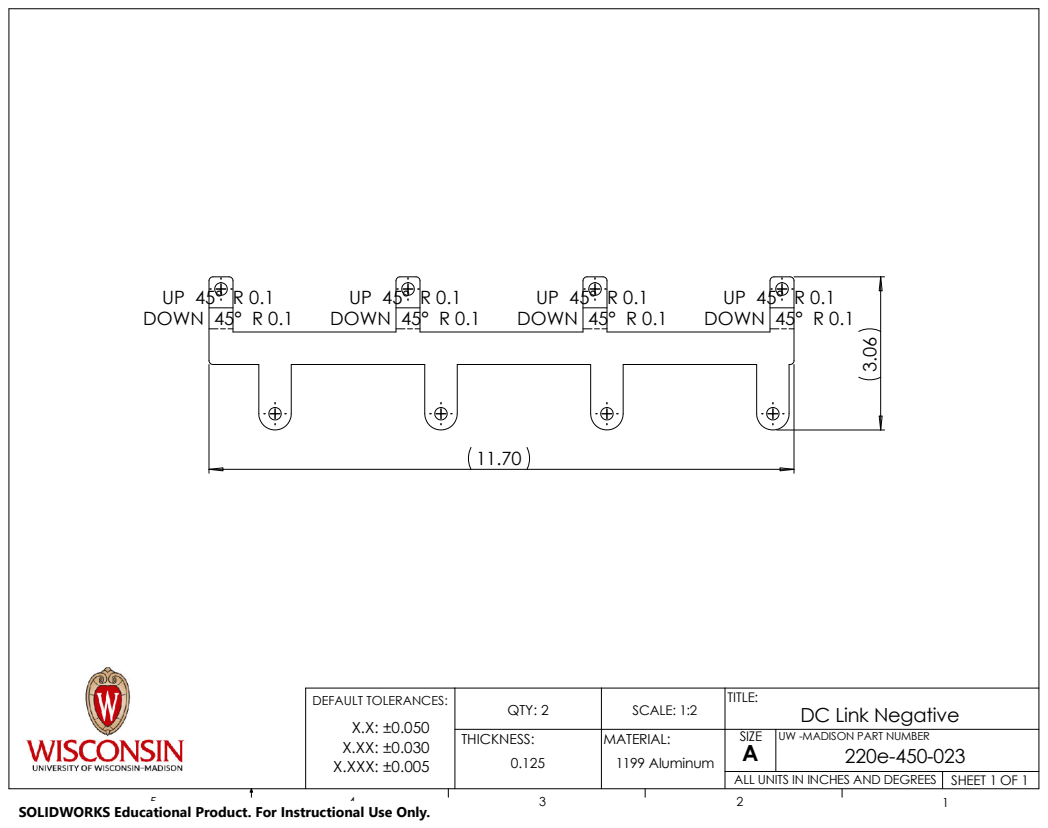
[picture p70: page 1]
DOWN

DEFAULT TOLERANCES: X.X: ±0.050 X.XX: ±0.030 X.XXX: ±0.005 | QTY: 2 | SCALE: 1:2 | TITLE: DC Link Negative

THICKNESS: 0.125 | MATERIAL: 1199 Aluminum | SIZE A | UW -MADISON PART NUMBER 220e-450-023

ALL UNITS IN INCHES AND DEGREES | SHEET 1 OF 1

SOLIDWORKS Educational Product. For Instructional Use Only.
