Lileigh/Active-CAD/Manufacturing/Palmer Hamilton/Brake Rotor Front.pdf

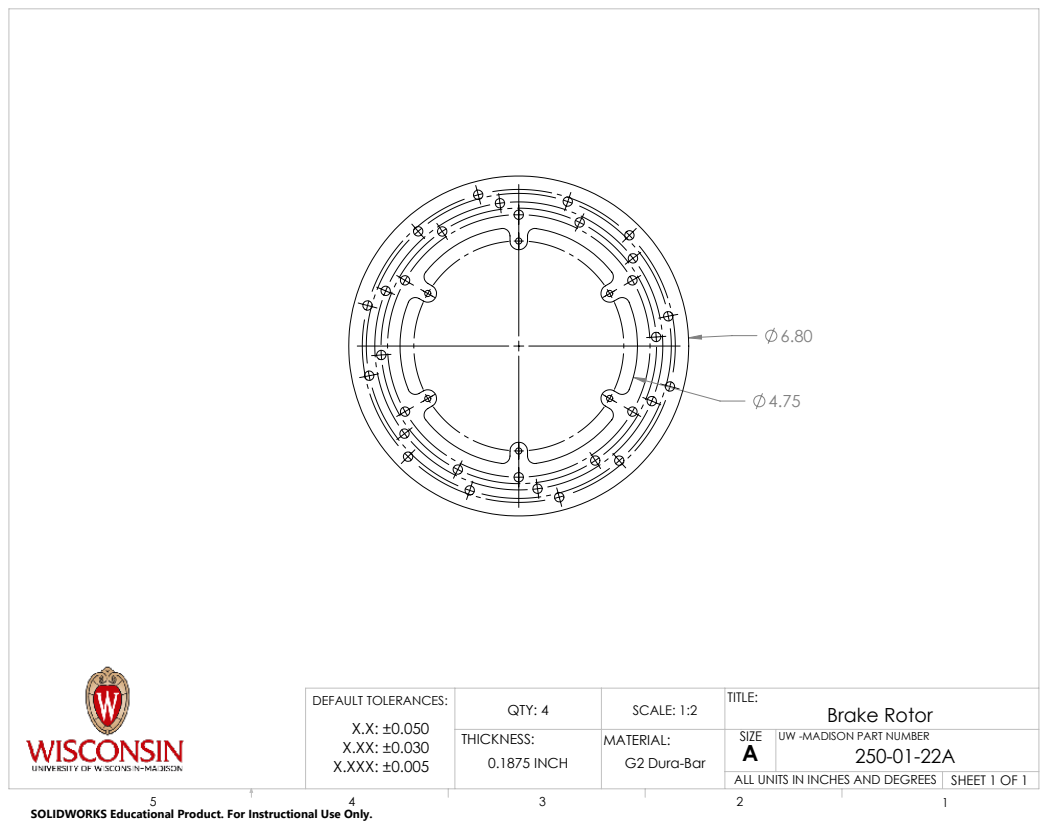
[picture p71: page 1]
Brake Rotor; SHEET 1 OF 1; SCALE: 1:2; G2 Dura-Bar; QTY: 4; 0.1875 INCH; DEFAULT TOLERANCES: X.X: ±0.050 X.XX: ±0.030 X.XXX: ±0.005

SIZE
UW -MADISON PART NUMBER

ALL UNITS IN INCHES AND DEGREES

SOLIDWORKS Educational Product. For Instructional Use Only.
