Lileigh/Active-CAD/Manufacturing/Sheet Metal Bending/212-15-20-B.pdf

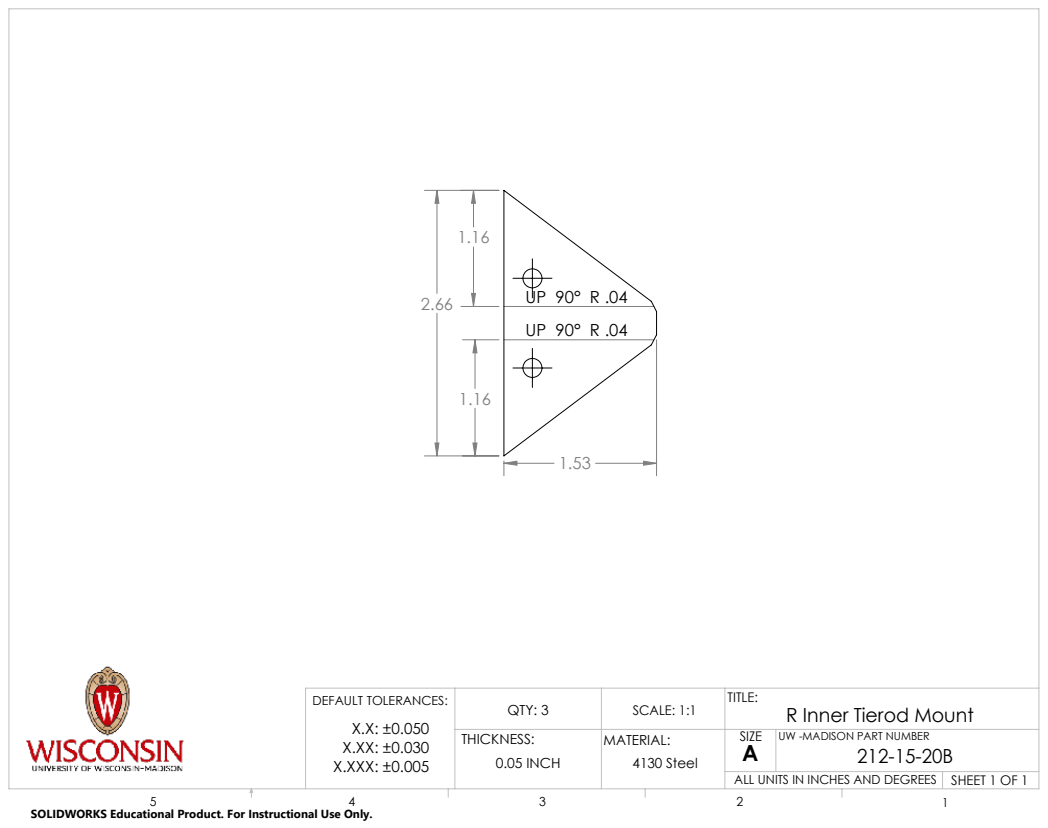
[picture p72: page 1]
SHEET 1 OF 1; SCALE: 1:1; 4130 Steel; QTY: 3; 0.05 INCH; DEFAULT TOLERANCES: X.X: ±0.050 X.XX: ±0.030 X.XXX: ±0.005

TITLE:
R Inner Tierod Mount
SIZE
UW -MADISON PART NUMBER

ALL UNITS IN INCHES AND DEGREES

SOLIDWORKS Educational Product. For Instructional Use Only.
