Lileigh/Active-CAD/200 - Chassis/220 - Actuation/223 - Adjustment Rods/223-13-17B.pdf

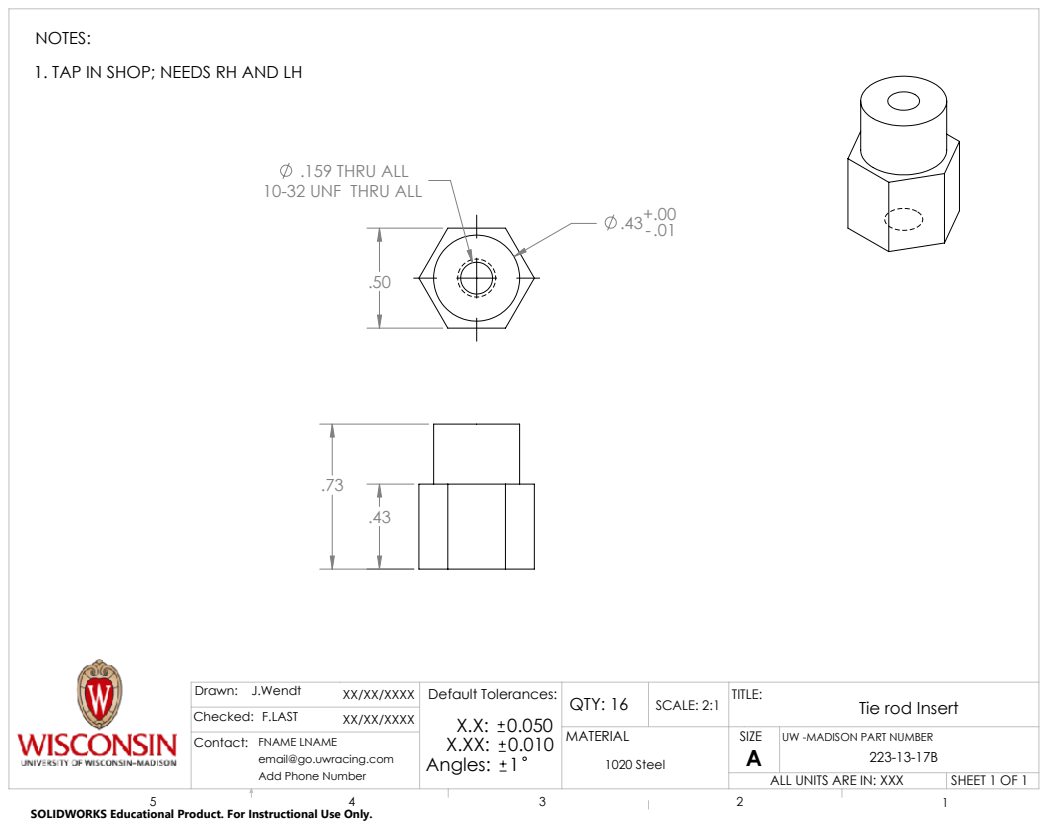
[picture p73: page 1]
SHEET 1 OF 1; SCALE: 2:1; 1020 Steel; QTY: 16; Checked: F.LAST; XX/XX/XXXX; Angles:; 1 email@go.uwracing.com

NOTES:
1. TAP IN SHOP; NEEDS RH AND LH

.159 THRU ALL
10-32 UNF THRU ALL

Drawn:
Contact: FNAME LNAME

XX/XX/XXXX Default Tolerances:

TITLE:
ALL UNITS ARE IN: XXX

Tie rod Insert

SIZE
UW -MADISON PART NUMBER

Add Phone Number

SOLIDWORKS Educational Product. For Instructional Use Only.
