Lileigh/Active-CAD/400 - E Drivetrain/420 - Transmission/Gear Drawings/220e-320-05 Ring Gear.PDF

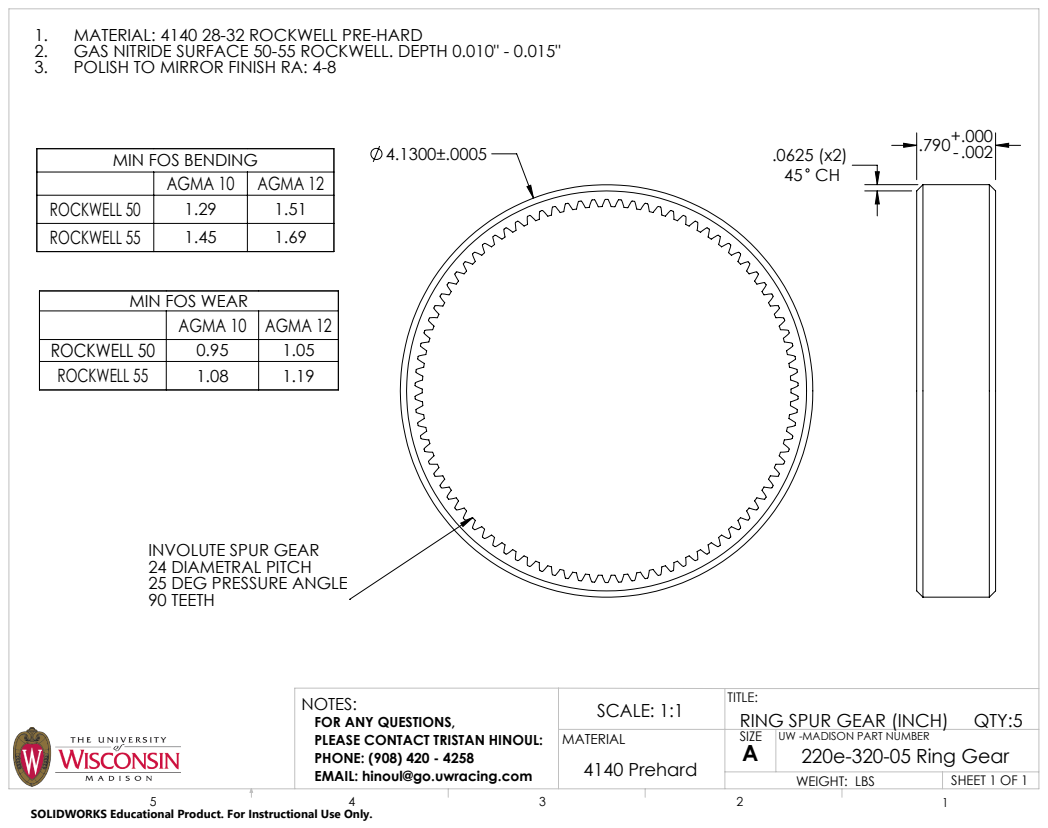
[picture p80: page 1]
SHEET 1 OF 1; SCALE: 1:1; 4140 Prehard

1. MATERIAL: 4140 28-32 ROCKWELL PRE-HARD
2. GAS NITRIDE SURFACE 50-55 ROCKWELL. DEPTH 0.010" - 0.015"
3. POLISH TO MIRROR FINISH RA: 4-8

MIN FOS BENDING

AGMA 10 | AGMA 12

ROCKWELL 50 | 1.29 | 1.51
ROCKWELL 55 | 1.45 | 1.69

MIN FOS WEAR

ROCKWELL 50 | 0.95 | 1.05
ROCKWELL 55 | 1.08 | 1.19

INVOLUTE SPUR GEAR
24 DIAMETRAL PITCH
25 DEG PRESSURE ANGLE
90 TEETH

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

TITLE:
RING SPUR GEAR (INCH) QTY:5
SIZE
UW -MADISON PART NUMBER
220e-320-05 Ring Gear
WEIGHT: LBS

SOLIDWORKS Educational Product. For Instructional Use Only.
