Lileigh/Active-CAD/400 - E Drivetrain/430 - Cooling/Cold Plate/223e-338-01 Finned Base Plate Extended Reference Holes Drawing.pdf

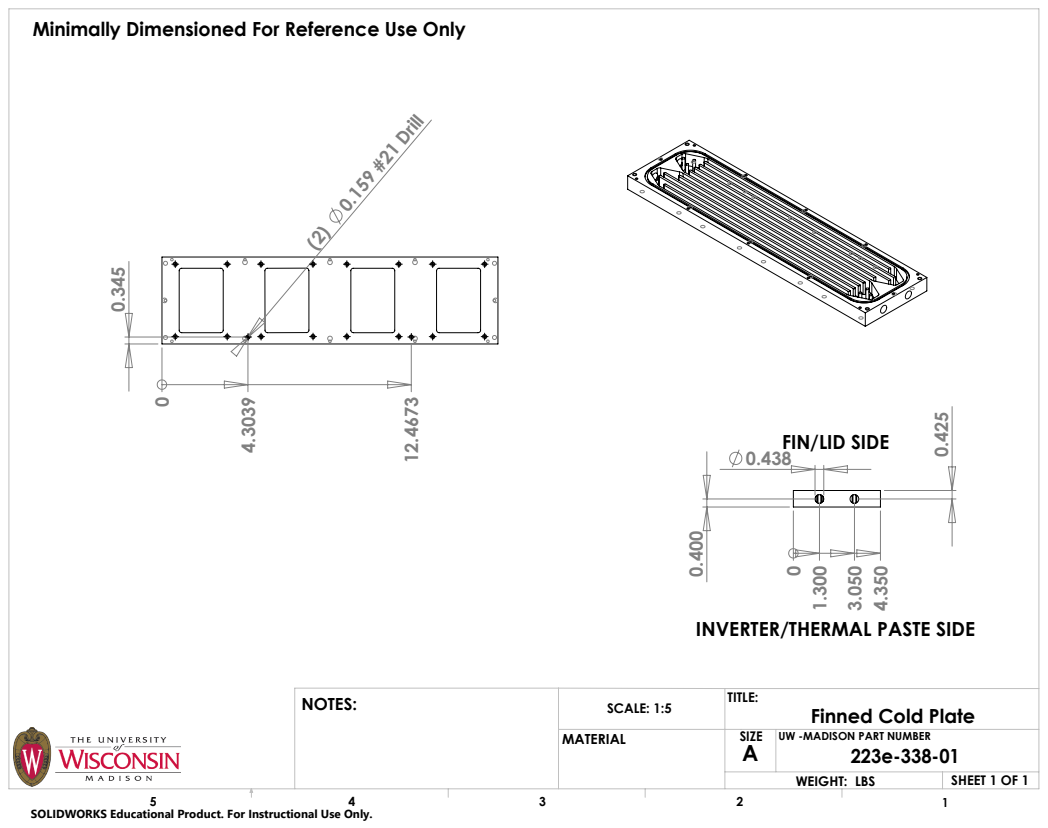
[picture p81: page 1]
0.159 #21 Drill; SHEET 1 OF 1; SCALE: 1:5; WEIGHT: LBS; NOTES:; Finned Cold Plate

Minimally Dimensioned For Reference Use Only

FIN/LID SIDE

INVERTER/THERMAL PASTE SIDE

SIZE
UW -MADISON PART NUMBER

SOLIDWORKS Educational Product. For Instructional Use Only.
