Lileigh/Active-CAD/400 - E Drivetrain/430 - Cooling/Cold Plate/223e-338-01 Finned Base Plate Extended.pdf

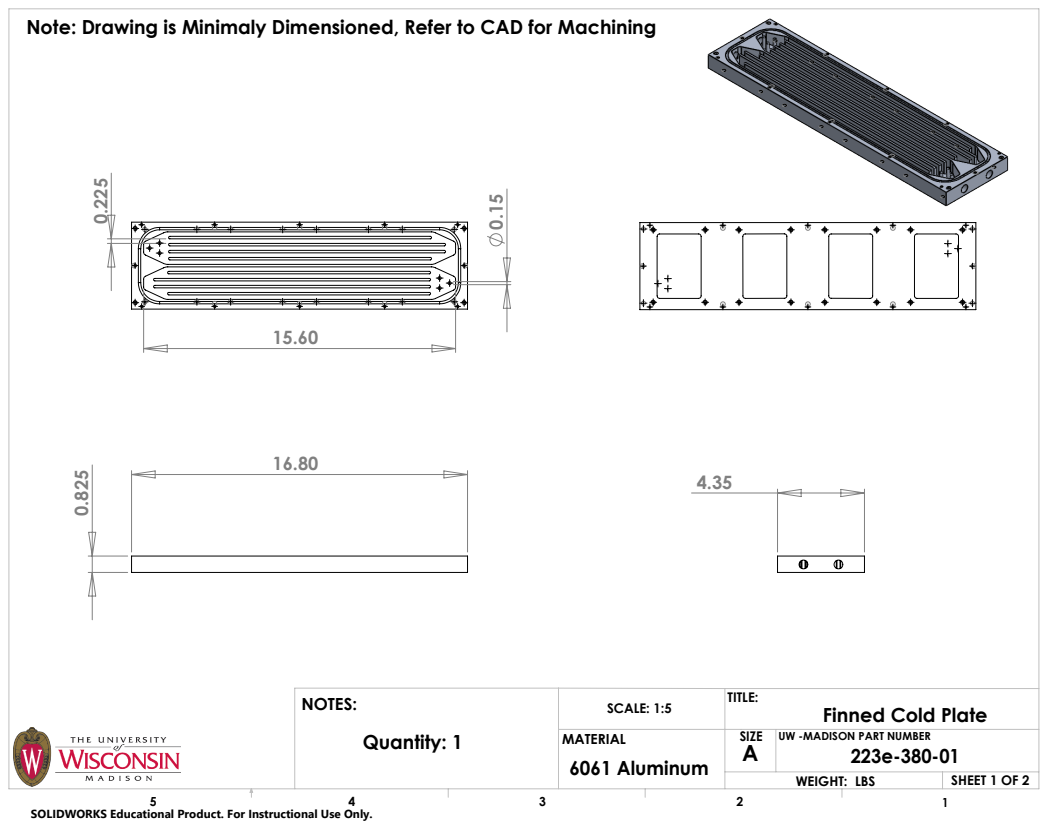
[picture p82: page 1]
SHEET 1 OF 2; SCALE: 1:5; WEIGHT: LBS; NOTES:; Finned Cold Plate; 6061 Aluminum; Quantity: 1

Note: Drawing is Minimaly Dimensioned, Refer to CAD for Machining

SIZE
UW -MADISON PART NUMBER

SOLIDWORKS Educational Product. For Instructional Use Only.

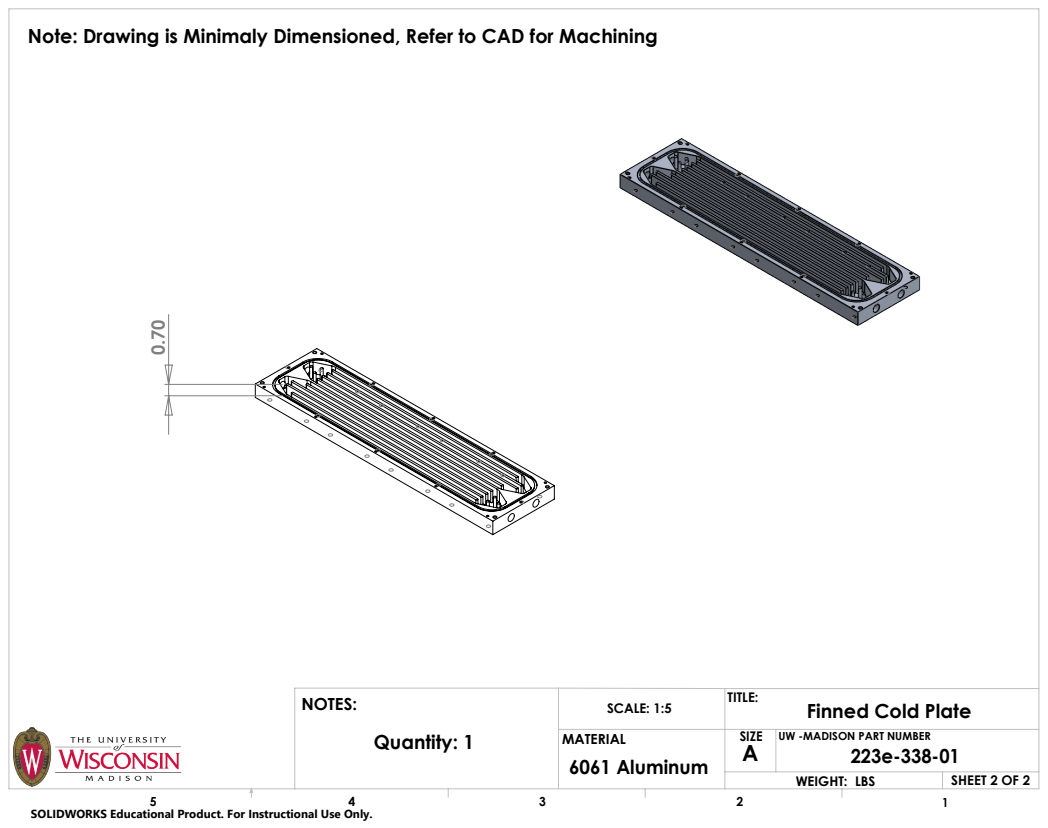
[picture p83: page 2]
SHEET 2 OF 2; SCALE: 1:5; WEIGHT: LBS; NOTES:; Finned Cold Plate; 6061 Aluminum; Quantity: 1

Note: Drawing is Minimaly Dimensioned, Refer to CAD for Machining

SIZE
UW -MADISON PART NUMBER

SOLIDWORKS Educational Product. For Instructional Use Only.
