Lileigh/Active-CAD/400 - E Drivetrain/430 - Cooling/Cold Plate/223e-338-03 Straight Fin Lid V2.pdf

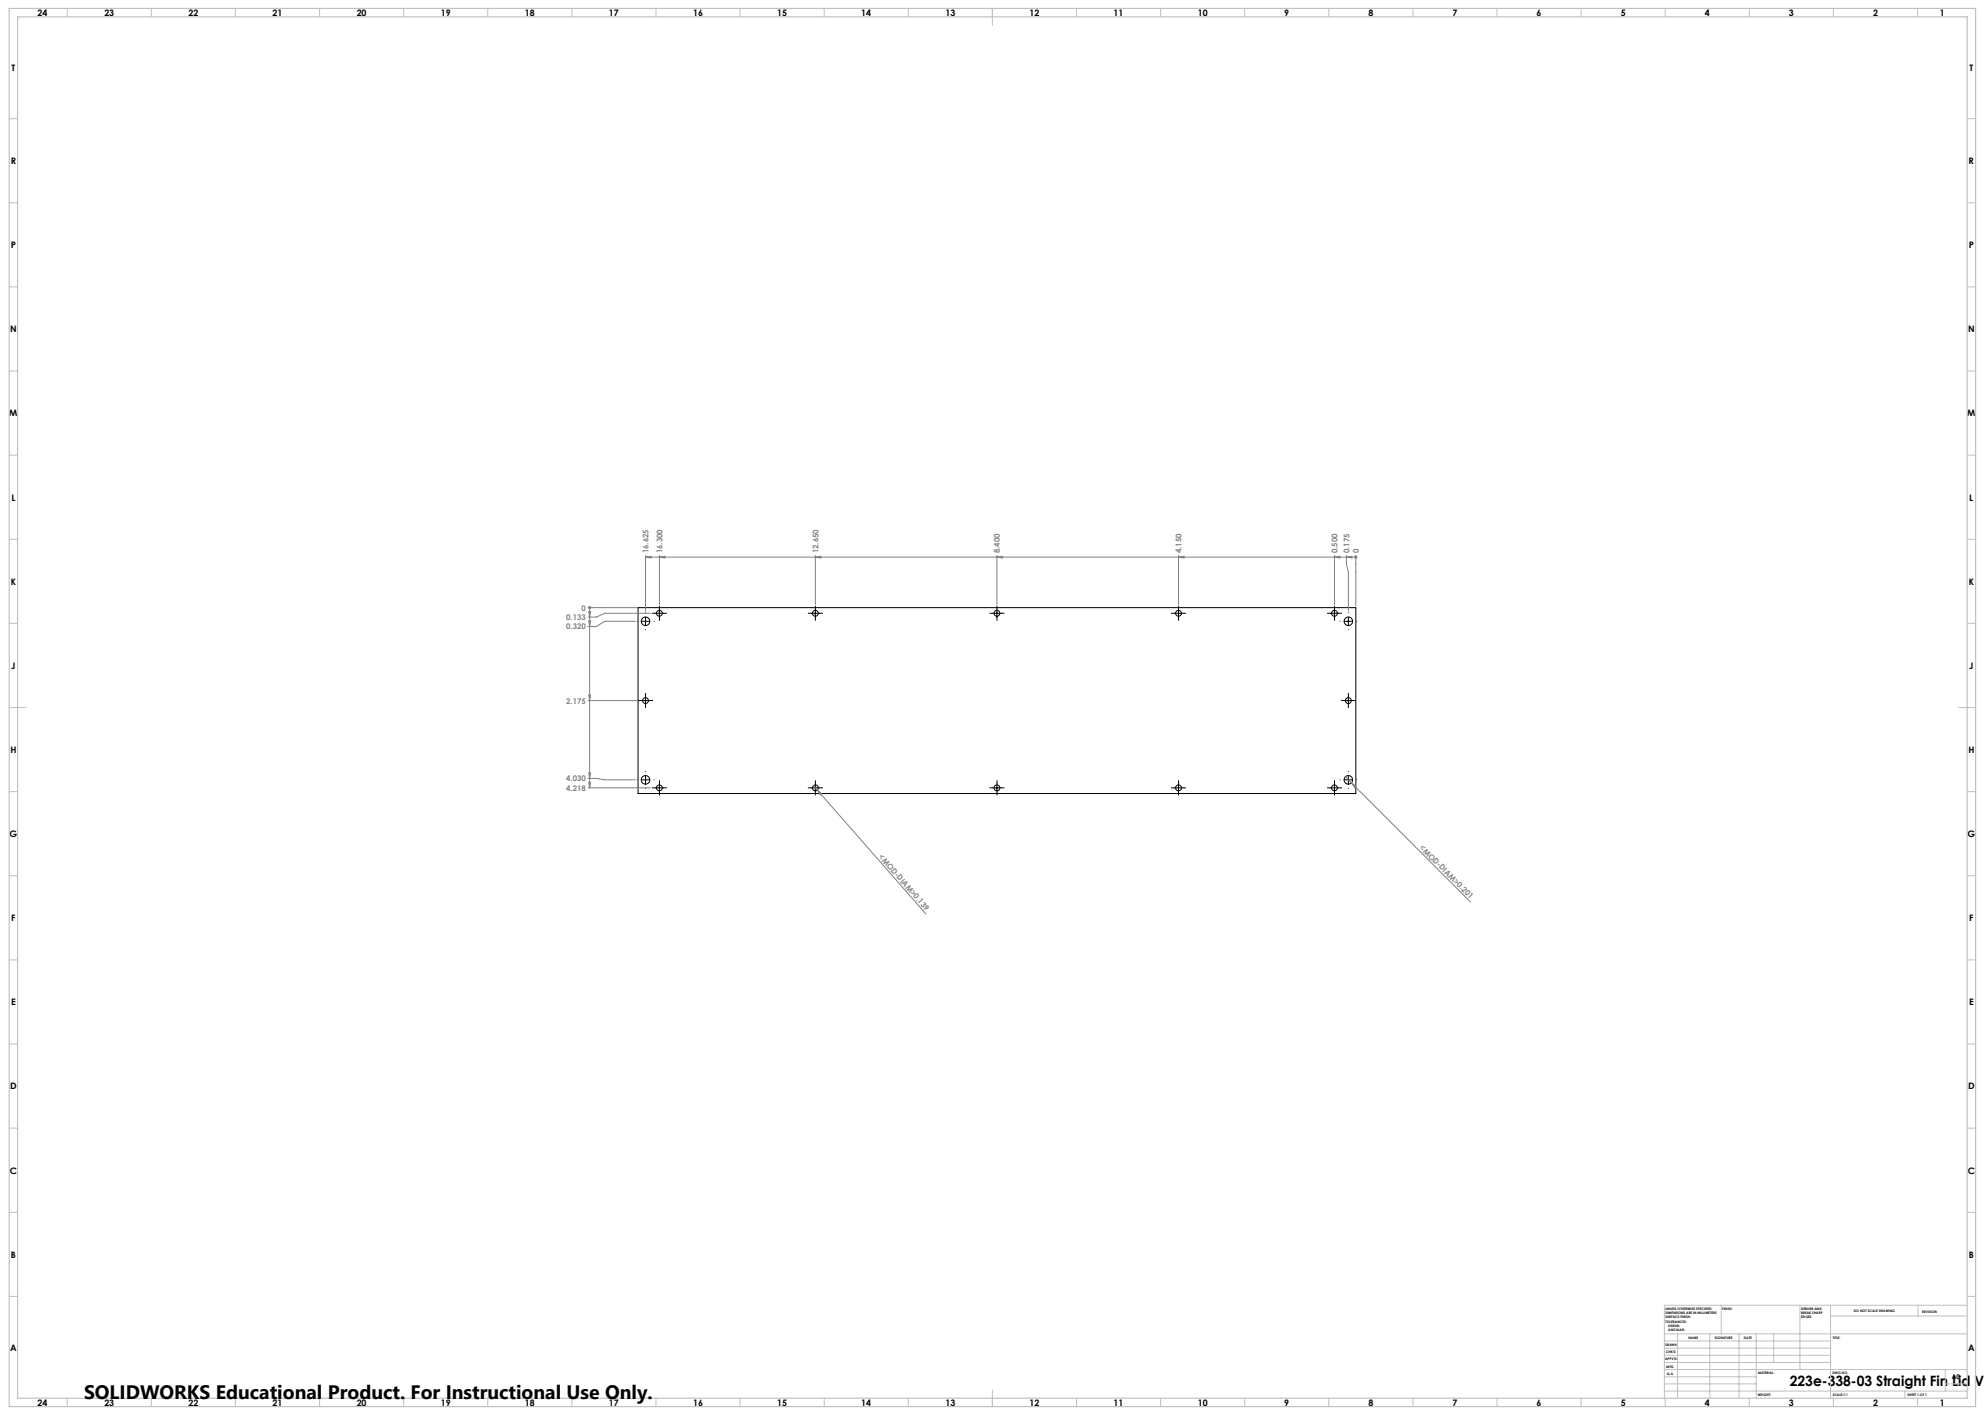
[picture p84: page 1]
FINISH:; DEBURR AND; BREAK SHARP; DO NOT SCALE DRAWING; REVISION; SCALE:1:1; SHEET 1 OF 1

UNLESS OTHERWISE SPECIFIED:
DIMENSIONS ARE IN MILLIMETERS
SURFACE FINISH:
TOLERANCES:
LINEAR:
ANGULAR:

NAME | SIGNATURE | DATE | | | | TITLE:

223e-338-03 Straight Fin Lid V2 SOLIDWORKS Educational Product. For Instructional Use Only.

DRAWN
CHK'D
APPV'D
MFG
Q.A | | | | MATERIAL: | DWG NO. | A0
