Lileigh/Active-CAD/400 - E Drivetrain/410 - Motor/Drawings/220e-310-01 Stator Stack.PDF

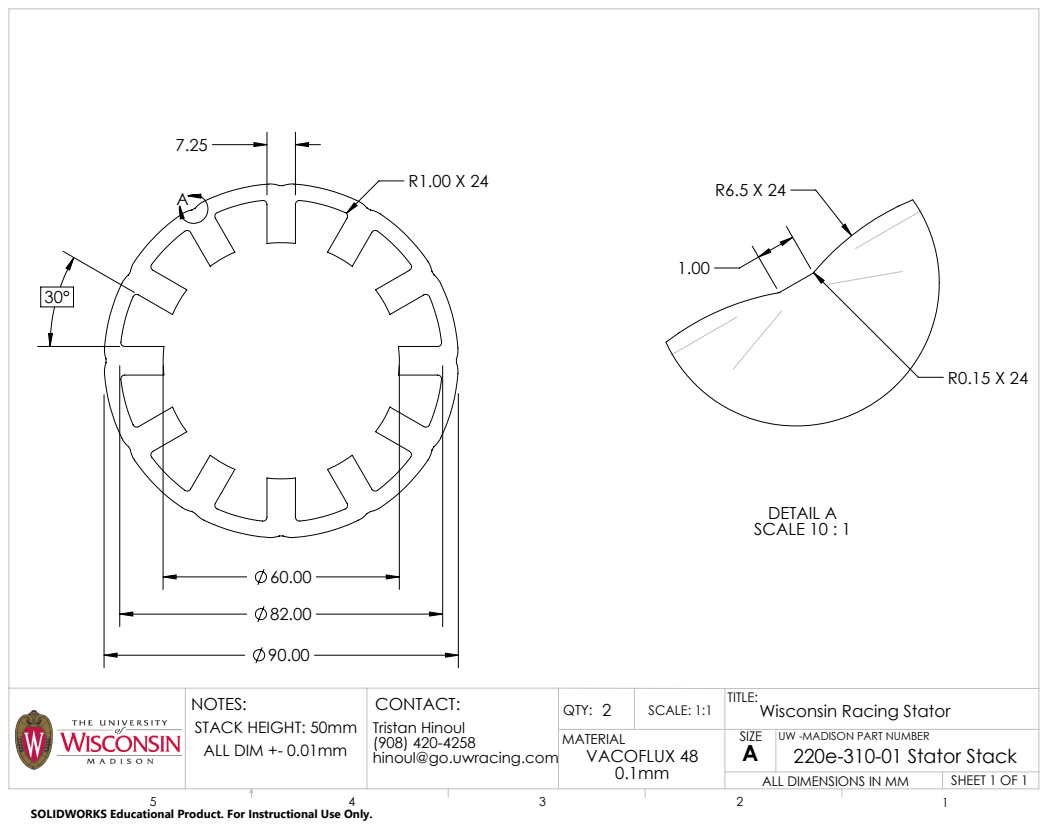
[picture p85: page 1]
DETAIL A SCALE 10 : 1; VACOFLUX 48; STACK HEIGHT: 50mm ALL DIM +- 0.01mm; Wisconsin Racing Stator; SHEET 1 OF 1; SCALE: 1:1

TITLE:
220e-310-01 Stator Stack
ALL DIMENSIONS IN MM

Tristan Hinoul
hinoul@go.uwracing.com

SIZE
UW -MADISON PART NUMBER

SOLIDWORKS Educational Product. For Instructional Use Only.
