Lileigh/Active-CAD/400 - E Drivetrain/410 - Motor/Drawings/220e-310-02 Rotor Stack.PDF

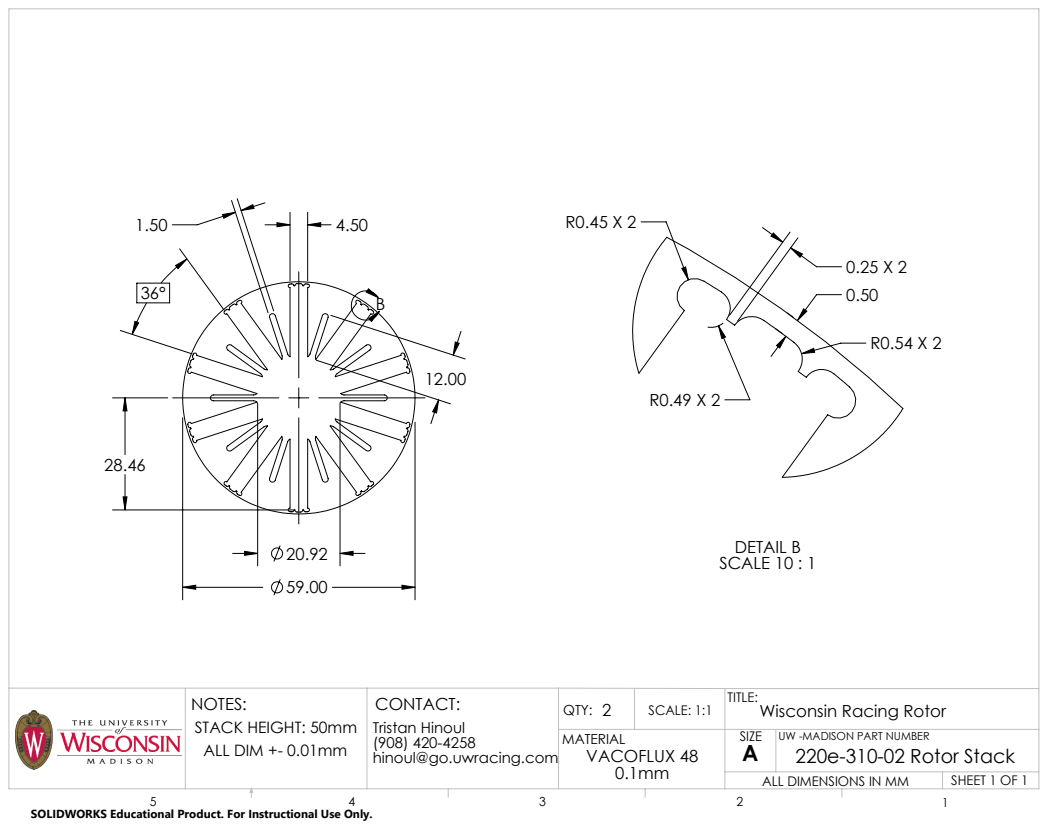
[picture p86: page 1]
DETAIL B SCALE 10 : 1; VACOFLUX 48; STACK HEIGHT: 50mm ALL DIM +- 0.01mm; Wisconsin Racing Rotor; SHEET 1 OF 1; SCALE: 1:1

TITLE:
220e-310-02 Rotor Stack
ALL DIMENSIONS IN MM

Tristan Hinoul
hinoul@go.uwracing.com

SIZE
UW -MADISON PART NUMBER

SOLIDWORKS Educational Product. For Instructional Use Only.
