Lileigh/Active-CAD/400 - E Drivetrain/410 - Motor/Drawings/220e-310-03 Shaft Edgerton.PDF

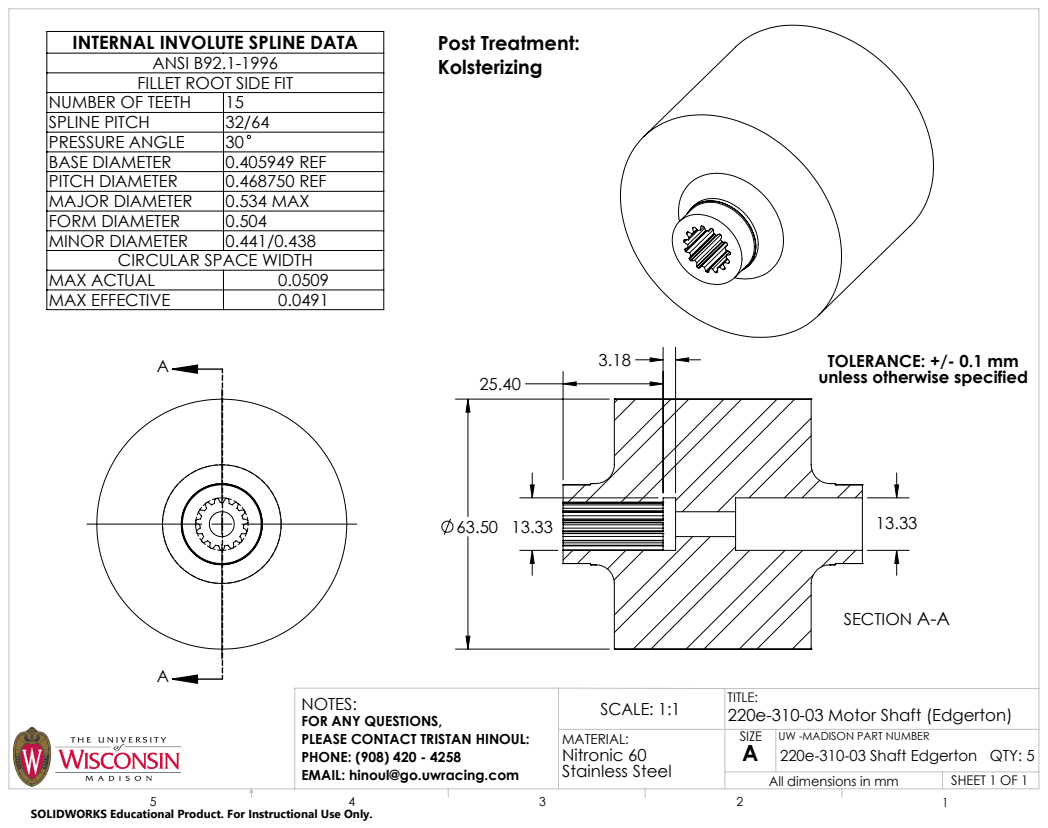
[picture p87: page 1]
SECTION A-A; Post Treatment:; ANSI B92.1-1996; SHEET 1 OF 1; SCALE: 1:1; NOTES:; 220e-310-03 Motor Shaft (Edgerton); Nitronic 60 Stainless Steel

INTERNAL INVOLUTE SPLINE DATA
FILLET ROOT SIDE FIT

NUMBER OF TEETH | 15
SPLINE PITCH | 32/64
PRESSURE ANGLE | 30
BASE DIAMETER | 0.405949 REF
PITCH DIAMETER | 0.468750 REF
MAJOR DIAMETER | 0.534 MAX
FORM DIAMETER | 0.504
MINOR DIAMETER | 0.441/0.438
MAX ACTUAL | 0.0509
MAX EFFECTIVE | 0.0491

CIRCULAR SPACE WIDTH

TOLERANCE: +/- 0.1 mm
unless otherwise specified

FOR ANY QUESTIONS,
PLEASE CONTACT TRISTAN HINOUL:
PHONE: (908) 420 - 4258
EMAIL: hinoul@go.uwracing.com

TITLE:
220e-310-03 Shaft Edgerton QTY: 5
All dimensions in mm

SIZE
UW -MADISON PART NUMBER

SOLIDWORKS Educational Product. For Instructional Use Only.
