Lileigh/Active-CAD/400 - E Drivetrain/410 - Motor/Drawings/220e-310-03 Shaft LATHE BLANK.PDF

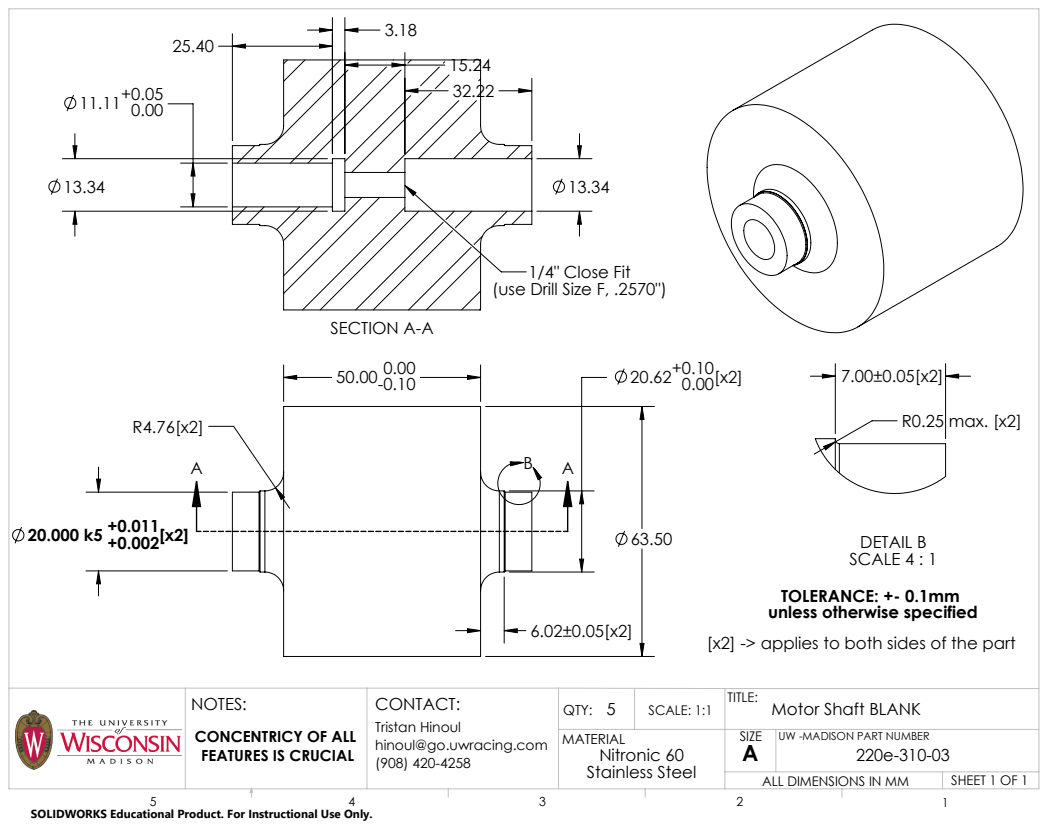
[picture p88: page 1]
SECTION A-A; R0.25 max. [x2]; SHEET 1 OF 1; SCALE: 1:1; NOTES:; CONTACT:; QTY: 5; Motor Shaft BLANK; Nitronic 60 Stainless Steel

1/4" Close Fit
(use Drill Size F, .2570")

DETAIL B
SCALE 4 : 1
TOLERANCE: +- 0.1mm
unless otherwise specified
[x2] -> applies to both sides of the part

CONCENTRICY OF ALL
FEATURES IS CRUCIAL

Tristan Hinoul
hinoul@go.uwracing.com

SIZE
UW -MADISON PART NUMBER

ALL DIMENSIONS IN MM

SOLIDWORKS Educational Product. For Instructional Use Only.
