Lileigh/Active-CAD/400 - E Drivetrain/410 - Motor/Drawings/220e-310-04 SmCo Magnet Segment.PDF

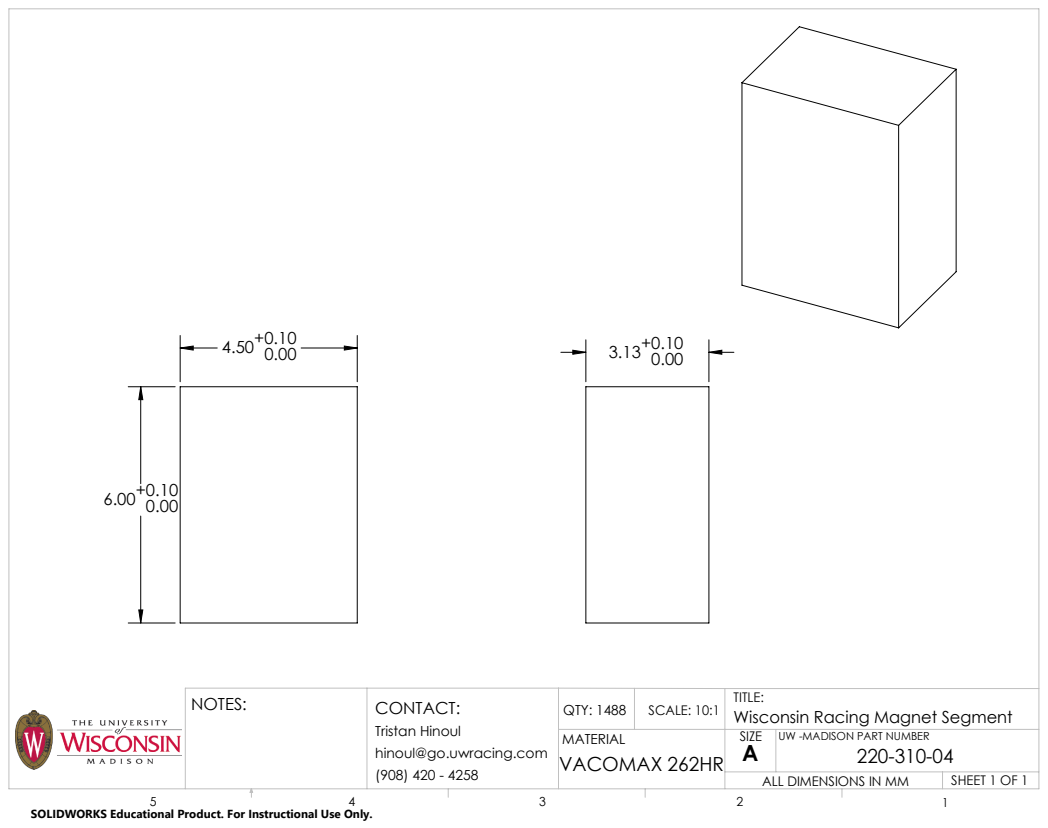
[picture p89: page 1]
SHEET 1 OF 1; SCALE: 10:1; NOTES:; QTY: 1488; Wisconsin Racing Magnet Segment; VACOMAX 262HR

CONTACT:
Tristan Hinoul
hinoul@go.uwracing.com

SIZE
UW -MADISON PART NUMBER

ALL DIMENSIONS IN MM

SOLIDWORKS Educational Product. For Instructional Use Only.
