Lileigh/Active-CAD/400 - E Drivetrain/410 - Motor/Drawings/220e-310-18 Cooled Housing.PDF

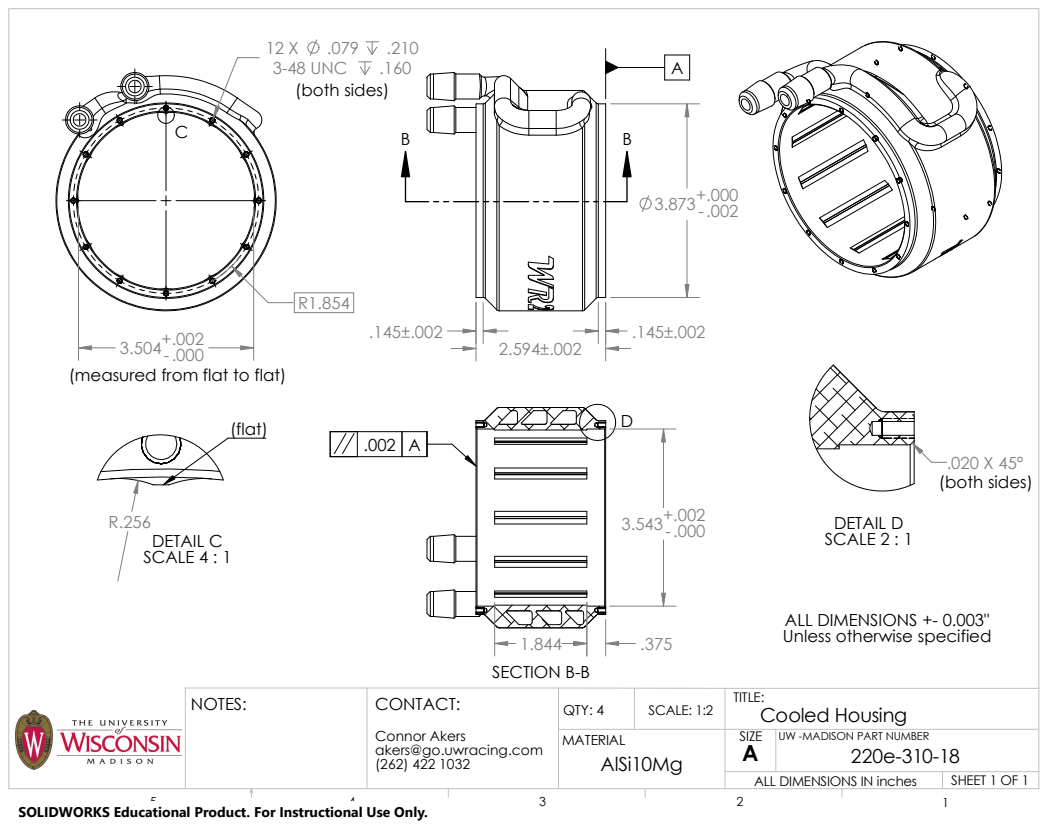
[picture p90: page 1]
(both sides); 3-48 UNC; DETAIL C SCALE 4 : 1; (flat); DETAIL D; SCALE 2 : 1; SECTION B-B

(measured from flat to flat)

ALL DIMENSIONS +- 0.003"
Unless otherwise specified

NOTES: | CONTACT: Connor Akers akers@go.uwracing.com (262) 422 1032 | QTY: 4 | SCALE: 1:2 | TITLE: Cooled Housing

MATERIAL AlSi10Mg | SIZE A | UW -MADISON PART NUMBER 220e-310-18

ALL DIMENSIONS IN inches | SHEET 1 OF 1

SOLIDWORKS Educational Product. For Instructional Use Only.
