Lileigh/Active-CAD/400 - E Drivetrain/410 - Motor/Drawings/220e-312-00 Segmented SmCo Magnet.PDF

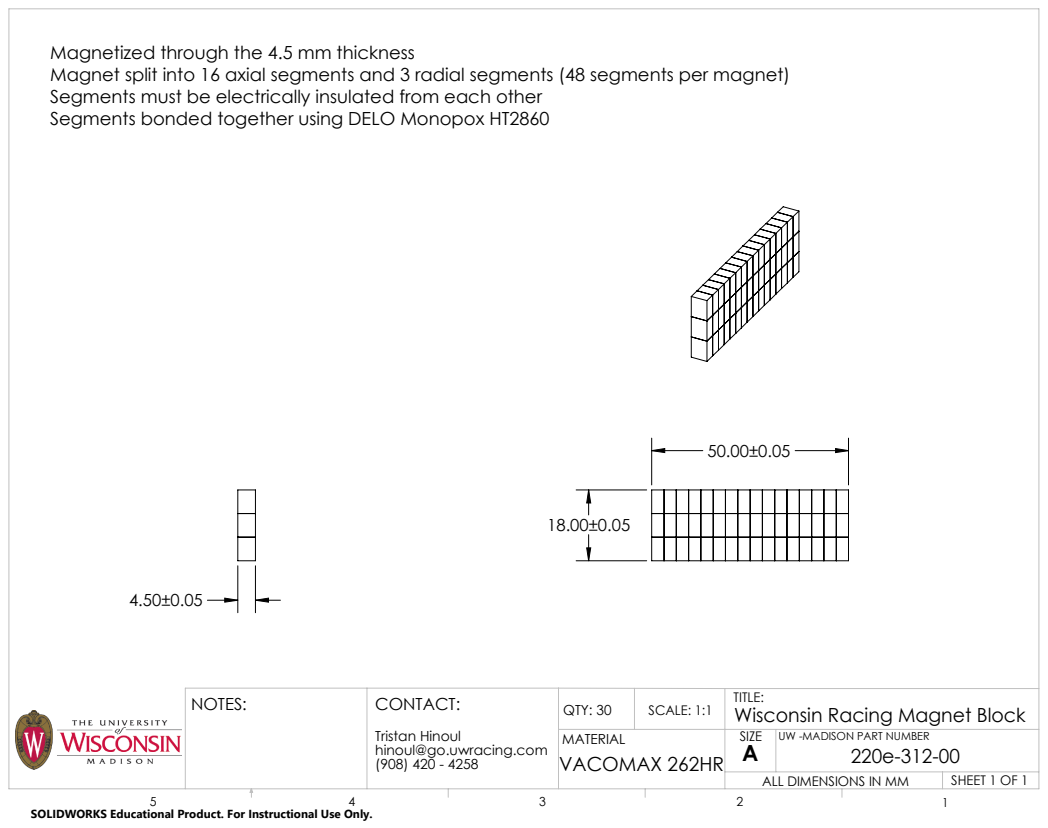
[picture p91: page 1]
SHEET 1 OF 1; SCALE: 1:1; NOTES:; QTY: 30; Wisconsin Racing Magnet Block; VACOMAX 262HR

Magnetized through the 4.5 mm thickness
Magnet split into 16 axial segments and 3 radial segments (48 segments per magnet)
Segments must be electrically insulated from each other
Segments bonded together using DELO Monopox HT2860

CONTACT:
Tristan Hinoul
hinoul@go.uwracing.com

SIZE
UW -MADISON PART NUMBER

ALL DIMENSIONS IN MM

SOLIDWORKS Educational Product. For Instructional Use Only.
