Lileigh/Active-CAD/Cost Report/Cost-SU-Assem.pdf

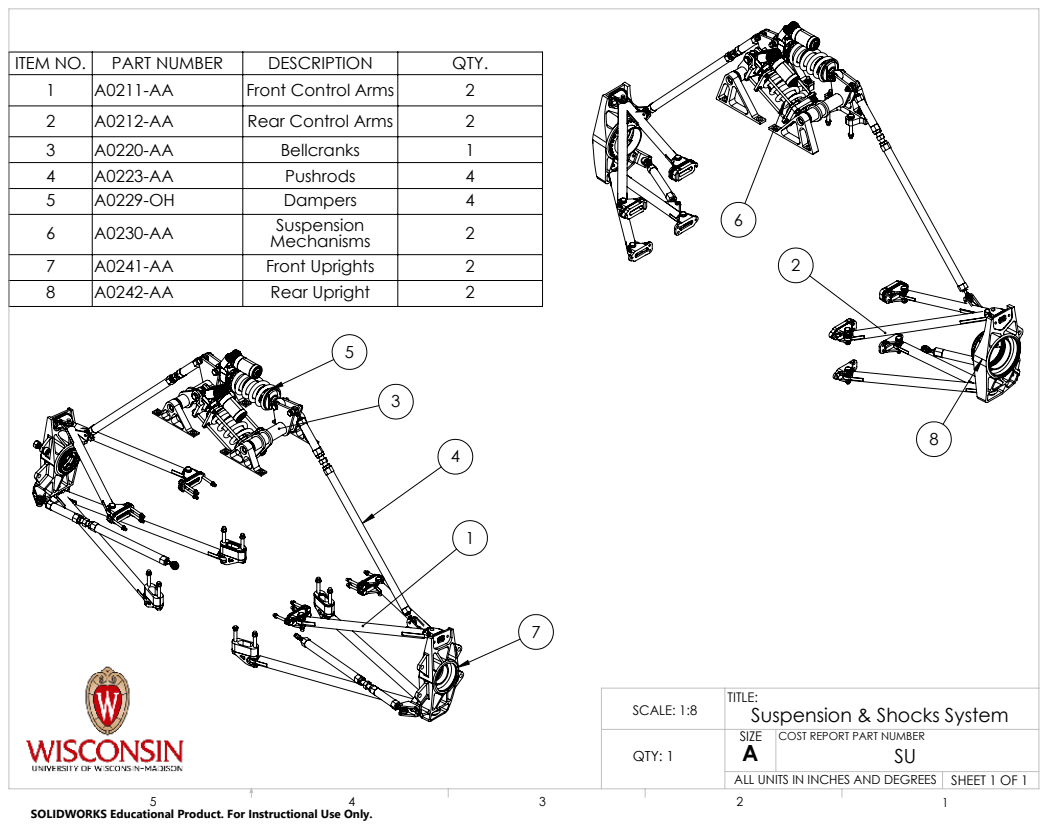
[picture p92: page 1]
SHEET 1 OF 1; SCALE: 1:8; QTY: 1

ITEM NO. | PART NUMBER | DESCRIPTION | QTY.
1 | A0211-AA | Front Control Arms | 2
2 | A0212-AA | Rear Control Arms | 2
3 | A0220-AA | Bellcranks | 1
4 | A0223-AA | Pushrods | 4
5 | A0229-OH | Dampers | 4
6 | A0230-AA | Suspension Mechanisms | 2
7 | A0241-AA | Front Uprights | 2
8 | A0242-AA | Rear Upright | 2

TITLE:
Suspension & Shocks System
SIZE
COST REPORT PART NUMBER

ALL UNITS IN INCHES AND DEGREES

SOLIDWORKS Educational Product. For Instructional Use Only.
