Lileigh/Active-CAD/200 - Chassis/Drawings/212-17-23B Rear Lower Aft Clevis.pdf

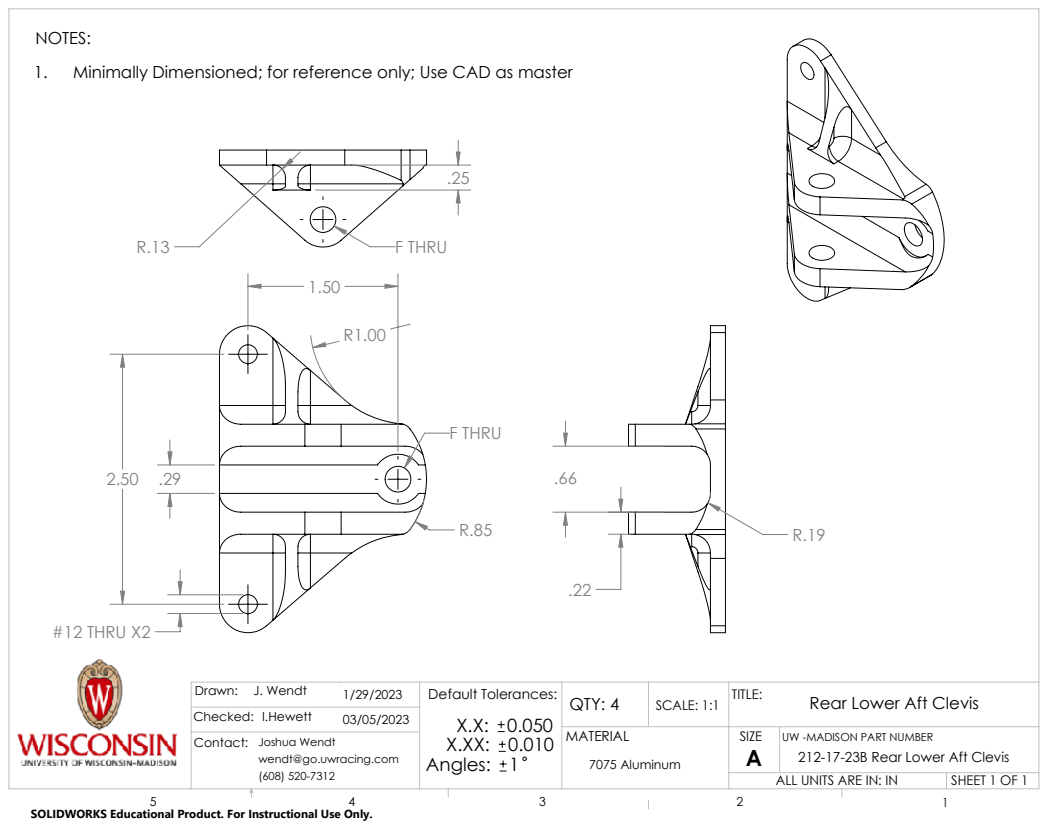
[picture p93: page 1]
F THRU; #12 THRU X2; SHEET 1 OF 1; SCALE: 1:1; 7075 Aluminum; QTY: 4; J. Wendt; Checked: I.Hewett; Default Tolerances:; Angles:; 1 wendt@go.uwracing.com

NOTES:
1. Minimally Dimensioned; for reference only; Use CAD as master

Drawn:
Contact: Joshua Wendt

TITLE:
212-17-23B Rear Lower Aft Clevis
ALL UNITS ARE IN: IN

Rear Lower Aft Clevis

SIZE
UW -MADISON PART NUMBER

SOLIDWORKS Educational Product. For Instructional Use Only.
