Lileigh/Active-CAD/200 - Chassis/220 - Actuation/221 - Front Actuation/221-05-23 Bellcrank Half.pdf

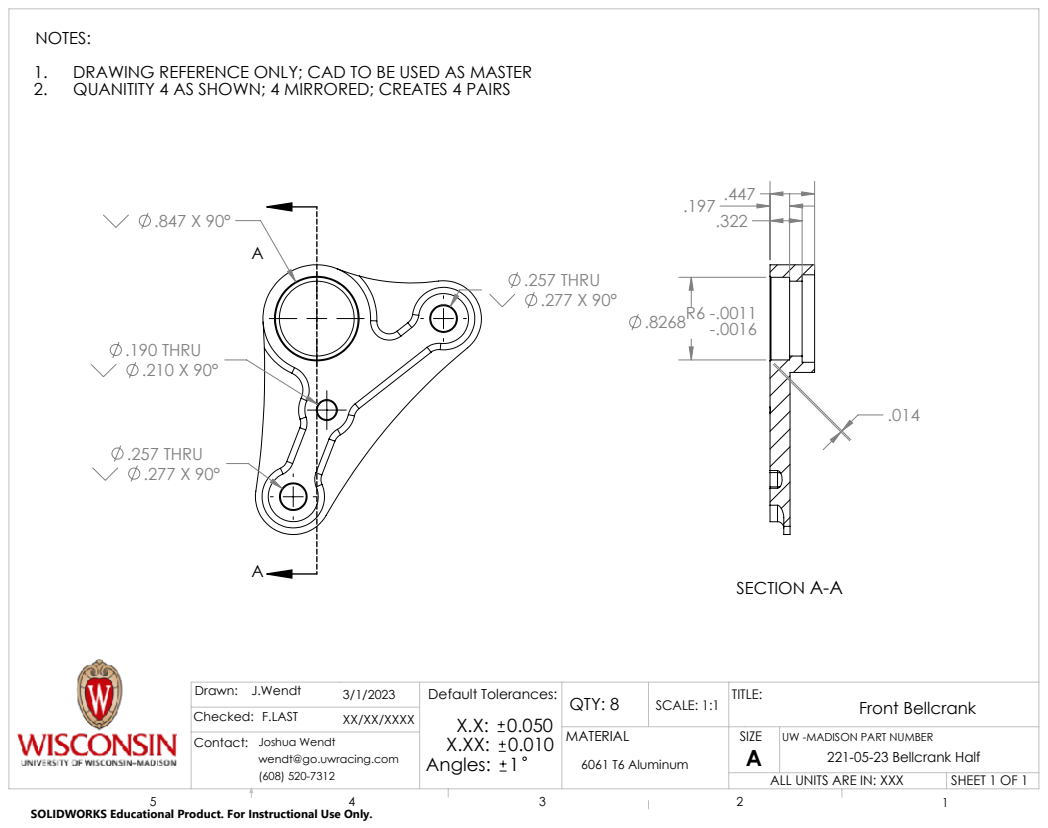
[picture p94: page 1]
.257 THRU .277 X 90°; .190 THRU .210 X 90°; SECTION A-A; SHEET 1 OF 1; SCALE: 1:1; 6061 T6 Aluminum; QTY: 8; Front Bellcrank; Checked: F.LAST; XX/XX/XXXX; Default Tolerances:; Angles:; 1 wendt@go.uwracing.com

NOTES:
1. DRAWING REFERENCE ONLY; CAD TO BE USED AS MASTER
2. QUANITITY 4 AS SHOWN; 4 MIRRORED; CREATES 4 PAIRS

Drawn:
Contact: Joshua Wendt

TITLE:
ALL UNITS ARE IN: XXX

SIZE
UW -MADISON PART NUMBER
221-05-23 Bellcrank Half

SOLIDWORKS Educational Product. For Instructional Use Only.
