Lileigh/Active-CAD/200 - Chassis/220 - Actuation/222 - Rear Actuation/222-07-23 Bellcrank Half.pdf

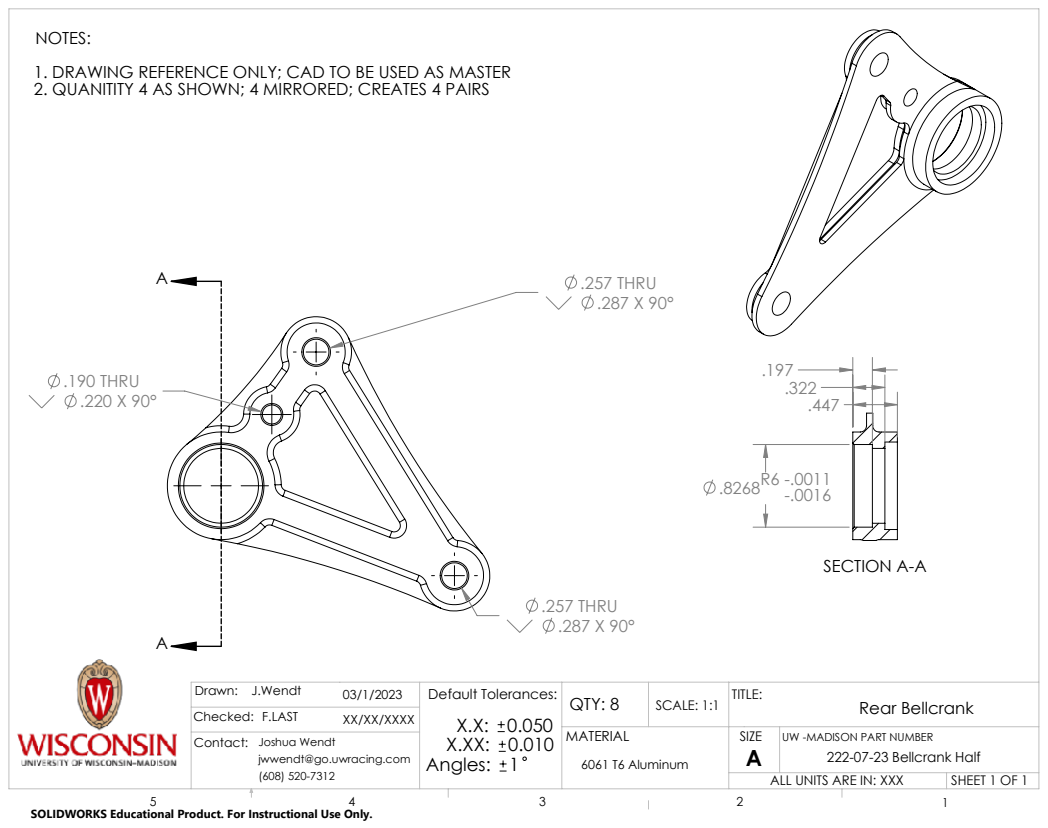
[picture p95: page 1]
.257 THRU .287 X 90°; .190 THRU .220 X 90°; SECTION A-A; SHEET 1 OF 1; SCALE: 1:1; 6061 T6 Aluminum; QTY: 8; Rear Bellcrank; Checked: F.LAST; XX/XX/XXXX; Default Tolerances:; Angles:; 1 jwwendt@go.uwracing.com

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

Drawn:
Contact: Joshua Wendt

TITLE:
ALL UNITS ARE IN: XXX

SIZE
UW -MADISON PART NUMBER
222-07-23 Bellcrank Half

SOLIDWORKS Educational Product. For Instructional Use Only.
