Lileigh/Active-CAD/400 - E Drivetrain/410 - Motor/Drawings/223e-410-18 Modified Rear Endcap.pdf

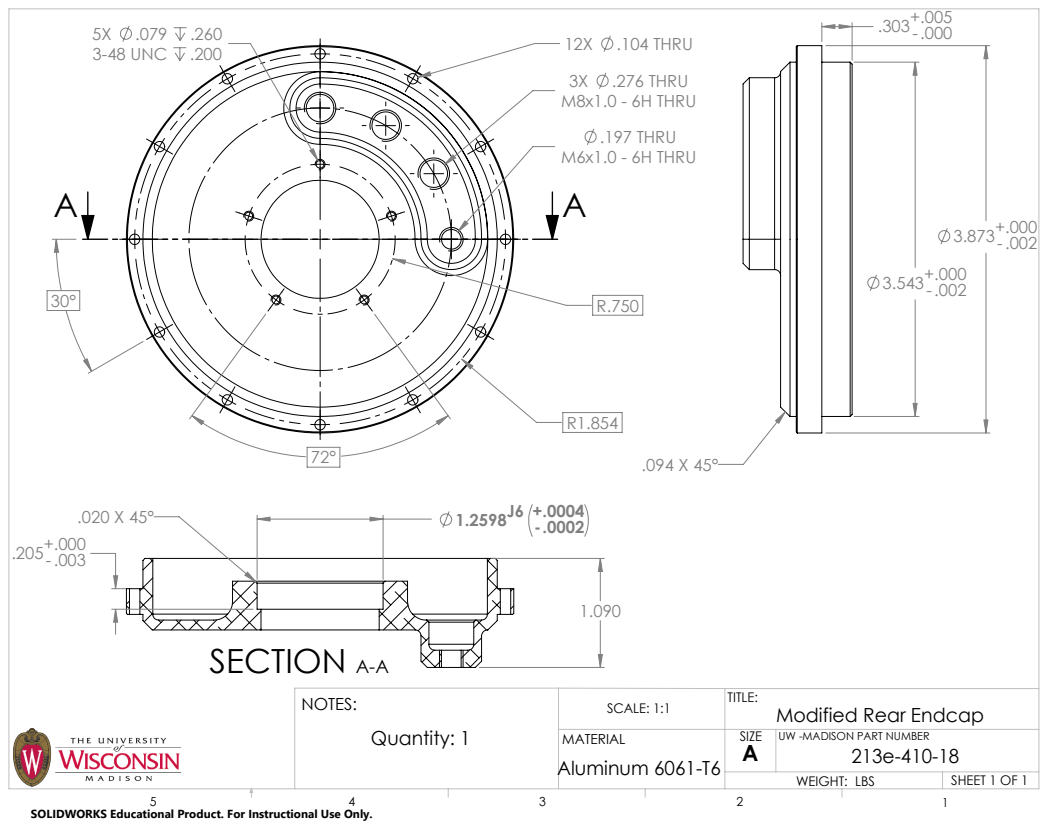
[picture p96: page 1]
12X .104 THRU; 3X .276 THRU M8x1.0 - 6H THRU; .197 THRU M6x1.0 - 6H THRU; 5X .079 .260 3-48 UNC .200; SECTION A-A; SHEET 1 OF 1; SCALE: 1:1; WEIGHT: LBS; NOTES:; Modified Rear Endcap; Aluminum 6061-T6; Quantity: 1

SIZE
UW -MADISON PART NUMBER

SOLIDWORKS Educational Product. For Instructional Use Only.
