Lileigh/Active-CAD/400 - E Drivetrain/410 - Motor/Drawings/223e-410-19 Modified Front Endcap.pdf

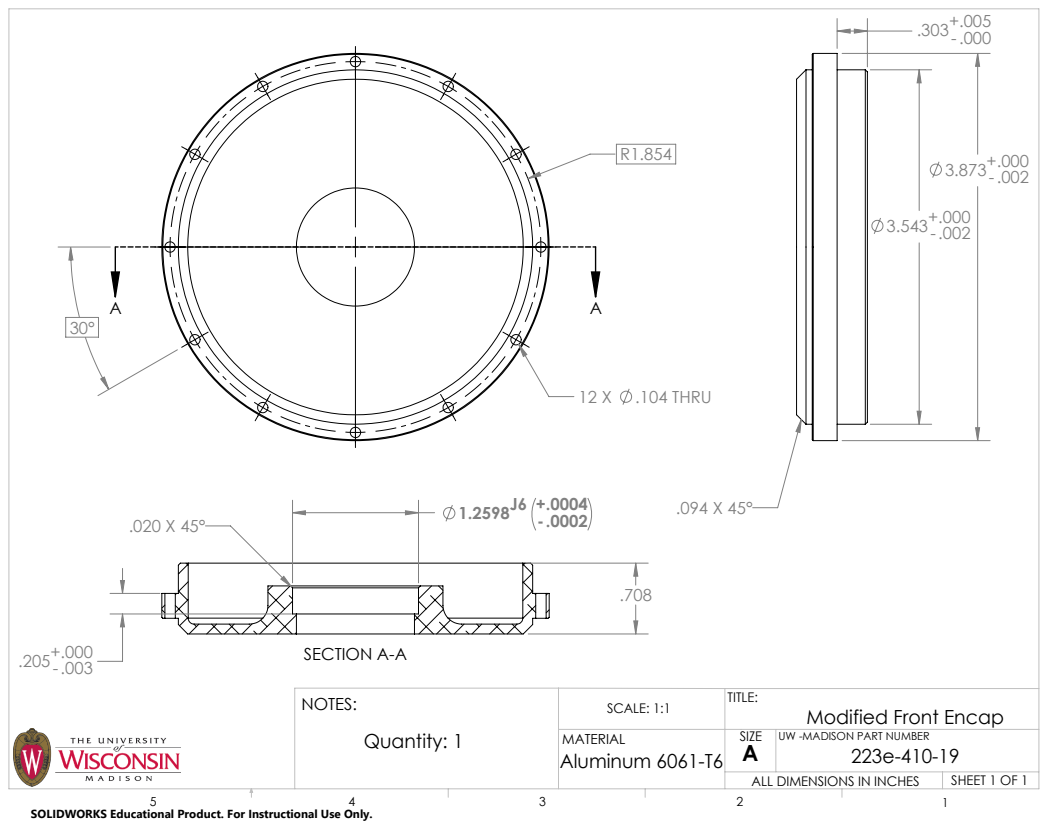
[picture p97: page 1]
12 X .104 THRU; SECTION A-A; SHEET 1 OF 1; SCALE: 1:1; NOTES:; Modified Front Encap; Aluminum 6061-T6; Quantity: 1

SIZE
UW -MADISON PART NUMBER

ALL DIMENSIONS IN INCHES

SOLIDWORKS Educational Product. For Instructional Use Only.
