Lileigh/Active-CAD/400 - E Drivetrain/410 - Motor/Drawings/220e-310-06 Endcap (Back).PDF

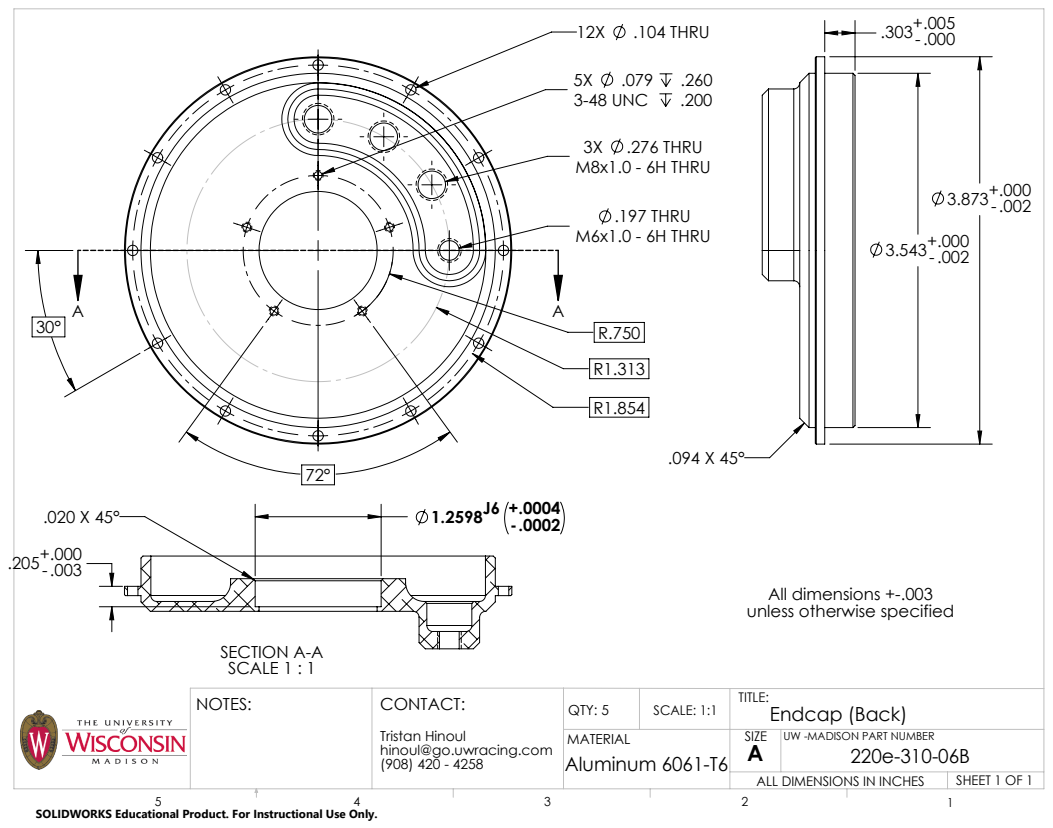
[picture p98: page 1]
3-48 UNC; 3X .276 THRU M8x1.0 - 6H THRU; .197 THRU M6x1.0 - 6H THRU; .104 THRU; SECTION A-A SCALE 1 : 1; SHEET 1 OF 1; SCALE: 1:1; NOTES:; QTY: 5; Endcap (Back); Aluminum 6061-T6

All dimensions +-.003
unless otherwise specified

CONTACT:
Tristan Hinoul
hinoul@go.uwracing.com

SIZE
UW -MADISON PART NUMBER

ALL DIMENSIONS IN INCHES

SOLIDWORKS Educational Product. For Instructional Use Only.
