Lileigh/Active-CAD/(commit log)

2021-12-24 Active cad
    [0.38in Mold Insert.SLDDRW, 0.38in Mold Insert.SLDPRT, 0.5in Mold Insert.SLDDRW, 0.5in Mold Insert.SLDPRT, 1 Inch Square Stock.SLDPRT, 127-219-04 inboard AN5 A-Arm Jig.SLDPRT, 19IN HALF SHAFT D5160.SLDPRT, 200-690-01 Bracket.SLDPRT]
2021-12-28 Gitignore and control arms progress
    [Control Arm Naming Guide.xlsx]
2021-12-28 Update Control Arm Naming Guide.xlsx
    [Control Arm Naming Guide.xlsx]
2021-12-30 Kin update for front actuation, chassis stuff
    [211-00-22-A.SLDASM, 211-09-22-A.SLDPRT, 211-09-22-B.SLDPRT, 211-11-22-A.SLDPRT, Control Arm Naming Guide.xlsx, KIN-01-22-A.SLDPRT]
2021-12-31 Minor kin change and front suspension outboard chassis parts finished
    [211-00-22-A.SLDASM, 211-09-22-B.SLDPRT, 211-0915-FEM.SLDPRT, 211-15-22-A.SLDPRT, Control Arm Naming Guide.xlsx, KIN-01-22-A.SLDPRT]
2022-01-13 Control arm progress
    [210-01-17-B.SLDPRT, 210-05-17-A.SLDPRT, 211-00-22-A.SLDASM, 211-01-22-A.SLDPRT, 211-03-22-A.SLDPRT, 211-05-22-A.SLDPRT, 211-07-22-A.SLDPRT, 211-09-22-A REF.SLDPRT]
2022-01-16 R Upper OB spherical plate
    [212-09-22-A.SLDPRT, 212-0913-FEM.SLDPRT]
2022-01-16 Control arm updates
    [211-00-22-A.SLDASM, 211-0913-FEM.SLDPRT, 211-13-22-A.SLDPRT, 212-0913-FEM.SLDPRT, 212-13-22-A.SLDPRT, Control Arm Naming Guide.xlsx]
2022-01-16 Undid kin change this week
    [KIN-01-22-A.SLDPRT]
2022-01-17 Fixed filler neck for ses
    [220-320-00.SLDASM, 220-320-10 FillerNeck.SLDPRT]
2022-01-18 adding tabs for rear engine mounts
    [310-09c-22A.SLDPRT, 310-17c-22A.SLDPRT]
2022-01-18 Adding bearing blocks
    [310-09-22A.SLDPRT, 310-17-22A.SLDPRT, 335-01-22A.SLDPRT, 335-02-22A.SLDPRT, New Bearing Block LHS.SLDPRT, New Bearing Block RHS.SLDPRT]
2022-01-18 fixed filler neck
    [220-320-00.SLDASM, 220-320-10 FillerNeck.SLDPRT]
2022-01-19 Renaming of files
    [240-19-22-A.SLDPRT, 240-21-22-A.SLDPRT, 240-21-22-B.SLDPRT]
2022-01-19 Duplicate assembly in cad workshop
    [241-00-22-A.SLDASM]
2022-01-19 Updating Part Numbers
    [217-331-00 (1).sldasm, 217-333-01.SLDPRT, 218-332-05 Front Sprocket.SLDPRT, 218-332-05.SLDPRT, 219-332-04 (Rear Sprocket).SLDPRT, 219-332-04.DXF, 219-332-05 Swappable Rear Sprocket Hub Correct.SLDPRT, 220-330-00.sldasm]
2022-01-19 Updated Part Numbers
    [217-331-00 (1).sldasm, 220-330-00.sldasm, 331-11-20A.SLDPRT, 331-12-20A.SLDPRT, 331-13-20A.SLDPRT, 331-22-20A.SLDPRT, 331-24-20A.SLDPRT, 331-25-20A.SLDPRT]
2022-01-20 Control Arm Geometry Updates
    [210-03-17-A.SLDPRT, 211-09-22-B.SLDPRT, 212-00-22-A.SLDASM, 212-01-22-A.SLDPRT, 212-03-22-A.SLDPRT, 212-09-22-B.SLDPRT, 212-09B13-FEM.SLDPRT, 212-13-22-A.SLDPRT]
2022-01-20 Chassis parts and dxfs
    [210-01-17-B.DXF, 211-00-22-A.SLDASM, 211-01-22-A.SLDPRT, 211-03-22-A.SLDPRT, 211-05-22-A.SLDPRT, 211-07-22-A.SLDPRT, 211-09-22-B.DXF, 211-09-22-B.SLDPRT]
2022-01-21 Added engine mounts
    [310-03-22A.SLDPRT, 310-15-22A.SLDPRT]
2022-01-21 Unified Lower Spherical Plate
    And the Unified Lower Spherical Plate said to the LORD, "Am I good, Lord?" And the LORD said to the Plate, "Thou art good."
    [210-11-22-A.SLDPRT, 211-00-22-A.SLDASM, 212-00-22-A.SLDASM, 4130 0.125 Single Part.SLDPRT, 4130 0.125 Waterjet Profile.DXF, 4130 0.125.SLDASM, 4130 0.25.SLDASM]
2022-01-21 Added Turbo cad
    [340-00-20A.SLDASM, 340-001-20A Right Side Turbo Support.sldprt, 340-01-20A Dyno.SLDASM, 340-04-20A.sldprt, 340-05-20A.SLDPRT, 340-06-20A.SLDPRT, 340-07-20A.SLDPRT]
2022-01-21 Added intake files
    [218-352-01 Jig ass.SLDASM, 220-352-70-MAP BUNG.SLDDRW, 350-00-20A.SLDASM, 350-01-20A Dyno.SLDASM, 351-03-20A PreTurbo Bend.SLDPRT, 351-04-20A Silicone Coupler 2 In.SLDPRT, 352-00-20A Post Throttle Intake.sldasm, 352-01-18A JIG.SLDPRT]
2022-01-21 4130 0.25
    [150-001-22-A AI Plate.DXF, 222e-150-001 AI Plate.DXF, 4130 0.25 Single Part.SLDPRT, 4130 0.25 Waterjet Profile.DXF, 4130 0.25.SLDASM]
2022-01-21 Updated Bearing Blocks
    [335-01-20A.sldprt, 335-01-22A.SLDPRT, 335-02-20A.sldprt, 335-02-22A.SLDPRT]
2022-01-21 Some Cooling adds
    [0.375 nipple.SLDDRW, 0.375 nipple.SLDPRT, 218-370-00.SLDDRW, 219-378-00.sldasm, 219-378-01.SLDDRW, 219-378-01.SLDPRT, 219-378-02.SLDDRW, 219-378-02.SLDPRT]
2022-01-21 updated assembly
    [310-00-22-A(P-Train Assembly).SLDASM]
2022-01-22 New jackbar tabs
    [220-330-00.sldasm, Jackbar Tabs.SLDPRT]
2022-01-22 part names
    [336-03-22A.SLDPRT]
2022-01-22 More waterjet profiles
    [4130 0.1 Single Part.SLDPRT, 4130 0.1 Waterjet Profile.DXF, 4130 0.1.SLDASM, 4130 0.125.SLDASM, 5052 0.063 Single Part.SLDPRT, 5052 0.063 Waterjet Profile.DXF, 5052 0.063.SLDASM, 5052 0.125.SLDASM]
2022-01-22 Finished 5052
    [5052 0.125 Single Part.SLDPRT, 5052 0.125 Waterjet Profile.DXF, 5052 0.125.SLDASM]
2022-01-22 Added DXFs of uprights
    [241-03-22-A.DXF, 241-04-22-A.DXF, 242-03-22-A.DXF, 242-04-22-A.DXF]
2022-01-22 Front Suspension Jig
    [210-00-22-A.SLDASM, 210-01-17-B.SLDPRT, 211-00-22-A.SLDASM, 211-09-22-B.SLDPRT, 211-13-22-A.SLDPRT, JIG-210-01-19-B.SLDPRT, JIG-210-03-19-B.SLDPRT, JIG-210-05-22-A.SLDPRT]
2022-01-22 Steering Assembly Updates
    [10mm ID Angular Contact Bearing.SLDPRT, 15mm ID Angular Contact Bearing.SLDPRT, 270-00-22-A.SLDASM, 272-00-21-A.SLDASM, 272-03-20-A.SLDPRT, 272-03-21-A.SLDPRT, 272-07-21-A.SLDPRT, 272-08-21-A.SLDPRT]
2022-01-22 Replaced with new DXF files
    [241-03-22-A.DXF, 241-04-22-A.DXF, 242-03-22-A.DXF, 242-04-22-A.DXF]
2022-01-23 Jigs finished for control arms
    [212-15-20-B.SLDPRT, JIG-210-01-19-B.SLDPRT, JIG-210-03-19-B.SLDPRT, JIG-210-05-22-A.SLDPRT, JIG-210-07-22-A.SLDPRT, JIG-211-00-22-A.SLDASM, JIG-211-01-22-A.SLDPRT, JIG-211-03-22-A.SLDPRT]
2022-01-23 Started work on actuation naming
    [Actuation Naming Guide.xlsx, KIN-01-22-A.SLDPRT]
2022-01-23 Just made some mold insert drawings
    [0.19in Double Mold Insert.SLDDRW, 0.19in Double Mold Insert.SLDPRT, 0.25in Mold Insert.SLDDRW, 0.25in Mold Insert.SLDPRT, 0.31in Mold Insert.SLDDRW, 0.31in Mold Insert.SLDPRT, 0.38in Mold Insert.SLDDRW]
2022-01-23 Fixed Assemblies
    [220-330-00.sldasm, 310-00-22-A(P-Train Assembly).SLDASM, 310-01-14-A.SLDPRT]
2022-01-24 Actuation Rods
    [223-00-FT-22-A.SLDASM, 223-00-P-22-A.SLDASM, 223-00-RT-22-A.SLDASM, 223-01-22-A.SLDPRT, 223-03-22-A.SLDPRT, 223-05-22-A.SLDPRT, 223-07-22-A.SLDPRT, 223-09-17-B.SLDPRT]
2022-01-24 Started full actuation assembly
    [220-00-22-A.SLDASM, 223-00-P-22-A.SLDASM, 223-03-22-A.SLDPRT]
2022-01-24 Created full corners assembly
    [240-00-22-A.SLDASM, 240-05-22-A.SLDPRT, 240-07-22-A.SLDPRT, 240-09-22-A.SLDPRT, 241-01-22-B.SLDPRT, 241-03-22-A.SLDPRT, 241-05-22-B.SLDPRT, 241-15-22-A.SLDPRT]
2022-01-24 Fixed assembly
    [240-00-22-A.SLDASM, 242-03-22-A.SLDPRT]
2022-01-24 Added in part drawings
    [241-01-22-B.SLDDRW, 241-03-22-A.SLDDRW, 241-04-22-A.SLDDRW, 242-01-22-B.SLDDRW, 242-03-22-A.SLDDRW, 242-04-22-A.SLDDRW]
2022-01-25 added jd laser parts
    [280-011-22-A Harness Bar.SLDPRT, 280-013-22-A Main Hoop Brace Right.SLDPRT, 280-014-22-A Main Hoop Brace Left.SLDPRT, 280-015-22-A Main Hoop Brace Attachment Tube.SLDPRT]
2022-01-25 updated the part numbers and such
    [WR Tube Request 2022.xlsx]
2022-01-25 Add caliper and master cylinders
    [250-01-20-A.SLDASM, 250-03-20-A.SLDASM, 250-05-20-A.SLDPRT]
2022-01-25 Created subassemblies for full corners assembly
    [240-00-22-A.SLDASM, 241-00-22-A.SLDASM, 241-01-22-B.SLDPRT, 241-03-22-A.SLDPRT, 241-05-22-B.SLDPRT, 241-11-22-A.SLDPRT, 241-15-22-A.SLDPRT, 242-00-22-A.SLDASM]
2022-01-27 Electronics and Brake Hat
    [220-223-02 2020 Brake Hat Drawing for Consultation.SLDDRW, 220e-429-00 ECU_Assembly.SLDASM, 220e-429-01 32_Position_Cover.SLDPRT, 220e-429-02 48_Position_Cover.SLDPRT, 220e-429-04 PCM_112.SLDPRT, 220e-429-05 32pin_Connector.SLDPRT, 220e-429-06 48pin_Connector.SLDPRT, 700-01.SLDPRT]
2022-01-27 DXF reissued
    [210-01-17-B.SLDPRT, 210-11-22-A.SLDPRT, 211-09-22-B.SLDPRT, 212-09-22-B.SLDPRT, 4130 0.125 Waterjet Profile.DXF, 4130 0.25 Single Part.SLDPRT, 4130 0.25 Waterjet Profile.DXF, 4130 0.25.SLDASM]
2022-01-28 Updated exhaust system
    [360-00-22-A.SLDASM, 362-00-20-A.SLDASM, 362-05-20-A.SLDPRT, 362-07-20-A.SLDPRT, 362-09-20-A.SLDPRT, 362-11-20-A.SLDPRT, 362-13-20-A.SLDPRT, 363-01-22 A.SLDPRT]
2022-01-30 Fixes to DXFs from a few days ago
    [210-01-17-B.SLDPRT, 210-11-22-A.SLDPRT, 211-09-22-B.SLDPRT, 211-13-22-A.SLDPRT, 212-09-22-B.SLDPRT, 212-13-22-A.SLDPRT, 4130 0.125 Single Part.SLDPRT, 4130 0.125 Waterjet Profile.DXF]
2022-01-31 Jig drawings
    [223-09-17-B.SLDDRW, 223-09-17-B.SLDPRT, 223-11-17-B.SLDDRW, 223-11-17-B.SLDPRT, 223-12-17-B.SLDDRW, 223-13-17-B.SLDDRW, 223-13-17-B.SLDPRT, 223-14-17-B.SLDDRW]
2022-02-01 Quick fix to muffler baffles
    [360-00-22-A.SLDASM, 362-00-20-A.SLDASM, 362-07-20-A.SLDPRT, 362-11-20-A.SLDPRT]
2022-02-01 Full Chassis Assembly and associated fixes
    [200-000-22-A.SLDASM, 210-00-22-A.SLDASM, 210-11-22-A.SLDPRT, 211-00-22-A.SLDASM, 211-09-22-B.SLDPRT, 211-13-22-A.SLDPRT, 212-00-22-A.SLDASM, 220-00-22-A.SLDASM]
2022-02-02 Created wheel assembly
    [240-01-22-A.SLDASM]
2022-02-02 Added tires to assembly
    [240-01-22-A.SLDASM, 240-03-22-A.SLDPRT]
2022-02-02 Removed old pedal stuff
    [219-230-16 Overtravel Switch.SLDPRT, 219-231-04 Throttle Bearing.SLDPRT, 220-231-01 Throttle Pedal.SLDPRT, 220-231-02 Throttle Retaining Ring.SLDPRT, 220-231-03 Throttle Spring Mount Tube.SLDPRT, 220-231-04 Accelerator Pedal Stop Bar.sldprt, 220-231-05 APS Pivot Arm.sldprt, 220-231-06 Throttle AN4 Spacer.SLDPRT]
2022-02-02 Fixed some wheel stuff
    [240-00-22-A.SLDASM, 240-01-22-A.SLDASM, 240-05-22-A.SLDPRT, 240-07-22-A.SLDPRT, 240-09-22-A.SLDDRW, 240-09-22-A.SLDPRT, 240-09-22-B.SLDDRW, 245-00-22-A.SLDASM]
2022-02-02 Added active cad
    also updated part numbers
    [220-01-22-A.SLDPRT, 220-03-22-A.SLDPRT, 221-01-22-A.SLDPRT, 221-02-22-A.SLDPRT, 221-03-22-A.SLDPRT, 221-04-22-A.SLDPRT, 221-05-22-A.SLDPRT, 221-07-22-A.SLDPRT]
2022-02-03 modified air tank mount
    [tank mount.SLDPRT, tank side mount.SLDPRT]
2022-02-03 Structures Folder
    [0.19in Double Mold Insert.SLDDRW, 0.19in Double Mold Insert.SLDPRT, 0.25in Mold Insert.SLDDRW, 0.25in Mold Insert.SLDPRT, 0.31in Mold Insert.SLDDRW, 0.31in Mold Insert.SLDPRT, 0.38in Mold Insert.SLDDRW, 0.38in Mold Insert.SLDPRT]
2022-02-03 Renamed a part
    [282-00-22-A.SLDASM, 282-05-22-A AI Backing Plate.SLDPRT, 282-05-22-A.SLDPRT]
2022-02-03 More Structures work
    [281-03-22-A Main Hoop Mount.SLDDRW, 281-03-22-A Main Hoop Mount.SLDPRT, 281-03-22-A.SLDPRT, 281-05-22-A MH Mount Backing Plate.SLDPRT, 281-05-22-A.SLDPRT]
2022-02-03 Full chassis assem updates
    [200-000-22-A.SLDASM, 240-00-22-A.SLDASM, 280-00-22-A.SLDASM, 281-00-22-A.SLDASM, 282-00-22-A.SLDASM]
2022-02-04 Adding assemblies
    [220-01-22-A.SLDPRT, 221-05-22-A.SLDPRT, 221-07-22-A.SLDPRT, 222-05-22-A.SLDPRT, 222-07-22-A.SLDPRT, R Fore Rotary Bellcrank.SLDASM]
2022-02-04 More assemblies
    [222-05-22-A.SLDPRT, 222-07-22-A.SLDPRT, L Aft Rotary Bellcrank.SLDASM, L Fore Rotary Bellcrank.SLDASM, R Aft Rotary Bellcrank.SLDASM, R Fore Rotary Bellcrank.SLDASM]
2022-02-04 all the assembly updates
    [220-00-22-A.SLDASM, 221-01-22-A.SLDPRT, 221-02-22-A.SLDPRT, 221-05-22-A.SLDPRT, 221-07-22-A.SLDPRT, 222-02-22-A.SLDPRT, 222-03-22-A.SLDPRT, 222-04-22-A.SLDPRT]
2022-02-04 assembly update
    [220-00-22-A.SLDASM, 222-02-22-A.SLDPRT]
2022-02-04 Actuation partial merge and AI plate fix
    [220-01-22-A.SLDPRT, 220-03-22-A.SLDPRT, 221-00-22-A.SLDASM, 221-01-22-A.SLDPRT, 221-02-22-A.SLDPRT, 221-03-22-A.SLDPRT, 221-04-22-A.SLDPRT, 221-05-22-A.SLDPRT]
2022-02-07 Fixed too thin suspension plate features
    [210-11-22-A.SLDPRT, 211-09-22-B.SLDPRT, 212-09-22-B.SLDPRT, 4130 0.25 Single Part.SLDPRT, 4130 0.25 Waterjet Profile Thickened.DXF, 4130 0.25.SLDASM]
2022-02-08 Added jigging
    [Fore Jig Assembly.SLDASM, L Aft Heave.SLDPRT, L Aft Roll.SLDPRT, L Aft Rotary Bellcrank.SLDASM, L Fore Heave.SLDPRT, L Fore Rotary Bellcrank.SLDASM, L+R Fore Roll.SLDPRT, R Aft Heave.SLDPRT]
2022-02-08 more jigging updates
    [Actuation Jigging Assembly.SLDASM, Fore Jig Assembly.SLDASM, R Fore Heave.SLDPRT, jigPlate.SLDPRT]
2022-02-10 Clevis FEA and drawing
    [210-03-17-A.SLDDRW, 210-03-17-A.SLDPRT]
2022-02-11 Upload Drawing
    [273-15-20-A.SLDDRW]
2022-02-11 Ptrain bent drawings
    [310-09-22A.SLDDRW, 310-13-22A.SLDDRW, 310-17-22A.SLDDRW, 310-17-22A.SLDPRT, 321-01-20-A.SLDPRT, 321-01-20A.SLDDRW, 321-03-20-A.SLDPRT, 321-03-20A.SLDDRW]
2022-02-11 Shifting parts moved to active
    [380-00-22-B.SLDASM, 381-00-22-B.SLDASM, 381-01-22-A.SLDDRW, 381-01-22-A.SLDPRT, 381-03-22-A.SLDDRW, 381-03-22-A.SLDPRT, 381-05-22-A.SLDDRW, 381-05-22-A.SLDPRT]
2022-02-12 More shifting cleanup
    [Bushing.sldprt, Clevis Pin.SLDPRT, Cylinder.SLDASM, FullAssem.SLDASM, Grainger-49J635.SLDASM, Mount.SLDPRT, MountAssem.SLDASM, Rod End.sldprt]
2022-02-13 Brought the header back
    [340-00-20A.SLDASM, 342-001-20A.SLDPRT]
2022-02-15 Redone jigging
    [Actuation Jigging Assembly.SLDASM, L Aft Heave.SLDPRT, L Aft Roll.SLDPRT, L Aft Rotary Bellcrank.SLDASM, L Fore Heave.SLDPRT, L Fore Rotary Bellcrank.SLDASM, L Heave Mount.SLDPRT, L Roll Mount.SLDPRT]
2022-02-15 Bent drawings
    [212-15-20-B.SLDDRW, 212-15-20-B.SLDPRT, 272-07-21-A.SLDPRT, 272-07-22-A.SLDDRW, 272-08-22-A.SLDDRW, 272-13-22-A.SLDDRW, 272-13-22-A.SLDPRT, 281-03-22-A.SLDDRW]
2022-02-16 Workshop items
    [250-00-22-A.SLDASM, 250-07-22-A.SLDPRT, 250-09-22-A.SLDPRT]
2022-02-17 Waterjet stuff
    [210-03-17-A.SLDDRW, 221-02-22-A.SLDPRT, 221-04-22-A.SLDPRT, 222-02-22-A.SLDPRT, 5052 0.063 Single Part.SLDDRW, 5052 0.063 Single Part.SLDPRT, 5052 0.063 Waterjet Profile.DXF, 5052 0.063.SLDASM]
2022-02-17 Fixed missing dimension
    [241-03-22-A.SLDPRT, 242-03-22-A.SLDPRT]
2022-02-17 Changed tab bolt hole sizing
    [221-05-22-A.SLDPRT, 221-07-22-A.SLDPRT, 222-05-22-A.SLDPRT, 222-07-22-A.SLDPRT]
2022-02-17 Updated to fit tabs
    [221-05-22-A.SLDPRT, 221-07-22-A.SLDPRT, 222-05-22-A.SLDPRT, 222-07-22-A.SLDPRT, L Aft Rotary Bellcrank.SLDASM, L Fore Rotary Bellcrank.SLDASM, L Heave Mount.SLDPRT, L Roll Mount.SLDPRT]
2022-02-18 ecar busbars drawings added
    [220e-450-009 - busbar 1 V2.SLDDRW, 220e-450-011 - busbar 2.SLDDRW, 220e-450-013 - busbar 3 V2.SLDDRW, 220e-450-015 - busbar 4 V2.SLDDRW, 220e-450-017 - busbar 5.SLDDRW, 220e-450-019 - busbar 6 .SLDDRW, 220e-450-021 - DC Link Positive .SLDDRW, 220e-450-023 - DC Link Negative.SLDDRW]
2022-02-18 Corner Renaming and Organization
    [210-03-17-A.SLDPRT, 240-00-22-A.SLDASM, 240-03-22-A.SLDPRT, 240-17-22-A.SLDPRT, 240-19-22-A.SLDPRT, 241-00-22-A.SLDASM, 241-01-22-B.SLDPRT, 241-03-22-A.SLDPRT]
2022-02-19 Pedals -- Throttle Side
    [261-00-22A.SLDASM, 261-01-15A.SLDPRT, 261-03-22A.sldprt, 261-05-22A.SLDPRT, 261-07-22B.SLDPRT, 261-09-22B.SLDPRT, 261-11-22A.SLDPRT, 261-13-22A.SLDPRT]
2022-02-19 Brake pedal stuff
    [-02 Hose to -03 STR EXT Neck Banjo Body.SLDPRT, 262-00-22A.SLDASM, 262-01-22A.SLDPRT, 262-03-22A.SLDPRT, 262-04-22A.SLDPRT, 262-05-22A.SLDPRT, BOLT-AN5.SLDPRT, BOLT-AN6.SLDPRT]
2022-02-22 just modified mold insert drawing
    [0.5in Mold Insert.SLDDRW, 0.5in Mold Insert.SLDPRT]
2022-02-22 Create Solenoid Box.SLDPRT
    Solenoid Box creation
    [Solenoid Box.SLDPRT]
2022-03-03 Clevis and Kin Change
    [210-03-22A.SLDPRT, 240-01-17-B.SLDPRT, KIN-01-22-A.SLDPRT]
2022-03-03 Created jig drawings
    [L Heave Mount.SLDDRW, L Roll Mount.SLDDRW, R Heave Mount.SLDDRW, R Roll Mount.SLDDRW, sideMount.SLDDRW]
2022-03-03 Clevis and shim updates
    [210-03-17-A.SLDPRT, 210-03-22A.SLDPRT, 210-05-22B.SLDPRT, 210-11-22-A.SLDPRT, 240-01-17-B.SLDPRT, 240-03-17B.SLDPRT, Control Arm Naming Guide.xlsx]
2022-03-03 Insert Part Drawings
    [272-03-21-A.SLDDRW, 272-09-20-A.SLDDRW, 273-05-20-A.SLDDRW]
2022-03-06 Pedals finally finished
    [260-00-22A.SLDASM, 261-00-22A.SLDASM, 261-03-22A.sldprt, 261-05-22A.SLDPRT, 261-05-22B.SLDPRT, 261-07-22B.SLDPRT, 261-09-22A.SLDPRT, 261-09-22B.SLDPRT]
2022-03-06 Fixed a bunch of brake stuff
    [-02 Hose to -03 STR EXT Neck Banjo Body.SLDPRT, 240-00-22-A.SLDASM, 241-00-22-A.SLDASM, 242-00-22-A.SLDASM, 250-00-22-A.SLDASM, 250-01-20-A.SLDASM, 250-03-20-A.SLDASM, 250-07-22-A.SLDPRT]
2022-03-06 Some minor cleanup and updates, plus FL clevis and spacers
    [200-000-22-A.SLDASM, 211-15-15B.SLDPRT, 211-17-22A.SLDPRT, 240-00-22-A.SLDASM, 241-00-22-A.SLDASM, 242-00-22-A.SLDASM, 260-00-22A.SLDASM, 261-00-22A.SLDASM]
2022-03-06 Reorganization, adding clevises and brakes to main assemblies
    [200-000-22-A.SLDASM, 210-00-22-A.SLDASM, 210-03-22A.SLDPRT, 210-05-22B.SLDPRT, 211-00-22-A.SLDASM, 211-00-22A.SLDASM, 211-01-22-A.SLDPRT, 211-03-22-A.SLDPRT]
2022-03-07 Assembly + Part updates
    1" Tube, modified tabs, adjusted mount width
    [220-00-22-A.SLDASM, 220-01-22-A.SLDPRT, 220-01-22-B.SLDPRT, 220-03-22-A.SLDPRT, 221-00-22-A.SLDASM, 221-03-22-A.SLDPRT, 221-05-22-A.SLDPRT, 221-07-22-A.SLDPRT]
2022-03-07 Actuation updates
    [220-00-22-A.SLDASM, 220-01-22-B.SLDPRT, 220-03-22-A.SLDPRT, 221-01-22-A.SLDPRT, 222-01-22-A.SLDPRT, 222-02-22-A.SLDPRT, 222-03-22-A.SLDPRT, 222-04-22-A.SLDPRT]
2022-03-07 Wholesale naming changes and minor adjustments to assemblies and clevises
    [223-00-FT-22-A.SLDASM, 223-00-FT-22A.SLDASM, 223-00-P-22-A.SLDASM, 223-00-RT-22-A.SLDASM, 223-00-RT-22A.SLDASM, 223-07-22-A.SLDPRT, 223-07-22A.SLDPRT, 223-13-17-B.SLDDRW]
2022-03-07 Antiroll Active CAD Update
    3-7-22
    [230-00-22-A.SLDASM, 230-01-22-A.SLDPRT, 230-03-22-A.SLDPRT, 230-05-22-A.SLDPRT, 230-07-22-A.SLDPRT, 230-09-22-A.SLDPRT, 230-11-22-A.SLDPRT, BOLT-AN5.SLDPRT]
2022-03-08 Fixes and updates plus actuation mfg
    [210-03-22A.SLDPRT, 210-05-22B.SLDPRT, 211-00-22A.SLDASM, 212-00-22-A.SLDASM, 212-01-22-A.SLDPRT, 212-03-22-A.SLDPRT, 212-05-22-A.SLDPRT, 212-07-22-A.SLDPRT]
2022-03-08 change to MHM to bend in BSE
    [280-01-22-B.SLDPRT, 281-03-22-A Main Hoop Mount.DXF, 281-03-22-A Main Hoop Mount.SLDDRW, 281-03-22-A.SLDPRT]
2022-03-08 Added pdfs
    [L Heave Mount.SLDDRW, L Roll Mount.SLDDRW, R Heave Mount.SLDDRW, sideMount.SLDDRW]
2022-03-09 Quick fixes
    Noticed clearance issue between mount and cutout, adjusted tube length, adjusted jig plate to match (only affects the plate holes, non of the mounts)
    [220-00-22-A.SLDASM, 220-01-22-B.SLDPRT, 221-01-22-A.SLDPRT, 221-03-22-A.SLDPRT, 222-01-22-A.SLDPRT, 222-02-22-A.SLDPRT, 222-03-22-A.SLDPRT, 222-04-22-A.SLDPRT]
2022-03-10 Puck and Clevis waterjet assemblies and configs
    [210-03-22A.SLDPRT, 211-15-15B.SLDPRT, 240-01-17B.SLDPRT, 241-15-22A.SLDPRT, 242-15-22A.SLDPRT, 280-013-22-A Main Hoop Brace Right.SLDDRW, 280-014-22-A Main Hoop Brace Left.SLDDRW, 280-015-22-A Main Hoop Brace Attachment Tube.SLDDRW]
2022-03-10 Antiroll Lower Mount Update
    [230-00-22-A.SLDASM, 230-03-22-A.SLDPRT, Antiroll Lower Mount.SLDDRW, Kaz Ohlins Mk2 Damper.SLDASM]
2022-03-10 Indexing for fuel tank side mounts
    [321-19-20-A.SLDPRT]
2022-03-11 A few drawings and some mfg changes
    [230-03-22-A.SLDDRW, 335-05-22A.SLDPRT, 5052 0.063 Single Part.SLDDRW, 5052 0.063 Single Part.SLDPRT, 5052 0.063 Waterjet Profile v2.DXF, 5052 0.063 Waterjet Profile.DXF, 5052 0.063.SLDASM, Clevis Assem Single Part.SLDPRT]
2022-03-11 Moved block A
    [Bellcrank Waterjet Assembly Block A.SLDASM, Bellcrank Waterjet Assembly Block A.SLDDRW]
2022-03-11 steering assembly
    [272-00-21-A.SLDASM, 272-03-21-A.SLDPRT, 272-08-21-A.SLDPRT]
2022-03-11 steering drawings
    [FAS-612-20 Socket Head 8-36 x .375.SLDPRT]
2022-03-15 Machining and waterjetting stuff
    [210-03-17-A.SLDDRW, 221-01-22-A.SLDPRT, 221-04-22-A.SLDPRT, 222-03-22-A.SLDPRT, 222-04-22-A.SLDPRT, 230-09-22-A.SLDPRT, 250-01-11C Brake Rotor.DXF, 250-01-11C.SLDDRW]
2022-03-15 Portrait of A Spacer As A Young Part
    [382-03-22-A.SLDDRW, 382-03-22-A.SLDPRT]
2022-03-15 Fixed things
    [221-00-22-A-JIG.SLDASM, 221-00-22-A.SLDASM, 221-00-22A.SLDASM, 221-05-22-A.SLDPRT, 221-07-22-A.SLDPRT, 222-00-22A.SLDASM, 222-02-22-A.SLDPRT, 222-03-22-A.SLDPRT]
2022-03-15 Tab spacing
    [220-00-22-A.SLDASM, 222-02-22-A.SLDPRT, 222-03-22-A.SLDPRT, 223-00-P-22-A.SLDASM]
2022-03-15 Jig fixes
    Adjusted tab spacing
    Fixed tab positions
    [L Aft Rotary Bellcrank.SLDASM, L Fore Rotary Bellcrank.SLDASM, L Heave Mount.SLDPRT, L Roll Mount.SLDPRT, R Aft Rotary Bellcrank.SLDASM, R Fore Rotary Bellcrank.SLDASM, R Heave Mount.SLDPRT, R Roll Mount.SLDPRT]
2022-03-15 quick drawings
    [jigPlate.SLDDRW]
2022-03-16 Control arm jig assem and plate update
    [210-00-22-A.SLDASM, 211-00-22A.SLDASM, 211-01-22-A.SLDPRT, 211-03-22-A.SLDPRT, 211-05-22-A.SLDPRT, 211-07-22-A.SLDPRT, 212-00-22-A.SLDASM, 212-01-22-A.SLDPRT]
2022-03-16 Drawing updates
    [220-03-22-A.SLDDRW, L Heave Mount.SLDDRW, L Roll Mount.SLDDRW, R Heave Mount.SLDDRW, R Roll Mount.SLDDRW]
2022-03-17 Drawings and mfg
    [210-05-22B.SLDPRT, 211-17-22A.SLDPRT, 230-05-22-A.SLDPRT, 240-03-17B.SLDPRT, 250-05-11B.SLDPRT, 260-00-22A.SLDASM, 261-00-22A.SLDASM, 261-05-22B.SLDPRT]
2022-03-19 Hardware and some drawings
    [200-000-22-A.SLDASM, 220-05-15A.SLDPRT, 221-00-22A.SLDASM, 221-05-22-A.SLDPRT, 221-07-22-A.SLDPRT, 222-00-22A.SLDASM, 222-00-JIG-22A.SLDASM, 222-02-22-A.SLDPRT]
2022-03-19 Assembly fixes and FCA
    [100-00-22A.SLDASM, 120-00-22A.SLDASM, 122-00-22A.SLDASM, 122-01-20A.SLDPRT, 123-01-20A.SLDPRT, 200-000-22-A.SLDASM, 200-000-22A.SLDASM, 210-00-22-A.SLDASM]
2022-03-19 Fixed hex inserts
    [220-00-22A.SLDASM, 221-00-22A.SLDASM, 222-00-22A.SLDASM, 222-02-22-A.SLDPRT, 223-00-FT-22A.SLDASM, 223-00-P-22-A.SLDASM, 223-00-RT-22A.SLDASM, 223-01-22-A.SLDPRT]
2022-03-19 Some bolt updates
    [200-000-22A.SLDASM, 210-00-22-A.SLDASM, 211-00-22A.SLDASM, 211-01-22-A.SLDPRT, 211-03-22-A.SLDPRT, 211-05-22-A.SLDPRT, 211-07-22-A.SLDPRT, 211-17-22A.SLDPRT]
2022-03-20 Stock estimate and WJ layout for MH mounts
    [281-03-22-A.SLDPRT, MH Mount Assem.SLDASM]
2022-03-20 Hopefully this fixes the muffler-diff interference issue
    [310-00-22-A(P-Train Assembly).SLDASM, 360-00-22-A.SLDASM, 361-11-20-A.SLDPRT, 362-00-20-A.SLDASM]
2022-03-20 Removed unneeded flange of rear encoder
    [242-05-22A.SLDPRT]
2022-03-21 Waterjet Assemblies
    [Actuation Tabs - 4130 0.19.SLDASM, MH Mounts - 4130 0.08.SLDASM, Rear Suspension Spacer - 6061 0.3125.SLDASM, Steering Mounts - 4130 0.125.SLDASM]
2022-03-23 fixed cylinder references
    [0_75DXPSR01_00_10.sldprt, 0_75DXPSR01_00_12.sldprt, 0_75DXPSR01_00_3.sldprt, 0_75DXPSR01_00_6.sldprt, 0_75DXPSR01_00_8.sldprt, Grainger-49J635.SLDASM]
2022-03-23 Steering Updates
    [272-00-21-A.SLDASM, 272-05-21-A.SLDPRT, 272-08-21-A.SLDPRT, 272-11-21-A.SLDPRT, 272-11-22-A.SLDPRT, 272-13-22-A.SLDPRT, 272-15-20-A.SLDPRT, 273-00-22-A.SLDASM]
2022-03-23 Sheet metal drawings
    [321-01-20A.SLDDRW, 321-03-20A.SLDDRW, 321-17-20A.SLDDRW, Engine Mounts - 4130 0.1.SLDASM, MH Mounts - 4130 0.08.SLDASM]
2022-03-24 Bodywork assem updates, moved sidepods and nosecone
    [100-00-22A.SLDASM, 110-00-22A.SLDASM, 111-01-22A.SLDPRT, 112-01-22A.SLDPRT, 112-02-22A.SLDPRT, 112-03-22A.SLDPRT, 113-05-22A.SLDPRT, Mirror112-01-22A.SLDPRT]
2022-03-24 Steering Mount Drawings
    [273-23-22-A.SLDDRW]
2022-03-24 Compatibility Update incl Full Car and Powertrain Assembly
    [200-000-22A.SLDASM, 219-378-01.SLDDRW, 219-378-02.SLDDRW, 219-378-03.SLDDRW, 219-378-04.SLDDRW, 219-378-05.SLDDRW, 219-378-10.SLDDRW, 219-378-11.DXF]
2022-03-24 Forgot cooling and shifting in full ptrain assem
    [300-000-22A.SLDASM, 380-00-22-B.SLDASM, 382-00-22-B.SLDASM, 382-01-22-A.SLDPRT, Grainger-49J635.SLDASM]
2022-03-24 Renamed a washer
    [WASH-M8x1.25 St McM-91455A612.SLDPRT]
2022-03-24 Debricked steering assembly
    [270-00-22-A.SLDASM, 272-00-21-A.SLDASM, 272-00-22A.SLDASM, 272-05-21-A.SLDPRT, 272-07-21-A.SLDPRT, 272-07-22A.SLDPRT, 272-08-21-A.SLDPRT, 272-08-22A.SLDPRT]
2022-03-25 SideArea Cost Report Drawings
    [112-01-22A Sidepod.SLDDRW, 112-03-22A Inlet Duct.SLDDRW]
2022-03-25 Revert "SideArea Cost Report Drawings"
    [112-01-22A Sidepod.SLDDRW, 112-03-22A Inlet Duct.SLDDRW]
2022-03-25 Revert "Revert "SideArea Cost Report Drawings""
    This reverts commit 7d25e6e92bc09043b91c25de001630bf4485abe9.
    [112-01-22A Sidepod.SLDDRW, 112-03-22A Inlet Duct.SLDDRW]
2022-03-25 222 Ccar Floor cost report drawing
    [222 Ccar Floor.SLDDRW]
2022-03-25 Nosecone Aeroshield Mount tab cost report drawing
    [FredT Nosecone Mount tab A.SLDDRW]
2022-03-25 Added Headrest Mounts and Cost Report Drawings
    [281-12-22-A Headrest Hot Bottle Mount.SLDDRW, 281-12-22-A Headrest Hot Bottle Mount.SLDPRT, 281-13-22-A Headrest Mount.SLDDRW, 281-13-22-A Headrest Mount.SLDPRT]
2022-03-25 Jackson Simon Nosecone and Aeroshield Cost Drawings
    [111-01-22A_Aeroshield_Drawing.SLDDRW, 111-02-22A_Nosecone_Drawing.SLDDRW]
2022-03-26 Jackson Bodywork Drawings nosecone aeroshield
    [111-01-22A_Aeroshield_Drawing.SLDDRW, 111-02-22A_Nosecone_Drawing.SLDDRW]
2022-03-26 Jackson SImon bodywork cost drawings
    [111-01-22A_Aeroshield_Drawing.SLDDRW, 111-02-22A_Nosecone_Drawing.SLDDRW]
2022-03-26 Fixing and moving stuff
    [272-07-22-A.SLDDRW, 272-08-22-A.SLDDRW, 281-03-22-A.SLDDRW, 301-00-22 B.SLDASM, 301-00-22-A.SLDASM, 310-01-22A.SLDPRT, 310-03-22-A.SLDPRT, 310-03-22A.SLDPRT]
2022-03-27 Added a bunch of cost drawings
    [280-01-22-B Monocoque Cost Report Drawing.SLDDRW, 280-05-22-A Front Roll Hoop Cost Drawing.SLDDRW, 280-21-22-A Firewall Cost Drawing.SLDDRW, 281-00-22-A Main Roll Hoop Assemby Cost Drawing.SLDDRW, 281-00-22-A.SLDASM, 281-03-22-A Main Hoop Mount Cost Drawing.SLDDRW, 282-01-22-A Frontal Protection Assemby Cost Drawing.SLDDRW]
2022-03-27 Cost Report items and added needed hardware
    [240-00-22A.SLDASM, 240-05-17A.SLDPRT, 241-00-22A.SLDASM, 242-00-22A.SLDASM, 251-00-17B.SLDASM, 252-00-17B.SLDASM, FAS-610-01 Socket Head 0.375-24 .SLDPRT, Front Hub Assembly.SLDASM]
2022-03-27 Headrest cost reports
    [131-01-22a Headrest.SLDDRW, 131-03-22a Hearest Cowling.SLDDRW]
2022-03-27 Structural Endplates first commit
    [110-00-22A-Monocoque and Front Wing.SLDASM, Circular standoff ccar.SLDPRT]
2022-03-27 Attempt to fix wing commit problems
    [121-00-22A-Monocoque and Front Wing.SLDASM, Circular standoff ccar.SLDPRT, WR-222c.SLDASM]
2022-03-28 Headrest and Cowling
    [131-01-22a Headrest.SLDPRT, 131-03-22a Headrest Cowling.SLDPRT]
2022-03-28 Updated front wing for ccar
    [121-00-22A-Front Wing Assembly.SLDASM, 121-00-22A-Monocoque and Front Wing.SLDASM]
2022-03-28 aero assembly commit
    [100-00-22A.SLDASM, 110-00-22A.SLDASM, 123-000-22A Rear Wing.SLDASM, Carbon Tube 4e.sldprt, Carbon Tube 5e.sldprt, Carbon Tube 6e.sldprt]
2022-03-28 Minor visual changes
    [261-00-22A.SLDASM, 273-00-22A.SLDASM]
2022-03-28 Cad commit
    [100-00-22A.SLDASM, 121-00-22A-Front Wing Assembly.SLDASM, 121-01-22A Front Wing Cost Report Drawing.SLDDRW, 121-01-22A Front Wing Elements.SLDPRT, 122-01-22A Rear Wing Cost Report Drawing.SLDDRW, WR-222c.SLDASM]
2022-03-28 Cost drawings and cad update
    [100-00-22A.SLDASM, 121-01-22A Front Wing Cost Report Drawing.SLDDRW, 121-02-22A Front Wing Mounts Cost Report Drawing.SLDDRW, 122-01-22A Rear Wing Cost Report Drawing.SLDDRW, 123-000-22A Rear Wing.SLDASM, 220e-123-000 Rear Wing Clevises.sldasm, WR-222c.SLDASM]
2022-03-28 fixed driveline things
    [300-000-22A.SLDASM, 301-00-22 B.SLDASM, 330-00-22A.sldasm, WR-222c.SLDASM]
2022-03-30 3 view drawing
    [000-000c-22A.SLDASM, 100-00-22A.SLDASM, 2022 Combustion 3 View Drawing.SLDDRW, 220-147-00.SLDASM, 220-147-01.SLDASM, 220-147-02.SLDPRT, 220-147-04.sldprt, 220-147-06.SLDPRT]
2022-03-30 Tube part drawings
    [211-01-22-A.SLDDRW]
2022-03-31 Added cost report drawings and snap rings to hardware
    [241-03-22A.SLDPRT, 98455A153_Internal Retaining Ring.SLDPRT, 98455A731_Internal Retaining Ring.SLDPRT, BOLT-AN3.SLDPRT, Front Upright Assembly.SLDASM, Front Upright Assembly.SLDDRW, Front Uprights.SLDDRW, Rear Upright Assembly.SLDASM]
2022-03-31 3 view drawing stuff
    [100-00-22A.SLDASM, 123-000-22A Rear Wing.SLDASM, 2022 Combustion 3 View Drawing Graphics Edition.SLDDRW, 3VD FCA.SLDASM, Aero Shield for 3VD Front View.SLDPRT, Aero Shield for 3VD.SLDPRT, Modine Radiator.SLDASM]
2022-04-01 Added finalized mounts and put into assembly
    [281-00-22-A.SLDASM, 281-12-22-A Headrest Hot Bottle Mount.SLDPRT, 281-13-22-A Headrest Mount.SLDPRT]
2022-04-02 Adding Aeroshield mounts
    Adding some mounts and a rough assembly.
    [aeroshield assembly.SLDASM, mount_fronts_L.SLDPRT, mount_fronts_z.SLDPRT, mount_rear_L.SLDPRT, mount_rears_Z.SLDPRT]
2022-04-04 Aero active cad folders and naming reorganization
    Message Amir if this changes any cad references in your files
    [100-00-22A.SLDASM, 121-00-22A-Front Wing Assembly.SLDASM, 121-01-22A Front Wing Elements.SLDPRT, 121-301-22A Circular standoff short ccar.SLDPRT, 121-302-22A Circular standoff long ccar.SLDPRT, 121-303-22A Aluminum insert for structural endplate.SLDPRT, 121-304-22A Aluminum washer for strucural endplate.SLDPRT, 121-305-22A Aluminum washer Monocoque side.SLDPRT]
2022-04-04 Mono rear holes change
    [280-01-22-B.SLDPRT]
2022-04-04 preturbo intake
    Create pre-turbo intake assembly. Add it to powertrain assembly. Fix full car assembly.
    [000-000c-22A.SLDASM, 100-00-22A.SLDASM, 121-00-22A-Front Wing Assembly.SLDASM, 123-000-22A Rear Wing.SLDASM, 200-000-22A.SLDASM, 220-00-22A.SLDASM, 220e-123-000 Rear Wing Clevises.sldasm, 221-00-22A.SLDASM]
2022-04-05 Front area pane and frontal area calculation
    Also fixed wheels being suppressed
    [000-000c-22A.SLDASM, 240-00-22A.SLDASM, 241-00-22A.SLDASM, 242-00-22A.SLDASM, 245-00-22A.SLDASM, Frontal area pane.SLDPRT]
2022-04-05 Added drawings and stuff
    [281-12-22-A Headrest Hot Bottle Mount.SLDDRW, 281-12-22-A Headrest Hot Bottle Mount.SLDPRT, 281-13-22-A Headrest Mount.SLDDRW, 281-13-22-A Headrest Mount.SLDPRT]
2022-04-07 mono ses work
    [281-00-22-A.SLDASM, 281-01-22-A.SLDPRT, 282-05-22-A.SLDPRT]
2022-04-07 CCar front wing mounting halfway point
    [121-00-22A-Front Wing Assembly.SLDASM, 121-302-22A Circular standoff long ccar.SLDPRT, 121-306-22A Interior monocoque washer.SLDPRT, 121-307-22A Outer monocoque spacer.SLDPRT, 121-308-22A Inner monocoque spacer.SLDPRT]
2022-04-07 Thicker than a snicker
    [121-01-22A Front Wing Elements.SLDPRT]
2022-04-07 hi isaac
    [121-00-22A-Front Wing Assembly.SLDASM]
2022-04-07 Update 131-03-22a Headrest Cowling.SLDPRT
    [131-03-22a Headrest Cowling.SLDPRT]
2022-04-07 Changed rear encoder wheel
    [242-00-22A.SLDASM, 242-05-17B.SLDPRT]
2022-04-07 Front wing mounting final cad commit
    [121-00-22A-Front Wing Assembly.SLDASM, 121-301-22A Circular standoff short ccar.SLDPRT, 121-303-22A Aluminum insert for structural endplate.SLDPRT, 121-306-22A Interior monocoque washer.SLDPRT, 121-308-22A Inner monocoque spacer.SLDPRT, 121-309-22A Inner monocoque spacer fore.SLDPRT, 121-310-22A Outer monocoque spacer fore.SLDPRT]
2022-04-08 CCar Front wing mounting part drawings and folder reorganize
    [121-00-22A-Front Wing Assembly.SLDASM, 121-301-22A CCar Front Wing Circular Standoff Fore Part Drawing.SLDDRW, 121-301-22A CCar Front Wing Circular standoff Fore.SLDPRT, 121-302-22A CCar Front Wing Circular Standoff Rear Part Drawing.SLDDRW, 121-302-22A CCar Front Wing Circular standoff Rear.SLDPRT, 121-302-22A Circular standoff long ccar.SLDPRT, 121-304-22A Aluminum washer for strucural endplate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]
2022-04-08 Added Mounting Holes
    [281-12-22-A Headrest Hot Bottle Mount.SLDPRT, 281-13-22-A Headrest Mount.SLDPRT]
2022-04-09 Headrest Cowling Assembly update
    [100-00-22A.SLDASM, 131-03-22a Headrest Cowling.SLDPRT]
2022-04-09 Adjusted headrest mount spacing
    [281-00-22-A.SLDASM]
2022-04-09 222 C car Floor Parts and Assembly
    [113-00-22A.SLDASM, 113-01-22A.SLDPRT, 113-02-22A.SLDPRT, 113-03-22A.SLDPRT, 113-04-22A.SLDPRT]
2022-04-09 New Upper Steering Mount
    [272-07-22-B.SLDASM, Diagonal Flat.SLDPRT, Lower Flat.SLDPRT, Upper Flat.SLDPRT, Vertical Flat.SLDPRT]
2022-04-09 Moved some drawings
    [281-12-22-A Headrest Hot Bottle Mount.SLDDRW, 281-13-22-A Headrest Mount.SLDDRW]
2022-04-09 Added DXF for headrest mounts
    [281-12-22-A Headrest Hot Bottle Mount.DXF, 281-13-22-A Headrest Mount.DXF]
2022-04-10 Updated Steering Mount for Weld
    [272-07-22-C.SLDASM, 272-07-22-C.SLDPRT, Diagonal Flat C.SLDPRT, Lower Flat C.SLDPRT, Top Flat C.SLDPRT]
2022-04-10 Revert "Merge branch 'main' of https://gitlab.com/wisconsinracing/cad/active-cad"
    This reverts commit cb0fd98958d41d840722ebd8044527ed08991aba
    [100-00-22A.SLDASM, 121-01-22A Front Wing Elements.SLDPRT, 121-301-22A CCar Front Wing Circular Standoff Fore Part Drawing.SLDDRW, 121-301-22A CCar Front Wing Circular standoff Fore.SLDPRT, 121-301-22A Circular standoff short ccar.SLDPRT, 121-302-22A CCar Front Wing Circular Standoff Rear Part Drawing.SLDDRW, 121-302-22A CCar Front Wing Circular standoff Rear.SLDPRT, 121-302-22A Circular standoff 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]
2022-04-11 mono drill templates etc etc
    [280-01-22-B.SLDPRT, 281-00-22-A.SLDASM, 281-01-22-A.SLDPRT]
2022-04-12 Part drawings for front wing final edit
    [100-00-22A.SLDASM, 121-00-22A-Front Wing Assembly.SLDASM, 121-301-22A CCar Front Wing Circular Standoff Fore Part Drawing.SLDDRW, 121-301-22A CCar Front Wing Circular Standoff Part Drawing.SLDDRW, 121-301-22A CCar Front Wing Circular standoff Fore.SLDPRT, 121-302-22A CCar Front Wing Circular Standoff Rear Part Drawing.SLDDRW, 121-302-22A CCar Front Wing Circular standoff Rear.SLDPRT, 121-306-22A 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]
2022-04-12 fixing front wing assembly
    [121-00-22A-Front Wing Assembly.SLDASM]
2022-04-12 Front wing visual adjust commit
    [100-00-22A.SLDASM, 121-00-22A-Front Wing Assembly.SLDASM]
2022-04-13 re made references
    [aeroshield assembly.SLDASM]
2022-04-13 Inboard Suspension Clevis
    [210-03-22A.SLDDRW, 210-03-22A.SLDPRT]
2022-04-13 Cost Drawings
    [223-03-22-A.SLDDRW, 223-05-22-A.SLDDRW, Cost-FR-Assem.SLDASM, Cost-FR-Assem.SLDDRW, Cost-SU-Assem.SLDASM, Cost-SU-Assem.SLDDRW, cost-21101AA.SLDDRW, cost-21103AA.SLDDRW]
2022-04-13 Pedal Changes
    [261-00-22A.SLDASM, 261-05-22B.SLDPRT, 261-07-22B.SLDPRT, 261-15-22A.SLDPRT, McM 6338K415.SLDPRT, McM 6338K466.SLDPRT, Modified McM 6338K415.SLDPRT, Modified McM 6338K466.SLDPRT]
2022-04-14 Final Part ready to be water jetted
    [Final_Upper_firewall_tab__2_.SLDPRT]
2022-04-14 Changed adjustment bolt insert locations
    [223-00-P-22-A.SLDASM]
2022-04-14 Changed insert locations
    [220-00-22A.SLDASM, 221-00-22A.SLDASM, 222-00-22A.SLDASM, 223-00-P-22-A.SLDASM]
2022-04-14 BOTS plus a drawing
    [211-15-15B F Lower Inboard Clevis.SLDDRW, 211-15-15B.SLDPRT, 263-07-22A.SLDPRT]
2022-04-16 Filler neck changes
    [320-10-20A.SLDPRT]
2022-04-17 Final Floor Design
    Added rear strakes
    [113-00-22A.SLDASM, 113-00-22B.SLDASM, 113-01-22A.SLDPRT, 113-01-22B.SLDPRT, 113-02-22A.SLDPRT, 113-02-22B.SLDPRT, 113-03-22A.SLDPRT, 113-03-22B.SLDPRT]
2022-04-19 Drawing Changes
    [210-03-22A - Copy.SLDPRT, 210-03-22A Original.SLDDRW, 210-03-22B Simplified.SLDDRW, 210-03-22B.SLDPRT, 240-01-17B.SLDDRW, 240-01-17B.SLDPRT, 241-15-22A.SLDDRW, 241-15-22A.SLDPRT]
2022-04-20 Modified intake mount
    [356-09-21A Restrictor Mounting Bracket.SLDPRT]
2022-04-20 Headrest stuff and fixes
    [100-00-22A.SLDASM, 121-00-22A-Front Wing Assembly.SLDASM, 122-000-22A Rear Wing.SLDASM, 220e-123-000 Rear Wing Clevises.sldasm, 281-00-22-A.SLDASM, 281-12-22-A Headrest Hot Bottle Mount.SLDPRT, 281-13-22-A Headrest Mount.SLDPRT]
2022-04-20 Aeroshield Mounts Final commit
    [Front Aeroshield Mounts.SLDPRT, Mid Angle Mounts Aeroshield.SLDPRT, Mid Mount Fore Aeroshield.SLDPRT, Part comparison.SLDASM, Rear Aeroshield Mount.SLDPRT, aeroshield assembly.SLDASM, mount_fronts_L.SLDPRT, mount_fronts_z.SLDPRT]
2022-04-20 New intake mount
    [335-07-22A.SLDPRT]
2022-04-21 Added chainguard mount
    [336-05-22A.SLDPRT]
2022-04-22 Waterjet Configs and Assems
    [210-03-22B.SLDPRT, 221-01-22-A.SLDPRT, 222-03-22-A.SLDPRT, 222-04-22-A.SLDPRT, 240-01-17B.SLDPRT, 241-15-22A.SLDPRT, 242-15-22A.SLDPRT, 263-07-22A.SLDPRT]
2022-04-23 updated floor bottom strakes for 3D printing
    [113-00-22B.SLDASM, 113-02-22B.SLDPRT, 113-03-22B.SLDPRT, 113-04-22B.SLDPRT, 113-05-22B.SLDPRT, 113-06-22B.SLDPRT, 113-07-22B.SLDPRT]
2022-04-23 Cowling CAD
    [100-00-22A.SLDASM, 131-03-22a Headrest Cowling.SLDPRT]
2022-04-24 Updated strake CAD for new McMaster inserts
    [113-00-22B.SLDASM, 113-02-22B.SLDPRT, 113-03-22B.SLDPRT, 113-04-22B.SLDPRT, 113-05-22B.SLDPRT, 113-06-22B.SLDPRT, 113-07-22B.SLDPRT]
2022-04-26 Bearing spacer drawings
    [241-11-22A.SLDDRW, 242-11-22A.SLDDRW]
2022-04-27 Waterjet Changes
    [210-03-22B Suspension Inboard Clevis Simplified.DXF, 211-17-22A FL Suspension Spacer.DXF, 240-01-17B Camber Clevis.DXF, 241-15-22A Front Toe Clevis.DXF, 242-15-22A Rear Toe Clevis.DXF, 335-05-22A Diff Clevis.DXF, Revised Clevis+Mount WJ Assem.DXF]
2022-04-27 Appearance Fixes
    [200-000-22A.SLDASM, 210-00-22-A.SLDASM, 210-03-22B.SLDPRT, 211-00-22A.SLDASM, 212-00-22-A.SLDASM, 212-01-22-A.SLDPRT, 212-03-22-A.SLDPRT, 212-05-22-A.SLDPRT]
2022-04-27 Revised drawings
    [241-11-22A.SLDDRW, 242-11-22A.SLDDRW]
2022-05-03 Aeroshield mounts Amir updated bends
    [Front Aeroshield Mounts.SLDPRT, Mid Angle Mounts Aeroshield.SLDPRT, Mid Mount Fore Aeroshield.SLDPRT, Part comparison.SLDASM, Rear Aeroshield Mount.SLDPRT, aeroshield assembly.SLDASM]
2022-05-04 nothing really in structures changes
    [281-03-22-A.SLDPRT, 281-05-22-A.SLDPRT, 282-01-22-A.SLDPRT]
2022-05-08 Front wing bounding box adjustment
    [121-00-22A-Front Wing Assembly.SLDASM, 121-01-22A Front Wing Elements.SLDPRT]
2022-06-04 Quick turn steering fix
    [270-00-22-A.SLDASM, 272-00-22A.SLDASM, 273-00-22A.SLDASM, Column Holder Drawing.SLDDRW, Column Holder.SLDPRT, Flat pattern - Lower Fork Mount dxf.DXF, Flat pattern - Lower Fork Mount dxf2.DXF, Flat pattern - Lower Fork Mount dxf2_imported_DXF cut 2.dxf]
2022-10-04 First addition
    added files
    [223e-450-000.SLDASM, 223e-450-001 Penthouse Box FWD.SLDPRT, 223e-450-002 Penthouse Box RWD.SLDPRT, 223e-450-003 EMI Shielding Plate.SLDPRT, 223e-450-004 Penthouse Box Lid.SLDPRT, 223e-450-005 busbar 1.SLDPRT, 223e-450-010 FWD Standoff.SLDPRT, 223e-450-011 RWD Standoffs.SLDPRT]
2022-10-04 adding files that were referenced into the git
    some files were stored locally on my computer from 220e car so I am putting them here
    [219e-420-06 E-meter fsae.SLDPRT, 220e-336-00 Cold Plate Assembly.SLDASM, 220e-410-01 Capacitor.SLDPRT, 220e-421-02 HV Receptacle.SLDPRT, 220e-421-03 HV Right Angle Plug.SLDPRT, 220e-450-021 - DC Link Positive .SLDPRT, 220e-450-023 - DC Link Negative.SLDPRT, FS200R07A5E3_S6_AG-HYBRIDL-1-1.SLDPRT]
2022-10-04 Adding stuff for dyne set-up
    Dyne set-up CAD documents
    [223e-440-000 Dyne Assembly.SLDASM, 223e-440-001 Coupler Plate.SLDPRT, 223e-440-002 Dyne Shaft.SLDPRT, 223e-440-003 Motor Mounting Plate.SLDPRT, Bed Flange Plate Dyne 4.SLDPRT, Bed Plate Dyne 4.SLDPRT, Bed Plate Nut.SLDPRT, Bed Plate.SLDPRT]
2022-10-05 Adding Dyne Stuff
    Adding Dyne stuff and project updates
    [223e-440-000 Dyne Assembly.SLDASM, 223e-440-002 Dyne Shaft.SLDPRT, 223e-440-003 Motor Mounting Plate.SLDPRT, 223e-450-000.SLDASM, 223e-450-001 Penthouse Box FWD.SLDPRT, 223e-450-003 EMI Shielding Plate.SLDPRT, 223e-450-004 Penthouse Potential Lid.SLDPRT]
2022-10-06 missed documents from push
    missed documents from push
    [223e-440-000 Dyne Assembly.SLDASM, 223e-450-001 Penthouse Box FWD.SLDPRT]
2022-10-07 busbars 1-4
    importing bus bars and other penthouse changes
    [223e-450-000.SLDASM, 223e-450-001 Penthouse Box FWD.SLDPRT, 223e-450-005 busbar 1.SLDPRT, 223e-450-006 busbar 2.SLDPRT, 223e-450-007 busbar 3.SLDPRT, 223e-450-008 busbar 4.SLDPRT]
2022-10-11 Create WEMPEC Dyne Plate.SLDPRT
    Adding WEMPEC Dyne Plate
    [WEMPEC Dyne Plate.SLDPRT]
2022-10-11 Update WEMPEC Dyne Plate.SLDPRT
    [WEMPEC Dyne Plate.SLDPRT]
2022-10-13 Penthouse Updates
    Added busbars, fixed penthouse bend structure
    [223e-440-000 Dyne Assembly.SLDASM, 223e-440-003 Motor Mounting Plate.SLDPRT, 223e-450-000.SLDASM, 223e-450-001 Penthouse Box FWD.SLDPRT, 223e-450-002 Penthouse Box RWD.SLDPRT, 223e-450-003 EMI Shielding Plate.SLDPRT, 223e-450-008 busbar 4.SLDPRT, 223e-450-009 busbar 5.SLDPRT]
2022-10-14 Penthouse Stuff
    DC Bus Bars, Penthouse Box Assy, Lid and Lip, Initial Monocoque/Penthouse Assy
    [223e-450-000.SLDASM, 223e-450-001 Penthouse Box FWD.SLDPRT, 223e-450-002 Penthouse Box RWD.SLDPRT, 223e-450-004 Penthouse Box Lid V2.SLDPRT, 223e-450-004 Penthouse Potential Lid.SLDPRT, 223e-450-013 HVD Cover.SLDPRT, 223e-450-014 Penthouse Lid Lip.SLDPRT, 223e-450-015 Penthouse Box Assy.SLDASM]
2022-10-15 Penthouse Commit
    Penthouse Changes, Mounts, Other Stuff
    [223e-450-000.SLDASM, 223e-450-001 Penthouse Box FWD.SLDPRT, 223e-450-002 Penthouse Box RWD.SLDPRT, 223e-450-003 EMI Shielding Plate.SLDPRT, 223e-450-004 Penthouse Box Lid V2.SLDPRT, 223e-450-013 HVD Cover.SLDPRT, 223e-450-014 Penthouse Lid Lip.SLDPRT, 223e-450-015 Penthouse Box Assy.SLDASM]
2022-10-15 Penthouse Finishes for Initial Review
    Mounts, Monocoque Assy
    [223e-450-000.SLDASM, 223e-450-002 Penthouse Box RWD.SLDPRT, 223e-450-003 EMI Shielding Plate.SLDPRT, 223e-450-004 Penthouse Box Lid V2.SLDPRT, 223e-450-013 HVD Cover.SLDPRT, 223e-450-019 Penthouse Mount 2.SLDPRT, PentHouse Assy in Monocoque.SLDASM]
2022-10-17 New Penthouse Stuff
    Design review fixes
    [223e-450-000.SLDASM, 223e-450-001 Penthouse Box FWD.SLDPRT, 223e-450-001 Penthouse Box V2.SLDPRT, 223e-450-014 Penthouse Lid Lip.SLDPRT]
2022-10-19 Dyne Drawing Progress
    Started drawing for mounting plate
    [223e-440-001 Coupler Plate.SLDPRT, 223e-440-003 Motor Mounting Plate.SLDDRW, 223e-440-003 Motor Mounting Plate.SLDPRT]
2022-10-20 Dyne Drawings
    Motor Mount Plate Drawing Completed
    [223e-440-000 Dyne Assembly.SLDASM, 223e-440-003 Motor Mounting Plate.SLDDRW, 223e-440-003 Motor Mounting Plate.SLDPRT]
2022-10-21 Penthouse and Dyne Stuff
    Dyne Updated drawings and Penthouse V2
    [223e-440-003 Motor Mounting Plate.SLDDRW, 223e-440-003 Motor Mounting Plate.SLDPRT, 223e-450-000 V2.SLDASM, 223e-450-000.SLDASM, 223e-450-001 Penthouse Box FWD.SLDPRT, 223e-450-001 Penthouse Box V2.SLDPRT, 223e-450-002 Penthouse Box Lid V2.SLDPRT, 223e-450-002 Penthouse Box RWD.SLDPRT]
2022-10-21 Dyne Mounting Drawing and Penthouse Progress
    New template dyne drawing, penthouse, cold plate, inverters
    [220e-338-02 Bottom Plate Extended.SLDPRT, 223-338-000 Cold Plate Straight Fin Assembly.SLDASM, 223e-338-01 Finned Base Plate Extended.SLDPRT, 223e-440-003 Motor Mounting Plate V2.SLDDRW, 223e-440-003 Motor Mounting Plate.SLDDRW, 223e-440-003 Motor Mounting Plate.SLDPRT, 223e-450-000 V2.SLDASM, 223e-450-001 Penthouse Box V2.SLDPRT]
2022-10-25 Dyne Drawings and Penthouse Additions
    Completed Dyne Drawings and Added stuff to Penthouse Assy
    [223e-440-003 Motor Mounting Plate V2.SLDDRW, 223e-450-000 V2.SLDASM, 223e-450-000.SLDASM, 223e-450-001 Penthouse Box V2.SLDPRT, 223e-450-002 Penthouse Box Lid V2.SLDPRT, 223e-450-003 Loft Plate V2.SLDPRT]
2022-10-26 Create 330-00-22B (Skeleton Assembly).SLDASM
    [330-00-22B (Skeleton Assembly).SLDASM]
2022-10-27 created 223 main hoop file
    [281-01-23-A.SLDPRT]
2022-10-30 223 Floor merge
    [000-000c-22A.SLDASM, 0_75DXPSR01_00_10.sldprt, 0_75DXPSR01_00_12.sldprt, 0_75DXPSR01_00_6.sldprt, 0_75DXPSR01_00_8.sldprt, 100-00-22A.SLDASM, 110-00-22A.SLDASM, 111-01-22A.SLDPRT]
2022-10-30 Revert "223 Floor merge"
    This reverts commit c5e654de9f363f005fd880724333b3850ce22ef4.
    [000-000c-22A.SLDASM, 0_75DXPSR01_00_10.sldprt, 0_75DXPSR01_00_12.sldprt, 0_75DXPSR01_00_6.sldprt, 0_75DXPSR01_00_8.sldprt, 100-00-22A.SLDASM, 110-00-22A.SLDASM, 111-01-22A.SLDPRT]
2022-10-30 223 Floor progress so far
    [113-00-22B.SLDASM, 113-01-22B.SLDPRT, 113-02-22B.SLDPRT, 113-03-22B.SLDPRT, 113-04-22B.SLDPRT, 113-05-22B.SLDPRT, 113-06-22B.SLDPRT, 113-07-22B.SLDPRT]
2022-10-31 Penthouse and Dyne
    New Bus Bars, New penthouse layout, new dyne coupler plate drawing
    [223e-440-000 Dyne Assembly.SLDASM, 223e-440-001 Coupler Plate.SLDPRT, 223e-440-001 Dyne Coupler Plate.SLDDRW, 223e-440-001 Dyne Coupler Plate.SLDPRT, 223e-440-003 Motor Mounting Plate.SLDDRW, 223e-440-003 Motor Mounting Plate.SLDPRT, 223e-450-000 V2.SLDASM, 223e-450-001 Penthouse Box V2.SLDPRT]
2022-10-31 Added hubs to associated folders
    [240-11-22-A.SLDPRT, 240-15-22-A.SLDPRT, 241-01-22-A.SLDPRT, 242-01-22-A.SLDPRT, 242-03-22A.SLDPRT]
2022-11-01 i dont remeber, something
    [280-01-22-B.SLDPRT]
2022-11-01 Penthouse updates and dyne drawings updates
    Finished dyne drawings, extended wave fin cold plate, ac bus bar fillets
    [220e-336-01 Wavy Base Plate Extended.SLDPRT, 223e-440-000 Dyne Assembly.SLDASM, 223e-440-001 Dyne Coupler Plate.SLDDRW, 223e-440-003 Motor Mounting Plate V2.SLDDRW, 223e-440-003 Motor Mounting Plate.SLDPRT, 223e-450-000 V2.SLDASM, 223e-450-005 busbar 1 V2.SLDPRT, 223e-450-006 busbar 2 V2.SLDPRT]
2022-11-02 mounting assembly
    [121-300-23A Mounting Assembly.SLDASM, 121-301-23A Aft mounting offset.SLDPRT, 121-301-23A Fore mounting offset.SLDPRT, 121-302-23A Gooseneck mount iter 4 smaller check.SLDPRT, 121-302-23A Gooseneck mount iter 4 smaller.SLDPRT, 121-304-23A bulkhead side clevis.SLDPRT, 121-304-23A mono side clevis.SLDPRT, 121-304-23A wing side clevis.SLDPRT]
2022-11-02 Wavy Cold Plate
    Wavy Cold Plate Design
    [220e-336-01 Wavy Base Plate Extended.SLDPRT, 223e-336-000 Cold Plate Wavy Fin Assy.SLDASM, 223e-336-01 Wavy Base Plate Extended.SLDPRT, 223e-338-000 Cold Plate Straight Fin Assembly.SLDASM, 223e-338-01 Finned Base Plate Extended.SLDPRT, 223e-338-02 Bottom Plate Extended.SLDPRT, 223e-431-001 Cold Plate Connection Gasket.SLDPRT, 223e-450-000 V2.SLDASM]
2022-11-03 Cold Plate Stuff and Penthouse Lid Bolt Openings
    More Cold Plate Stuff
    Added Penthouse Lid Holes
    [223e-336-000 Cold Plate Wavy Fin Assy.SLDASM, 223e-336-01 Wavy Base Plate Extended.SLDPRT, 223e-336-02 Wavy Bottom Plate Extended.SLDPRT, 223e-450-000 V2.SLDASM, 223e-450-001 Penthouse Box V2.SLDPRT, 223e-450-002 Penthouse Box Lid V2.SLDPRT, 223e-450-007 busbar 3 V2.SLDPRT]
2022-11-08 Fixing Cold Plate and Penthouse Model
    Fixed Cold Plate and Changed the reference locations for the penthouse parts
    [219e-611-05 M5 10mm Hex.SLDPRT, 219e-611-10 M6 14mm Hex.SLDPRT, 220e-410-35 Current Sensor.SLDASM, 223e-336-000 Cold Plate Wavy Fin Assy.SLDASM, 223e-336-01 Wavy Base Plate Extended.SLDPRT, 223e-336-02 Wavy Bottom Plate Extended.SLDPRT, 223e-450-000 V2.SLDASM, 223e-450-001 Penthouse Box V2.SLDPRT]
2022-11-09 Commit some org changes and wing mounting updates
    [121-300-23A Mounting Assembly.SLDASM, 121-301-22A CCar Front Wing Circular standoff Fore.SLDPRT, 121-301-22A Circular standoff short ccar.SLDPRT, 121-301-23A Aft mounting offset.SLDPRT, 121-301-23A Fore mounting offset.SLDPRT, 121-302-22A CCar Front Wing Circular standoff Rear.SLDPRT, 121-302-22A Circular standoff long ccar.SLDPRT, 121-302-23A Gooseneck mount iter 4 smaller.SLDPRT]
2022-11-09 fixing file locations
    [121-00-22A-Front Wing Assembly.SLDASM, 121-01-22A Front Wing Elements.SLDPRT]
2022-11-09 deleting mono reference in mounting assembly
    [121-300-23A Mounting Assembly.SLDASM]
2022-11-10 Cold Plate Connection and Old Switch Panel
    Old Switch Panel Designs
    [220e-420-001 Cover.SLDPRT, 220e-420-001 New Transfer Switch Box.SLDPRT, 220e-420-001 Transfer Switch Box.DXF, 220e-420-001 Transfer Switch Box.SLDDRW, 220e-420-001 Transfer Switch Box.SLDPRT, 220e-420-001M New Transfer Switch Box Mold Assembly.SLDASM, 220e-420-001M New Transfer Switch Box Mold Assembly.SLDPRT, 220e-420-002 Backplate.SLDPRT]
2022-11-10 Mounts and DC Bus Bars
    Rear Mounts and DC Bus Bars
    [223e-431-000 Cold Plate Connection Assy.SLDASM, 223e-431-001 Cold Plate Connection Gasket.SLDPRT, 223e-450-000 V2.SLDASM, 223e-450-009 DC Bus Bar V3.SLDPRT, 223e-450-010 DC E-meter Bus Bar 1 V2.SLDPRT, 223e-450-011 Rear LH Mount V2.SLDPRT, 223e-450-012 Rear LH Gusset 1.SLDPRT, 223e-450-013 Rear LH Mount Assy.SLDASM]
2022-11-11 DC Bus Bars
    DC Bus Bars Complete
    [219e-611-05 M5 10mm Hex.SLDPRT, 223e-450-000 V2.SLDASM, 223e-450-009 DC Bus Bar V3.SLDPRT, 223e-450-010 DC E-meter Bus Bar 1 V2.SLDPRT, 223e-450-019 Lower DC IGBT Drop Through.SLDPRT, 223e-450-020 DC Cap Upper Bus Bar.SLDPRT, 223e-450-021 Upper DC Cap Drop Through.SLDPRT, 223e-450-022 Upper DC IGBT Drop Through.SLDPRT]
2022-11-13 Mounts and Fixing Bend Radius
    Finished mounts and fixed some parts bend radius to be 1*thickness
    [223e-450-000 V2.SLDASM, 223e-450-001 Penthouse Box V2.SLDPRT, 223e-450-002 Penthouse Box Lid V2.SLDPRT, 223e-450-003 Loft Plate V2.SLDPRT, 223e-450-010 DC E-meter Bus Bar 1 V2.SLDPRT, 223e-450-011 Rear LH Mount V2.SLDPRT, 223e-450-012 Rear LH Gusset 1.SLDPRT, 223e-450-013 Rear LH Mount Assy.SLDASM]
2022-11-14 Updated front assembly
    [240-11-22-A.SLDPRT, 241-00-22A.SLDASM, 241-01-22-A.SLDPRT, 241-03-22A.SLDPRT, 251-00-17B.SLDASM, 90026A107_18-8 Stainless Steel Strong-Hold Wire-Snap Cotter Pin.SLDPRT]
2022-11-15 Bus Bar Nut Plates
    Bus Bar Nut Plates and Updated to 2022
    [219e-420-06 E-meter fsae.SLDPRT, 219e-611-05 M5 10mm Hex.SLDPRT, 219e-611-10 M6 14mm Hex.SLDPRT, 220e-410-01 Capacitor.SLDPRT, 220e-410-35 Current Sensor.SLDASM, 220e-421-02 HV Receptacle.SLDPRT, 220e-421-03 HV Right Angle Plug.SLDPRT, 223e-336-000 Cold Plate Wavy Fin Assy.SLDASM]
2022-11-17 Penthouse Stuff
    Autosport Connector
    [219e-611-08 M6 10mm Hex.SLDPRT, 223e-450-000 V2.SLDASM, 223e-450-001 Penthouse Box V2.SLDPRT, 223e-450-003 Loft Plate V2.SLDPRT, 223e-450-016 Rear RH Mount Assy.SLDASM, 223e-450-016 Rear RH Mount V2.SLDPRT, 223e-450-021 Upper DC Cap Drop Through.SLDPRT, 223e-450-022 Upper DC IGBT Drop Through.SLDPRT]
2022-11-18 Penthouse Fixes
    Penthouse Fixes
    [223e-450-000 V2.SLDASM, 223e-450-001 Penthouse Box V2.SLDPRT, 223e-450-002 Penthouse Box Lid V2.SLDPRT, 223e-450-005 busbar 1 V2.SLDPRT, 223e-450-006 busbar 2 V2.SLDPRT, 223e-450-007 busbar 3 V2.SLDPRT, 223e-450-009 DC Bus Bar V3.SLDPRT, 223e-450-010 DC E-meter Bus Bar 1 V2.SLDPRT]
2022-11-18 Penthouse Stuff
    Adding Bolts and Fixing other stuff
    [223e-450-000 V2.SLDASM, 223e-450-003 Loft Plate V2.SLDPRT, 223e-450-36 Model BMB Wires.SLDPRT, 8STA-00-14_NOT-LISTED.stp, AN Nut.SLDPRT, AN4-4 Hardware set.SLDASM, AN4.SLDPRT, FAS-620-01 AN Washer.SLDPRT]
2022-11-21 Create Coldplate-underplate.SLDPRT
    underplate for coldplate in penthouse assembly
    [Coldplate-underplate.SLDPRT]
2022-11-21 Connectors and Mount Sims
    Connectors and Mount Sims
    [223e-450-000 V2.SLDASM, 223e-450-011 Rear LH Mount V2.SLDPRT, 223e-450-012 Rear LH Gusset 1.SLDPRT, 223e-450-013 Rear LH Mount Assy.SLDASM, 223e-450-014 Rear LH Gusset 2.SLDPRT, 223e-450-015 Rear LH Gusset 3.SLDPRT, 223e-450-016 Rear RH Mount Assy.SLDASM, 223e-450-023 BusBar Holes.SLDASM]
2022-11-22 Penthouse Fixes/Connectors
    Connectors and Fixes
    [223e-450-000 V2.SLDASM, 223e-450-001 Penthouse Box V2.SLDPRT, 223e-450-038 LV Battery Connection Assy.SLDASM, 8STA-00-14_NOT-LISTED.stp.SLDPRT, c-16-04978-a-3d.stp, c-16-04978-a-3d.stp.SLDPRT, c-2411-002-1805-99-3d.stp, c-2411-002-1805-99-3d.stp.SLDPRT]
2022-11-23 Cold Plate Stuff and Other fixes
    Cold Plate Stuff
    [223e-336-000 Cold Plate Wavy Fin Assy.SLDASM, 223e-340-000 Cold Plate O-Ring Assy.SLDASM, 223e-340-01 Cold Plate O-Ring Groove.SLDPRT, 223e-450-000 V2.SLDASM, 223e-450-001 Penthouse Box V2.SLDPRT, 223e-450-005 busbar 1 V2.SLDPRT, 223e-450-006 busbar 2 V2.SLDPRT, 223e-450-007 busbar 3 V2.SLDPRT]
2022-11-30 Swapped in new bearing blocks to skeleton assembly
    [330-00-22B (Skeleton Assembly).SLDASM, 330-00-23B (Skeleton Assembly).SLDASM, 335-01-23A.SLDPRT, 335-02-23A.SLDPRT, 335-17-23A.SLDPRT]
2022-11-30 Penthouse Stuff
    Penthouse Sutff
    [223e-450-000 V2.SLDASM, 223e-450-001 Penthouse Box V2.SLDPRT, 223e-450-002 Penthouse Box Lid V2.SLDPRT, 223e-450-003 Loft Plate V2.SLDPRT, 223e-450-010 DC E-meter Bus Bar 1 V2.SLDPRT, 223e-450-018 Outline of BMB.SLDPRT, 223e-450-024 HVD DC Neg Bus Bar.SLDPRT, 223e-450-028 Front RH Monocoque Mount Assy.SLDASM]
2022-12-01 Mounting Changes
    Mounting Changes
    [223e-450-000 V2.SLDASM, 223e-450-001 Penthouse Box V2.SLDPRT, 223e-450-002 Penthouse Box Lid V2.SLDPRT, Penthouse V2 in Monocoque.SLDASM]
2022-12-01 New Ecar Rollhoop
    Ecar Rollhoop changed to accommodate tsal light regulations
    [281-01e-23-A.SLDPRT]
2022-12-01 Final Cowling Iteration
    [000-000c-22A.SLDASM, 100-00-22A.SLDASM, 114-01-23A.SLDPRT]
2022-12-02 removed external references
    [111-01-22A.SLDPRT]
2022-12-02 mirrored some ship
    [281-01e-23-A.SLDPRT]
2022-12-03 Main hoop updates
    [281-00-22-A.SLDASM, 281-01-22-A.SLDPRT, 281-01e-23-A.SLDPRT, 282-03-22-A.SLDPRT, 282-05-22-A.SLDPRT]
2022-12-03 Update front and rear corner assemblies
    [240-15-22-A.SLDPRT, 241-00-22A.SLDASM, 241-01-22-A.SLDPRT, 241-03-22A.SLDPRT, 242-00-22A.SLDASM, 242-01-22-A.SLDPRT, 242-03-22A.SLDPRT, 251-00-17B.SLDASM]
2022-12-05 Penthouse Stuff
    Penthouse Stuff
    [223_BMB.SLDPRT, 223_BMB.step, 223e-342-000.SLDASM, 223e-342-01 Cold Plate O-Ring Groove Add.SLDPRT, 223e-342-03 Cold Plate O-Ring Groove Under Plate.SLDPRT, 223e-450-000 V2.SLDASM, 223e-450-009 DC Bus Bar V3.SLDPRT, 223e-450-02 Cold Plate O-Ring Groove Add Lid.SLDPRT]
2022-12-06 Bus Bar Clearance Models
    Bus Bar Clearance Models
    [222_Discharge_Circuit.step, 223e-450-007 busbar 3 V2.SLDPRT, 7195A41_6-Point Deep Socket.SLDPRT, 7195A45_6-Point Deep Socket.SLDPRT, AC Bus Bar Tool and Current Sensor Clearance.SLDASM]
2022-12-07 Penthouse Stuff
    New Geometry and Loft Plate modeling
    [222_Discharge_Circuit.SLDASM, 222_Discharge_Circuit.step, 222_Discharge_Circuit.x_t, 223e-342-000.SLDASM, 223e-342-01 Cold Plate O-Ring Groove Add.SLDPRT, 223e-450-000 V2.SLDASM, 223e-450-001 Penthouse Box V2.SLDPRT, 223e-450-002 Penthouse Box Lid V2.SLDPRT]
2022-12-08 Penthouse Fixes
    Loft plate, New lid
    [223e-342-000.SLDASM, 223e-342-01 Cold Plate O-Ring Groove Add.SLDPRT, 223e-450-000 V2.SLDASM, 223e-450-001 Penthouse Box V2.SLDPRT, 223e-450-003 Loft Plate V2.SLDPRT, 223e-450-010 DC E-meter Bus Bar 1 V2.SLDPRT, 223e-450-023 BusBar Holes.SLDASM, 223e-450-023 E-meter busbar 2.SLDPRT]
2022-12-09 Penthouse Fixes
    Lid bolts, Mount Changes
    [223e-450-000 V2.SLDASM, 223e-450-001 Penthouse Box V2.SLDPRT, 223e-450-007 busbar 3 V2.SLDPRT, 223e-450-013 Rear LH Mount Assy.SLDASM, 223e-450-016 Rear RH Mount Assy.SLDASM, 223e-450-023 BusBar Holes.SLDASM, 223e-450-026 Front RH Mount Plate 1.SLDPRT, 223e-450-027 Front RH Mount Assy-1.SLDASM]
2022-12-11 created some nessesary main hoop stuff
    [281-03-22-A.SLDPRT, 281-14-23-A MHM Backing Plate.SLDPRT, 281-15-23-A MHM Interior Plate.SLDPRT]
2022-12-11 223 Steering
    [10mm ID Angular Contact Bearing.SLDPRT, 15mm ID Angular Contact Bearing.SLDPRT, 270-00-23-A.SLDASM, 272-00-23A.SLDASM, 272-01-20-A.SLDPRT, 272-03-21-A.SLDPRT, 272-07-22A.SLDPRT, 272-08-22A.SLDPRT]
2022-12-12 Penthouse Fixes
    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
    [220e-410-35 Current Sensor.SLDASM, 223e-342-000.SLDASM, 223e-431-000 Cold Plate Connection Assy.SLDASM, 223e-450-000 V2.SLDASM, 223e-450-001 Penthouse Box V2.SLDPRT, 223e-450-003 Loft Plate V2.SLDPRT, 223e-450-005 busbar 1 V2.SLDPRT, 223e-450-006 busbar 2 V2.SLDPRT]
2022-12-12 Added Final Floor
    Final Floor added for design freeze
    [223l Floor Final.SLDPRT]
2022-12-12 Updated corners system
    [241-00-22A.SLDASM, 241-01-22-A.SLDPRT, 241-03-22A.SLDPRT, 242-00-22A.SLDASM, 242-01-22-A.SLDPRT, 242-03-22A.SLDPRT, 251-00-17B.SLDASM, 252-00-17B.SLDASM]
2022-12-12 Updated rear assembly
    [242-00-22A.SLDASM]
2022-12-12 223 Steering Updates
    [272-00-23A.SLDASM, Upper Steering Mount v9 Assem 2.SLDASM]
2022-12-12 Part Drawings for corners
    [241-01-22-A.SLDDRW, 241-01-22-A.SLDPRT, 241-03-22-A.SLDDRW, 241-03-22A.SLDPRT, 241-04-22-A.SLDDRW, 242-01-22-A.SLDDRW, 242-01-22-A.SLDPRT, 242-03-22A.SLDDRW]
2022-12-12 mono tweaks
    [280-03-22-A.SLDPRT, 281-14-23-A MHM Backing Plate.SLDPRT]
2022-12-12 Updated corners
    [240-15-22-A.SLDPRT, 241-00-22A.SLDASM, 241-01-22-A.SLDPRT, 242-01-22-A.SLDPRT, 251-00-17B.SLDASM]
2022-12-12 223 Steering Naming Updates
    [272-00-23A.SLDASM, 272-05-22A.SLDPRT, 272-07-22A.SLDPRT, 272-08-22A.SLDPRT, 272-13-22A.SLDPRT, 272-14-22A.SLDPRT, 272-15-22A.SLDPRT, 272-17-22-A.SLDPRT]
2022-12-15 Penthouse
    Discharge Circuit Standoffs
    [223e-450-000 V2.SLDASM, 223e-450-001 Penthouse Box V2.SLDPRT, 223e-450-003 Loft Plate V2.SLDPRT, 223e-450-043 Slanted Lid.SLDPRT, 223e-450-045 Penthouse Lid Gap Piece.SLDPRT, 91075A450_Male-Female Threaded Hex Standoff.SLDPRT, 91075A481_Male-Female Threaded Hex Standoff.SLDPRT, 91075A487_Male-Female Threaded Hex Standoff.SLDPRT]
2022-12-15 main hoop mounts
    [281-00-22-A.SLDASM, 281-09-22-A.SLDPRT]
2022-12-16 223 Steering Clamshell Updates and Drawings
    [270-00-23-A.SLDASM, 273-00-23A.SLDASM, 273-17-22-A.SLDPRT, 273-19-22-A.SLDDRW, 273-19-22-A.SLDPRT, 273-21-22-A.SLDDRW, 273-21-22-A.SLDPRT]
2022-12-16 223 Steering Part Drawing Updates
    [273-01-20-A.SLDPRT, 273-19-22-A.SLDDRW, 273-21-22-A.SLDDRW, 273-21-22-A.SLDPRT]
2022-12-16 Updated Control Arms
    [210-00-22-A.SLDASM, 210-01-17-B.SLDPRT, 210-03-22B.SLDPRT, 210-05-22B.SLDPRT, 211-00-22A.SLDASM, 211-01-22-A.SLDPRT, 211-01-22-AL.SLDPRT, 211-03-22-A.SLDPRT]
2022-12-16 Updated Steering Drawings
    [273-19-22-A.SLDDRW, 273-21-22-A.SLDDRW]
2022-12-23 getting stock
    [281-00-22-A.SLDASM, 281-03-22-A.SLDPRT, 281-13-22-A Headrest Mount.SLDPRT]
2022-12-24 Updated Steering Wheel
    [1.12591780A594_Female Threaded Hex Standoff.SLDPRT, 1.SLDPRT, 10-32Caphead1inch.SLDPRT, 10-32halfInch.SLDPRT, 10-32halfInch.STEP, 10-32x0.75.STEP, 10.SLDPRT, 11.SLDPRT]
2022-12-25 main hoop stuiff for SES
    [281-00-22-A.SLDASM, 281-01e-23-A.SLDPRT, 281-09-23-A MHBM Interior Plate.SLDPRT]
2022-12-25 Main hoop minor ses tweaks
    [281-00-22-A.SLDASM, 281-01e-23-A.SLDPRT, 281-09-23-A MHBM Interior Plate.SLDPRT]
2022-12-26 Straight Fin Cold Plate
    [223e-338-000 Cold Plate Straight Fin Assembly.SLDASM, 223e-338-01 Finned Base Plate Extended.SLDPRT, 223e-338-03 Straight Fin Lid V2.SLDPRT, 223e-338-04 Straight Fin Under Support Plate.SLDPRT, 223e-342-000.SLDASM, 223e-342-01 Cold Plate O-Ring Groove Add.SLDPRT, 223e-342-03 Cold Plate O-Ring Groove Under Plate.SLDPRT, 223e-450-000 V2.SLDASM]
2022-12-28 Fueling Update To Active Cad
    [218-321-00.SLDASM, 218-321-14 new.SLDDRW, 218-321-33.SLDDRW, 218-321-69.DXF, 218-321-69.SLDDRW, 218-321-70.DXF, 218-321-70.SLDDRW, 218-321-72.DXF]
2022-12-30 minor tweaks while doing SES, fixed 1 small part on fuel tank
    [281-00-22-A.SLDASM, 281-01-22-A.SLDPRT, 321-00-23A.SLDASM, 321-19-23-A.SLDPRT]
2023-01-06 Part Drawings
    [272-05-22A.SLDDRW, 272-11-21-A.SLDDRW]
2023-01-06 added some hardware
    [97431A300_Side-Mount External Retaining Rings.SLDPRT, WASH-18-8 St McM-98019A239.SLDPRT]
2023-01-12 Updated Bearing Blocks
    Bearing Blocks with proper hole locations
    [330-00-23B (Skeleton Assembly).SLDASM, 335-01-23A.SLDPRT, 335-02-23A.SLDPRT, 335-17-23A.SLDPRT]
2023-01-13 Hub Drawings
    [241-01-22-A.SLDDRW, 241-01-22-A.SLDPRT, 242-01-22-A.SLDDRW, 242-01-22-A.SLDPRT]
2023-01-14 Filler neck for ses update
    [321-00-23A.SLDASM, Filler_Neck_For_SES.SLDPRT]
2023-01-14 Filler neck update
    [321-00-23A.SLDASM, Filler_Neck_For_SES.SLDPRT]
2023-01-17 rotor thickness change
    [250-01-11C.SLDPRT]
2023-01-17 Control arm assemblies and Jigs
    [Center Support.SLDPRT, Front LCA Jig.SLDASM, Front LCA Plate.SLDPRT, Front Lower A-Arm.SLDASM, Front UCA Jig.SLDASM, Front UCA Plate.SLDPRT, Front UCA Tab Upper.SLDPRT, Front Upper A-Arm.SLDASM]
2023-01-17 Upright Part Drawing
    [241-03-23-A.SLDDRW, 241-03-23-A.SLDPRT]
2023-01-17 Hub Part Drawings Updates
    [241-01-22-A.SLDDRW, 242-01-22-A.SLDDRW]
2023-01-17 upright fillets
    [241-03-23-A.SLDPRT]
2023-01-17 Updated Upright Drawings
    [241-03-23-A.SLDDRW, 242-03-22-A.SLDDRW, 242-03-22A.SLDPRT, 242-04-22-A.SLDDRW, 273-19-22-A.SLDPRT]
2023-01-17 Updated Drawing
    [241-03-23-A.SLDDRW]
2023-01-17 Upright Part Drawings
    [241-03-23-A.SLDPRT, 241-04-23-A.SLDPRT, 242-03-22-A.SLDDRW, 242-04-22-A.SLDDRW]
2023-01-17 A arm
    [211-01-22-A.SLDPRT, 211-01-22-AL.SLDPRT, 211-01-23-A.SLDPRT, 211-01-23-AL.SLDPRT, 211-03-22-A.SLDPRT, 211-03-23-A.SLDPRT, 211-05-22-B.SLDPRT, 211-05-22-BL.SLDPRT]
2023-01-17 Un-fucked hardware files
    [BOLT-AN3.SLDPRT, BOLT-AN4.SLDPRT, NUT-8-32.SLDPRT, NUT-AN3.SLDPRT, NUT-AN4.SLDPRT, WASH-AN3.SLDPRT, WASH-AN4.SLDPRT]
2023-01-18 added kin
    [KIN-01-23-E.SLDPRT]
2023-01-19 Brake Rotor dxf
    [250-01-11C.DXF]
2023-01-20 huuuuge updates
    [210-01-17-B.DXF, 210-03-17-A.SLDDRW, 210-03-22A - Copy.SLDPRT, 210-03-22A Original.SLDDRW, 210-03-22B Simplified.SLDDRW, 211-00-23A.SLDASM, 211-01-22-A.SLDDRW, 211-01-23-A.SLDPRT]
2023-01-20 Added Ecar
    [219e-241-05 Upright Outer Half Cost.SLDDRW, 219e-241-05 Upright Outer Half.SLDDRW, 219e-241-05 Upright Outer Half.STEP, 220e-240-00 Corner Assembly.SLDASM, 220e-240-03 Pillow Block and Misc Bushings (Pillow Block Config) Cost.SLDDRW, 220e-240-03 Pillow Block and Misc Bushings (Pillow Block Config).SLDDRW, 220e-240-03 Pillow Block and Misc Bushings.SLDPRT, 220e-240-04 Toe Block and Misc Bushings (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]
2023-01-20 Moving Ccar Corner Files
    [240-00-22A.SLDASM, 240-01-17B.SLDDRW, 240-09-22-A.SLDDRW, 240-09-22-B.SLDDRW, 240-21-22-A.SLDPRT, 240-21-22-B.SLDPRT, 241-00-22A.SLDASM, 241-01-22-A.SLDDRW]
2023-01-20 Revert "Merge branch 'Corners'"
    This reverts commit 06dd71632e3b16506530abbc9e437a2fe1fc30a6, reversing
    changes made to af80d3f00b855eac20f384449dbc25203cb0b8ab.
    [219e-241-05 Upright Outer Half Cost.SLDDRW, 219e-241-05 Upright Outer Half.SLDDRW, 219e-241-05 Upright Outer Half.STEP, 220e-240-00 Corner Assembly.SLDASM, 220e-240-03 Pillow Block and Misc Bushings (Pillow Block Config) Cost.SLDDRW, 220e-240-03 Pillow Block and Misc Bushings (Pillow Block Config).SLDDRW, 220e-240-03 Pillow Block and Misc Bushings.SLDPRT, 220e-240-04 Toe Block and Misc Bushings (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]
2023-01-20 Added 223 Corner Drawings
    [241-03-23-A.SLDDRW, 242-03-22-A.SLDDRW, 242-04-22-A.SLDDRW]
2023-01-20 Removing Dublicates
    [240-01-17B.SLDPRT, 240-03-17B.SLDPRT, 240-05-17A.SLDPRT, 240-11-22-A.SLDPRT, 240-15-22-A.SLDPRT, 90026A107_18-8 Stainless Steel Strong-Hold Wire-Snap Cotter Pin.SLDPRT]
2023-01-20 Removing Duplicates
    [241-03-22A.SLDPRT, 241-05-22B.SLDPRT, 241-11-22A.SLDPRT, 241-15-22A.SLDPRT, 242-00-22A.SLDASM, 242-05-22A.SLDPRT, 242-11-22A.SLDPRT, 242-15-22A.SLDPRT]
2023-01-20 Removing to Readd
    [240-00-22A.SLDASM, 240-01-17B.SLDDRW, 240-09-22-A.SLDDRW, 240-09-22-B.SLDDRW, 240-21-22-A.SLDPRT, 240-21-22-B.SLDPRT, 241-00-22A.SLDASM, 241-01-22-A.SLDDRW]
2023-01-20 Readding Corners
    [219e-241-05 Upright Outer Half Cost.SLDDRW, 219e-241-05 Upright Outer Half.SLDDRW, 219e-241-05 Upright Outer Half.STEP, 220e-240-00 Corner Assembly.SLDASM, 220e-240-03 Pillow Block and Misc Bushings (Pillow Block Config) Cost.SLDDRW, 220e-240-03 Pillow Block and Misc Bushings (Pillow Block Config).SLDDRW, 220e-240-03 Pillow Block and Misc Bushings.SLDPRT, 220e-240-04 Toe Block and Misc Bushings (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]
2023-01-21 Manufacturing Docs and Motor Assembly
    Manufacturing Docs for Cold Plate, Bus Bars, and 3d printed stuff. Also putting the motor assembly in active cad
    [0.05 inch Lower DC Bus Bar Layout.DXF, 0.05 inch Lower DC Bus Bar Layout.SLDASM, 0.05 inch Upper DC Bus Bar Layout.DXF, 0.05 inch Upper DC Bus Bar Layout.SLDASM, 0.125 inch Bus Bar Layout.DXF, 0.125 inch Bus Bar Layout.SLDASM, 220e-310-00 Motor Assembly [Rotor Assembly Drawing].SLDDRW, 220e-310-00 Motor Assembly.SLDASM]
2023-01-21 Adding Ecar Brakes
    [-02 Hose to -03 45o Neck Banjo.SLDPRT, -02 Hose to -03 Female.SLDPRT.SLDASM, -02 Hose to -03 STR EXT Neck Banjo Body.SLDPRT, -02 Hose to -03 STR EXT Neck Banjo.SLDASM, 220e-222-00 Rear Caliper.SLDASM, 220e-222-01 Banjo Bolt.SLDPRT, 220e-222-02 Brake Pad.SLDPRT, 220e-222-02 Rough Waterjet Profile.DXF]
2023-01-21 Revert "Merge branch 'Natalie---Brakes'"
    This reverts commit a300682cb0ba326704a8787a99b54b325f077eab
    [-02 Hose to -03 45o Neck Banjo.SLDPRT, -02 Hose to -03 Female.SLDPRT.SLDASM, -02 Hose to -03 STR EXT Neck Banjo Body.SLDPRT, -02 Hose to -03 STR EXT Neck Banjo.SLDASM, 220e-222-00 Rear Caliper.SLDASM, 220e-222-01 Banjo Bolt.SLDPRT, 220e-222-02 Brake Pad.SLDPRT, 220e-222-02 Rough Waterjet Profile.DXF]
2023-01-21 Revert "Revert "Merge branch 'Natalie---Brakes'""
    This reverts commit 29f1e5e097616291e79693df8eceb95a4c45e460.
    [-02 Hose to -03 45o Neck Banjo.SLDPRT, -02 Hose to -03 Female.SLDPRT.SLDASM, -02 Hose to -03 STR EXT Neck Banjo Body.SLDPRT, -02 Hose to -03 STR EXT Neck Banjo.SLDASM, 220e-222-00 Rear Caliper.SLDASM, 220e-222-01 Banjo Bolt.SLDPRT, 220e-222-02 Brake Pad.SLDPRT, 220e-222-02 Rough Waterjet Profile.DXF]
2023-01-21 Revert "Merge branch '223-suspension-integration'"
    This reverts commit f2248fa13214309bb28896058d4c73cb07bc83d5, reversing
    changes made to a300682cb0ba326704a8787a99b54b325f077eab.
    [210-01-17-B.DXF, 210-01-17-B.SLDPRT, 210-01-23-B.SLDPRT, 210-03-17-A.SLDDRW, 210-03-22A - Copy.SLDPRT, 210-03-22A Original.SLDDRW, 210-03-22B Simplified.SLDDRW, 210-03-22B.SLDPRT]
2023-01-21 Front Corner Assembly Update
    [241-00-23-A.SLDASM]
2023-01-22 Front Corners Assembly
    [241-00-23-Ecar.SLDASM, 241-01-20-Ecar.SLDPRT, 241-02-20-Ecar.SLDPRT]
2023-01-22 modified clevis
    [211-19-23-A.SLDPRT]
2023-01-23 Corner Assembly Updates
    [241-00-23-Ecar.SLDASM]
2023-01-25 Ecar Front Corner Assembly Updates
    [241-00-23-Ecar.SLDASM, 241-05-20-Ecar.SLDPRT]
2023-01-26 Rear Ecar Corner Assembly
    [242-00-23-Ecar.SLDASM, 242-01-20-Ecar.SLDPRT, 242-02-20-Ecar.SLDPRT]
2023-01-27 Rear Ecar Corner Updates
    [242-00-23-Ecar.SLDASM]
2023-01-27 Ecar Corner Assembly Updates
    [241-00-23-Ecar.SLDASM, 242-00-23-Ecar.SLDASM]
2023-01-27 Ecar Fully Corner Assembly
    [240-00-23-Ecar.SLDASM]
2023-01-27 Rear Ccar Corner Updates
    [242-00-23A.SLDASM]
2023-01-27 Hot Bottle + Headrest Mount
    [281-17c-23-A.SLDPRT]
2023-01-27 clevis update
    [211-19-23-A.SLDPRT]
2023-01-29 adding plates
    [210-13-23 Inboard Spherical Cover.SLDPRT, 211-00-23A.SLDASM, 211-01-23-A-L.SLDPRT, 211-01-23-A.SLDPRT, 211-03-23-A.SLDPRT, 211-05-23-B-L.SLDPRT, 211-05-23-B.SLDPRT, 211-07-23-B-L.SLDPRT]
2023-01-29 front updates
    [210-13-23 Inboard Spherical Cover.SLDPRT, 211-00-23A.SLDASM, 211-01-23-A-L.SLDPRT, 211-01-23-A.SLDPRT, 211-03-23-A.SLDPRT, 211-05-23-B-L.SLDPRT, 211-05-23-B.SLDPRT, 211-07-23-B-L.SLDPRT]
2023-01-29 more covers and assembly stuff
    [210-01-23-B.SLDPRT, 212-00-23-A.SLDASM, 212-01-23-A-L.SLDPRT, 212-01-23-A.SLDPRT, 212-03-23-A-L.SLDPRT, 212-03-23-A.SLDPRT, 212-05-23-A-L.SLDPRT, 212-05-23-A.SLDPRT]
2023-01-29 fixed kin and mates
    [212-00-23-A.SLDASM, 212-01-23-A-L.SLDPRT, 212-01-23-A.SLDPRT, 212-03-23-A-L.SLDPRT, 212-03-23-A.SLDPRT, 212-05-23-A-L.SLDPRT, 212-05-23-A.SLDPRT, 212-07-23-A-L.SLDPRT]
2023-01-30 updated mount
    [221-01-23 Damper Mount.SLDPRT]
2023-01-30 updated clevis
    [211-25-23A AN5 Lower Inboard.SLDPRT]
2023-01-30 Bus Bar Drawings
    Bus Bar Bending Drawings
    [0.05 inch Lower DC Bus Bar Layout.DXF, 0.05 inch Lower DC Bus Bar Layout.SLDASM, 0.05 inch Upper DC Bus Bar Layout.DXF, 0.05 inch Upper DC Bus Bar Layout.SLDASM, 0.125 inch Bus Bar Layout.DXF, 0.125 inch Bus Bar Layout.SLDASM, 223e-338-03 Straight Fin Lid V2.SLDDRW, 223e-450-005 busbar 1 V2.SLDDRW]
2023-01-31 Front Wing Assembly changes
    [121-00-22A-Front Wing Assembly.SLDASM, 121-000-23A.SLDASM, 121-01-22A Front Wing Elements.SLDPRT, 121-100-23A.SLDASM, 121-101-23A Y-Brace.SLDPRT, 121-102-23A Elements.SLDPRT, 121-103-23A Outer Endplate.SLDPRT, 121-104-23A Inner Endplate.SLDPRT]
2023-02-02 minor hub changes
    thread on rear
    1.75 OD
    Fillets on brake hat
    [241-01-22-A.SLDPRT, 242-01-22-A.SLDPRT]
2023-02-02 toe clevis
    [E Toe Clevis.SLDPRT]
2023-02-02 updated drawings
    [241-01-22-A.SLDDRW, 242-01-22-A.SLDDRW]
2023-02-04 Steering Part Drawings
    [272-07-22A.SLDDRW, 272-08-22A.SLDDRW, 272-13-22A.SLDDRW, 272-14-22A.SLDDRW, 273-05-20-A.SLDDRW]
2023-02-05 Updated Bearing Blocks
    Added Bearing Blocks and Jack Bar Tabs along with waterjet files
    [335-01-23A Left Bearing Block.DXF, 335-01-23A.SLDPRT, 335-02-23A Right Bearing Block.DXF, 335-02-23A.SLDPRT, 335-03-23A Jack Bar Mounts.DXF, 335-03-23A.SLDPRT, Bearing Block Layout.DXF]
2023-02-06 Update 222-03-23 Bellcrank Mount.SLDPRT
    [222-03-23 Bellcrank Mount.SLDPRT]
2023-02-08 clearance tweaks
    [221-01-23 Damper Mount.SLDPRT, 221-03-23 Bellcrank Mount.SLDPRT]
2023-02-08 Revert "clearance tweaks"
    This reverts commit 5c451dd6c4db3f92896655fe42fe082961d300e6.
    [221-01-23 Damper Mount.SLDPRT, 221-03-23 Bellcrank Mount.SLDPRT]
2023-02-09 update hot bottle mount
    changed from four-rivet hole to three-rivet hole
    [281-17c-23-A.SLDPRT]
2023-02-13 jig updates
    [Front Jig Plate.SLDPRT, Front LCA Jig.SLDASM, Front Layout.SLDASM, Front Pushrod Tab.SLDPRT, Front UCA Jig.SLDASM, Front UCA Tab Upper.SLDPRT, Inboard Mount JIG-210-03-23-B.SLDPRT, Onbourd Mount JIG-210-03-19-B.SLDPRT]
2023-02-15 Working model for hole cross section
    [AP-CP4226-01 - Personal.SLDPRT, CP4226-2S0_04_17052021.step ( in progress).SLDPRT]
2023-02-16 Front wing shit
    [121-000-23A.SLDASM, 121-100-23A.SLDASM, 121-101-23A Y-Brace.SLDPRT, 121-200-23A.SLDASM, 121-210-23A Aluminum Subassembly.SLDASM, 121-211-23A Inner Spar.SLDPRT, 121-212-23A Clevis Spar.SLDPRT, 121-213-23A Fore Brace.SLDDRW]
2023-02-16 Endplate Updates
    [121-100-23A.SLDASM, 121-101-23A Y-Brace.SLDPRT, 121-102-23A Elements.SLDPRT, 121-103-23A Outer Endplate.SLDPRT, 121-104-23A Inner Endplate.SLDPRT]
2023-02-17 made new headrest mount
    [281-12-23-A Headrest Mount.SLDPRT]
2023-02-18 Penthouse Commits
    Penthouse Commits
    [223e-338-000 Cold Plate Straight Fin Assembly.SLDASM, 223e-338-01 Finned Base Plate Extended Reference Holes Drawing.SLDDRW, 223e-338-01 Finned Base Plate Extended.SLDDRW, 223e-338-01 Finned Base Plate Extended.SLDPRT, 223e-338-06 Rounded Half Support Plate.SLDPRT, 223e-342-01 Cold Plate O-Ring Groove Add.SLDPRT, 223e-410-17 Rotor Shim.DXF, 223e-410-17 Rotor Shim.SLDPRT]
2023-02-18 Side-wing Final update
    [124-100-23A - Side Wing CFD.SLDPRT, 124-101-23A - Mirror Side Wing CFD.SLDPRT, 124-200-23A - Mounting Assy.SLDASM, 124-201-23A - Horiz Wing.SLDPRT, 124-202-23A - Vert Wing.SLDPRT, 124-203-23A - Bottom End Cap.SLDPRT, 124-204-23A - Upper End Cap.SLDPRT, 124-205-23A - Joint.SLDPRT]
2023-02-19 goutam and jackson commits
    [121-211-23A Inner Spar.SLDPRT, 121-212-23A Clevis Spar.SLDPRT, 123-01-23A Non-Adjustable Endcap (165mm).SLDPRT, 123-02-23A Adjustable Endcap (165mm).SLDPRT, 124-204-23A - Upper End Cap.SLDPRT]
2023-02-19 created E stop main hoop plate
    [281-01e-23-A.SLDPRT, 281-02e-23-A Ehoop Estop Plate.SLDPRT]
2023-02-19 Committing front wing gooseneck mount and finished parts to active cad
    [121-300-23A Mounting Assembly.SLDASM, 121-301-23 - Gooseneck mount - iter 3.5 - final.SLDPRT, 121-301-23A Aft mounting offset.SLDPRT, 121-301-23A Fore mounting offset.SLDPRT, 121-302-23 - Sheet metal mono mount.SLDPRT, 121-302-23A Gooseneck mount iter 2.SLDPRT, 121-302-23A Gooseneck mount iter 3 complex.SLDPRT, 121-302-23A Gooseneck mount iter 4 smaller check.SLDPRT]
2023-02-20 spacer update
    [210-05-23B.SLDPRT]
2023-02-21 Last Part Drawings
    [121-211-23A Inner Spar.SLDDRW, 121-212-23A Clevis Spar.SLDDRW, 121-213-23A Fore Brace.SLDDRW, 121-214-23A Aft Rectangular Beam.SLDDRW]
2023-02-22 Updates/Manufacturing
    Endcaps, Gasket DXF, Mono Outer Mounting Plate
    [223e-342-000.SLDASM, 223e-410-18 Modified Rear Endcap.SLDDRW, 223e-410-18 Modified Rear Endcap.SLDPRT, 223e-410-19 Modified Front Endcap.SLDDRW, 223e-410-19 Modified Front Endcap.SLDPRT, 223e-450-000 V2.SLDASM, 223e-450-023 BusBar Holes.SLDASM, 223e-450-043 Slanted Lid.SLDPRT]
2023-02-22 fixed stuff
    [220-05-15A.SLDPRT, 221-00-23 Front Actuation Assembly.SLDASM, 221-03-23 Bellcrank Mount.SLDPRT, 221-05-23 Bellcrank Half.SLDPRT, 222-00-23 Rear Actuation Assrmbly.SLDASM, 222-03-23 Bellcrank Mount.SLDPRT, 222-05-23 Damper Mount.SLDPRT, 222-07-23 Bellcrank Half.SLDPRT]
2023-02-22 Upper Steering Updated Drawings
    [272-05-22A.SLDDRW, 272-15-22-A.SLDDRW]
2023-02-22 Updated Steering Drawing
    [273-15-22-A.SLDDRW]
2023-02-22 Updated Brake Hat
    [251-03-11C Updated Brake Hat.SLDPRT]
2023-02-23 added rivet
    [97526A005_Domed Head Blind Rivets.SLDPRT]
2023-02-24 angled bullshit
    [210-05-23B.SLDPRT, 212-00-23-A.SLDASM, 212-01-23-A-L.SLDPRT, 212-01-23-A.SLDPRT, 212-03-23-A-L.SLDPRT, 212-03-23-A.SLDPRT, 212-05-23-A-L.SLDPRT, 212-05-23-A.SLDPRT]
2023-02-24 Driveline Assy
    [321-00-23A.SLDASM, 321-01-23-A.SLDPRT, 321-17-23-A.SLDPRT, 321-19-23-A.SLDPRT, 330-00-23B (Skeleton Assembly).SLDASM, 332-05-23A.SLDPRT, Filler neck.SLDPRT, Sprocket_Skeleton.SLDPRT]
2023-02-26 Brake Hat updates to Corners
    [241-00-23-A.SLDASM, 241-01-23-C Front Hub.SLDPRT, 241-05-23C Front Encoder Ring.SLDPRT, 242-00-23A.SLDASM, 242-01-23-C Rear Hub.SLDPRT, 251-03-11E Front Brake Hat.SLDPRT, 251-03-23A Front Brake Hat.SLDPRT, 252-03-23A Rear Brake Hat.SLDPRT]
2023-02-26 waterjet bs
    [210-03-22B Suspension Inboard Clevis Simplified.DXF, 211-11-23-A.SLDPRT, 211-17-22A FL Suspension Spacer.DXF, 212-11-23-A.SLDPRT, 240-01-17B Camber Clevis.DXF, 241-15-22A Front Toe Clevis.DXF, 242-15-22A Rear Toe Clevis.DXF, 335-05-22A Diff Clevis.DXF]
2023-02-26 Updated Corner Assemblies
    [240-00-23A.SLDASM, 241-00-23-A.SLDASM, 242-00-23A.SLDASM]
2023-02-27 Motor lamination jig
    [3313N12_High-Strength Steel Threaded Rod.SLDPRT, 88695K17_Tight-Tolerance Oil-Hardening O1 Tool Steel Rod.SLDPRT, JigBasePlate.SLDPRT]
2023-02-27 Gasket Manufacturing
    Gasket Manufacturing
    [223e-410-18 Modified Rear Endcap.SLDPRT, 223e-410-19 Modified Front Endcap.SLDPRT, 223e-431-001 Cold Plate Connection Gasket.SLDDRW, 223e-431-001 Cold Plate Connection Gasket.SLDPRT, Gasket DXF Assy_v2.DXF]
2023-02-27 Lamination Jig Initial
    Lamination Jig
    [3313N12_High-Strength Steel Threaded Rod.SLDPRT, 3313N25_High-Strength Steel Threaded Rod.SLDPRT, 9588K81_Gold Chrome-Silicon Steel Spring.SLDPRT, JigBasePlate.SLDPRT, JigSpringPlate.SLDPRT, JigTopPlate.SLDPRT, Lamination Jig Assembly.SLDASM, Lamination Mock Stack.SLDPRT]
2023-02-28 Jig Assembly Initial
    Initial Lamination Stacking Jig
    [3313N762_High-Strength Steel Threaded Rod.SLDPRT, 88695K17_Tight-Tolerance Oil-Hardening O1 Tool Steel Rod.SLDPRT, 94895A031_High-Strength Steel Hex Nut.SLDPRT, JigBasePlate.SLDPRT, JigSpringPlate.SLDPRT, JigTopPlate.SLDPRT, Lamination Jig Assembly.SLDASM, Lamination Jig Assembly.STEP]
2023-02-28 Updated Brake Hat Drawings
    [251-03-23A Front Brake Hat.SLDDRW, 252-03-23A Rear Brake Hat.SLDDRW]
2023-02-28 Update to Brake Hat Drawings
    [251-03-23A Front Brake Hat.SLDDRW]
2023-03-02 Jig Updates
    Jig Updates
    [8893K451_Tight-Tolerance Oil-Hardening O1 Tool Steel Rod.SLDPRT, 91294A278_Black-Oxide Alloy Steel Hex Drive Flat Head Screw.SLDPRT, 9584K81_Red Chrome-Silicon Steel Die Spring.SLDPRT, JigBasePlate.SLDPRT, JigSpringPlate.SLDPRT, JigTopPlate.SLDPRT, Lamination Jig Assembly.SLDASM, Lamination Jig Assembly_v2.STEP]
2023-03-05 Gears, Endcap Manufacturing, Standoff
    Brought Gears into CAD, endcap cam files, rear standoff v2 stl
    [220e-241-08 Motor Adapter Plate.SLDPRT, 220e-310-02 Rotor.SLDPRT, 220e-310-03 Shaft.SLDPRT, 220e-310-04 SmCo Magnet Segment.SLDPRT, 220e-310-05 Cooled Housing.SLDPRT, 220e-310-07 Rotor Bearing 6804VV.SLDPRT, 220e-311-00 Rotor Assembly.SLDASM, 220e-312-00 Segmented SmCo Magnet.SLDASM]
2023-03-05 hub updates
    [241-01-23-C Front Hub.SLDPRT, 242-01-23-C Rear Hub.SLDPRT]
2023-03-06 antiroll change
    [KIN-01-23-E.SLDPRT]
2023-03-06 Front Wing Folder Rename
    [121-000-23A.SLDASM, 121-100-23A.SLDASM, 121-103-23A Outer Endplate.SLDPRT, 121-200-23A.SLDASM, 121-210-23A Aluminum Subassembly.SLDASM, 121-211-23A Inner Spar.SLDDRW, 121-211-23A Inner Spar.SLDPRT, 121-212-23A Clevis Spar.SLDDRW]
2023-03-06 drop link change
    [KIN-01-23-E.SLDPRT]
2023-03-06 dear amir
    maple syrup drinking motherfucker making me change my god damns shit
    [KIN-01-23-E.SLDPRT]
2023-03-07 Create Sam Spline Male.stp.SLDPRT
    [Sam Spline Male.stp.SLDPRT]
2023-03-08 Inner Endplate and Drawing Updates
    [121-103-23A Outer Endplate.SLDPRT, 121-104-23A Inner Endplate.SLDPRT, 121-211-23A Inner Spar.SLDDRW, 121-212-23A Clevis Spar.SLDDRW, 121-212-23A Clevis Spar.SLDPRT, 121-214-23A Aft Rectangular Beam.SLDDRW]
2023-03-08 Create 121-205-23A Inner Endplate Insert.SLDPRT
    [121-205-23A Inner Endplate Insert.SLDPRT]
2023-03-08 Hub and Brake Hat Part Drawings
    [241-01-23-C Front Hub.SLDDRW, 241-01-23-C Front Hub.SLDPRT, 242-01-23-C Rear Hub.SLDDRW, 242-01-23-C Rear Hub.SLDPRT, 252-03-23A Rear Brake Hat.SLDDRW, 252-03-23A Rear Brake Hat.SLDPRT]
2023-03-08 Fueling parts
    [325-02-23C Fuel Rail.SLDPRT, 325-03-23D Injector Boot.SLDPRT]
2023-03-10 Updated Hub Part Drawings
    [242-01-23-C Rear Hub.SLDDRW, 272-11-21-A.SLDDRW]
2023-03-10 Endcap and 3d print plates update
    [Endcap with AP Assembly.SLDASM]
2023-03-12 Endcaps and apdustability plate
    [121-000-23A.SLDASM, 121-100-23A.SLDASM, 121-101-23A Y-Brace (CFD).SLDPRT, 121-102-23A Elements.SLDPRT, 121-104-23A Inner Endplate.SLDPRT, 121-200-23A.SLDASM, 121-210-23A Aluminum Subassembly.SLDASM, 123-02-23A Adjustable Endcap (165mm).SLDPRT]
2023-03-13 broke external references
    [223l Floor Final.SLDPRT]
2023-03-13 More updates
    [121-000-23A.SLDASM, 121-100-23A.SLDASM, 121-102-23A Elements.SLDPRT, 121-213-23A Fore Brace.SLDPRT, 123-01-23A Non-Adjustable Endcap (165mm).SLDPRT, 123-03-23A Adjustability Plate (165mm).SLDPRT, Endcap with AP Assembly.SLDASM]
2023-03-16 Tank update
    [321-00-23A.SLDASM]
2023-03-22 Front wing merge
    [121-000-23A.SLDASM, 121-100-23A.SLDASM, 121-100-23A.x_t, 121-101-23A Y-Brace (CFD).SLDPRT, 121-102-23A Elements.SLDPRT, 121-103-23A Outer Endplate.SLDPRT, 121-104-23A Inner Endplate.DXF, 121-104-23A Inner Endplate.SLDPRT]
2023-03-22 Added new rear wing stuff to active cad rear wing folder
    [C-Car Wing Assembly.SLDASM, E-Car Wing Assembly.SLDASM, JacksonMeasurementsAndSuch_Assembly.SLDASM, JacksonPrep_Structural endplate 9 E-Car.SLDPRT, RearCleviceV4.SLDPRT, RearCleviceV5.SLDPRT, RearCleviceV6.SLDPRT, SEP 1 Mold Updated.SLDPRT]
2023-03-22 cleaned up clevis versions
    [RearCleviceV4.SLDPRT, RearCleviceV5.SLDPRT, RearClevisFinal.SLDPRT, SideCleviceRearWing.SLDPRT, SideClevisRearWingFinal.SLDPRT, WireMounts.SLDPRT, WireMountsFinal.SLDPRT]
2023-03-23 New Aero Dev Folder
    [111-01-22A Nosecone.SLDPRT, 112-01-22A Sidepod DL.SLDPRT, 112-02-22A Sidepod DR.SLDPRT, 112-03-22A Duct DL.SLDPRT, 121-000-23A.SLDASM, 121-100-23A.SLDASM, 121-101-23A Y-Brace.SLDPRT, 121-102-23A Elements.SLDPRT]
2023-03-23 whole lottashit
    [212-00-23-A.SLDASM, 212-01-23-A-L.SLDPRT, 212-01-23-A.SLDPRT, 212-03-23-A-L.SLDPRT, 212-03-23-A.SLDPRT, 212-05-23-A-L.SLDPRT, 212-05-23-A.SLDPRT, 212-07-23-A-L.SLDPRT]
2023-03-24 Rear Wing Updates
    [C-Car Wing Assembly.SLDASM, E-Car Wing Assembly.SLDASM, JacksonMeasurementsAndSuch_Assembly.SLDASM, JacksonPrep_Structural endplate 9 E-Car.SLDPRT, RearClevisFinal.SLDPRT, SEP 1 Mold Updated.SLDPRT, SEP 2 Mold Updated.SLDPRT, Shim.SLDPRT]
2023-03-24 steering cowling
    [114-01-23A.SLDPRT]
2023-03-25 Aero Assembly
    [1100 - Aero & Composites.SLDASM, 1101 - 0000 - 23 - Y-Brace.SLDPRT, 1101 - 0001 - 23 - Y-Brace (CFD).SLDPRT, 1101 - 0002 - 23 - Elements.SLDPRT, 1101 - 0003 - 23 - Outer Endplate.SLDPRT, 1101 - 0004 - 23 - Inner Endplate.SLDPRT, 1101 - 0005 - 23 - Inner Spar.SLDDRW, 1101 - 0005 - 23 - Inner Spar.SLDPRT]
2023-03-25 Full vehicle assembly 223
    [1000-5000-23.SLDASM, 1001-0001-23 - Simple Three View For Livery.SLDDRW]
2023-03-27 Front Wing CFD Changes
    [1101 - 0002 - 23 - Elements.SLDPRT, 1101 - 0003 - 23 - Outer Endplate.SLDPRT, 1101 - 0004 - 23 - Inner Endplate.SLDPRT, 1101 - 5000 - 23 - Front Wing.SLDASM, 1101 - 5001 - 23 - Elements & Endplates.SLDASM]
2023-03-27 CFD Front Wing Changes
    [1101 - 5000 - 23 - Front Wing.SLDASM, 1101 - 5001 - 23 - Elements & Endplates.SLDASM]
2023-03-30 Rear Wing Updates for Jackson
    [1100 - Aero & Composites.SLDASM, 1101 - 0002 - 23 - Elements.SLDPRT, 1101 - 0003 - 23 - Outer Endplate.DXF, 1101 - 0003 - 23 - Outer Endplate.SLDPRT, 1101 - 0004 - 23 - Inner Endplate.DXF, 1101 - 0004 - 23 - Inner Endplate.SLDPRT, 1101 - 0005 - 23 - Inner Spar.SLDDRW, 1101 - 0013 - 23 - Inner Endplate Insert.SLDPRT]
2023-03-30 mate Fixes
    [1101 - 0013 - 23 - Inner Endplate Insert.SLDPRT, 1101 - 5000 - 23 - Front Wing.SLDASM, 1101 - 5002 - 23 - Internal Structure.SLDASM, 1101 - 5005 - 23 - 3D Print Assembly.SLDASM, 121-301-23A Aft mounting offset.SLDPRT, 121-301-23A Fore mounting offset.SLDPRT, 121-390-23 - Mounting Assembly FEA.SLDASM]
2023-03-30 Folder Delete
    [121-300-23A Mounting Assembly.SLDASM, 121-301-23 - Gooseneck mount - iter 3.5 - final.SLDPRT, 121-301-23A Aft mounting offset.SLDPRT, 121-301-23A Fore mounting offset.SLDPRT, 121-302-23 - Sheet metal mono mount.SLDPRT, 121-302-23A Gooseneck mount iter 2.SLDPRT, 121-302-23A Gooseneck mount iter 3 complex.SLDPRT, 121-302-23A Gooseneck mount iter 4 smaller check.SLDPRT]
2023-03-30 3 view commit still scrap
    [1000-5000-23.SLDASM, 1001-0001-23 - Simple Three View For Livery.SLDDRW, 1001-5001-Chassis scrap assembly for simple 3-view.SLDASM]
2023-03-31 Aero assembly final and in full car
    [1000-5000-23 - Ccar 223.SLDASM, 1000-5000-23.SLDASM, 1000-8000-23 - Assembly for Livery 3-view.SLDASM, 1001-0001-23 - Simple Three View For Livery.SLDDRW, 1001-5001-Chassis scrap assembly for simple 3-view.SLDASM, 1001-8001-Chassis scrap assembly for simple 3-view.SLDASM, 1100 - 5000 Aero & Composites.SLDASM, 1100 - Aero & Composites.SLDASM]
2023-03-31 C Powertrain added to full car assembly
    [1000-5000-23 - Ccar 223.SLDASM, 1100 - 5000 Aero & Composites.SLDASM, 1100-5000-23C - Aero & Composites Assembly CCar.SLDASM, 1101 - 0013 - 23 - Inner Endplate Insert.SLDPRT, 1101 - 5000 - 23 - Front Wing.SLDASM, 1101 - 5002 - 23 - Internal Structure.SLDASM, 1101 - 5005 - 23 - 3D Print Assembly.SLDASM, 1101-0103-23 - Fore mounting offset.SLDPRT]
2023-03-31 added color
    [270-00-23-A.SLDASM, 272-00-23A.SLDASM, 272-05-22A.SLDPRT, 272-07-22A.SLDPRT, 272-08-22A.SLDPRT, 272-11-21-A.SLDPRT, 272-13-22A.SLDPRT, 272-14-22A.SLDPRT]
2023-03-31 added new pedals
    [260-00-23-A Full Pedal Assembly.SLDASM, 261-00-23-A Accel Side Assembly.SLDASM, 261-01-23A Carbon Accel Pedal.SLDPRT, 261-02-23-A Accel Pedal Right Side Insert.SLDDRW, 261-02-23-A Accel Pedal Right Side Insert.SLDPRT, 261-03-23-A Accel Pedal Left Side Insert.SLDDRW, 261-03-23-A Accel Pedal Left Side Insert.SLDPRT, 261-04-23-A Accel Pedal Center Rotation.SLDDRW]
2023-04-01 made drawing
    [Insert.SLDDRW]
2023-04-02 Full car assembly finished
    [1000-5000-23 - Ccar 223.SLDASM, 1100-5000-23C - Aero & Composites Assembly CCar.SLDASM, 1101 - 5000 - 23 - Front Wing.SLDASM, 1102 - 0000 - 23 - Nosecone & Aeroshield.SLDPRT, 1102 - 5000 - 23 - Nosecone & Aeroshield.SLDASM, 1104 - 0001 - 23 - Sidepod Left.SLDPRT, 1104 - 0002 - 23 - Sidepod Right.SLDPRT, 1104 - 5000 - 23 - Sidepods.SLDASM]
2023-04-02 First 3 View updates commit
    [1000-5000-23 - Ccar 223.SLDASM, 1001-0001-23 - Ccar 3-View Drawing.SLDDRW, 1100-5000-23C - Aero & Composites Assembly CCar.SLDASM, 1101 - 0000 - 23 - Y-Brace.SLDPRT, 1101 - 0002 - 23 - Elements.SLDPRT, 1101 - 0003 - 23 - Outer Endplate.SLDPRT, 1101 - 0004 - 23 - Inner Endplate.SLDPRT, 1101 - 5000 - 23 - Front Wing.SLDASM]
2023-04-02 added actuation slots and half mono model
    [1280-0000-23C Monocoque Half.SLDPRT, 1280-0000-23C Monocoque.SLDPRT]
2023-04-03 changed half side
    [1280-0000-23C Monocoque Half.SLDPRT]
2023-04-03 Internal Structure Drawin Update
    [1101 - 0003 - 23 - Outer Endplate.SLDPRT, 1101 - 0003 - 23 - Outer Endplate_FootplateExcluded.DXF, 1101 - 0003 - 23 - Outer Endplate_IncludingFootplate.DXF, 1101 - 0008 - 23 - Aft Rectangular Beam.SLDDRW, 1101 - 0008 - 23 - Aft Rectangular Beam.SLDPRT, 121-214-23A Aft Rectangular Beam.SLDPRT, 1300 - 23 - Powertrain.SLDASM, 281-01-22-A.SLDPRT]
2023-04-11 tire temp
    tire temp
    [291 - 1.SLDPRT, 291 - 2.SLDPRT, 291 - 3.SLDPRT, 291 - Front Left.SLDASM]
2023-04-12 Front Corner Hub Updates
    [241-00-23-A.SLDASM, 241-01-22B Front Hub.SLDPRT, 241-01-22B.SLDPRT]
2023-04-13 Added Hub and Brake Hat to Assembly
    [242-00-23A.SLDASM]
2023-04-16 Amir full car commit and updated parts
    [1001-0001-23 - Ccar 3-View Drawing.SLDDRW, 1100-5000-23C - Aero & Composites Assembly CCar.SLDASM, 1101 - 0013 - 23 - Inner Endplate Insert.SLDPRT, 1101 - 5000 - 23 - Front Wing.SLDASM, 1101 - 5001 - 23 - Elements & Endplates.SLDASM, 1101 - 5002 - 23 - Internal Structure.SLDASM, 1101 - 5004 - 23 - Aluminum Subassembly.SLDASM, 1101 - 5005 - 23 - 3D Print Assembly.SLDASM]
2023-04-20 Front Wing Layout changes
    [1101 - 0002 - 23 - Elements.SLDPRT, 1101 - 0003 - 23 - Outer Endplate.SLDPRT, 1101 - 0004 - 23 - Inner Endplate.SLDPRT, 1101 - 0013 - 23 - Inner Endplate Insert.SLDPRT, 1101 - 5000 - 23 - Front Wing.SLDASM, 1101 - 5001 - 23 - Elements & Endplates.SLDASM, 1101 - 5002 - 23 - Internal Structure.SLDASM, 1101 - 5004 - 23 - Aluminum Subassembly.SLDASM]
2023-05-08 Revert "antiroll change"
    This reverts commit afb3331e4c918fa4650f01ba95ea365dee08c8d8.
    [1200-0001-23-E - KIN Amir Version.SLDPRT]
2023-05-14 Revert "antiroll change"
    This reverts commit 49203e899cf4a4bb4e593585fa3e7f0925b6ce9f
    [1200-0001-23-E - KIN Amir Version.SLDPRT]
2023-05-14 old aero delete
    [100-00-22A.SLDASM, 110-00-22A.SLDASM, 111-01-22A.SLDPRT, 111-01-22A_Aeroshield_Drawing.SLDDRW, 111-02-22A_Nosecone_Drawing.SLDDRW, 112-01-22A Sidepod.SLDDRW, 112-01-22A.SLDPRT, 112-02-22A.SLDPRT]
2023-06-21 Create Inner Endplate Insert Waterjets.DXF
    [Inner Endplate Insert Waterjets.DXF]
2023-07-16 Revert "Deletes"
    This reverts commit 6768d03d741a103e665cfc8f4da2fb2830fec6b8
    [-02 Hose to -03 45o Neck Banjo.SLDPRT, -02 Hose to -03 Female.SLDPRT.SLDASM, -02 Hose to -03 STR EXT Neck Banjo Body.SLDPRT, -02 Hose to -03 STR EXT Neck Banjo.SLDASM, 1.12591780A594_Female Threaded Hex Standoff.SLDPRT, 1.SLDPRT, 10-32Caphead1inch.SLDPRT, 10-32halfInch.SLDPRT]
